Raesangur/UdeS_S7_APP1/datasheets/capacitors/cap_links.txt

https://www.youtube.com/watch?v=2MQyQUkwmMk
https://www.youtube.com/watch?v=BcJ6UdDx1vg
https://www.youtube.com/watch?v=usX_4WUa-PY
