Raesangur/UdeS_S7_APP1/P01 relève les bons coups de l'équipe P02.pdf

UNIVERSITÉ DE SHERBROOKE
Faculté de génie
Département de génie électrique et génie informatique

## VALIDATION ÉQUIPE P02

Conception avancée de systèmes électroniques GEI789

Présenté à
Jonathan Bouchard,
Réjean Fontaine

Présenté par
Frédéric BILODEAU – BILF0901 Pascal-Emmanuel-Lachance —LACP3102

### 30 janvier 2024

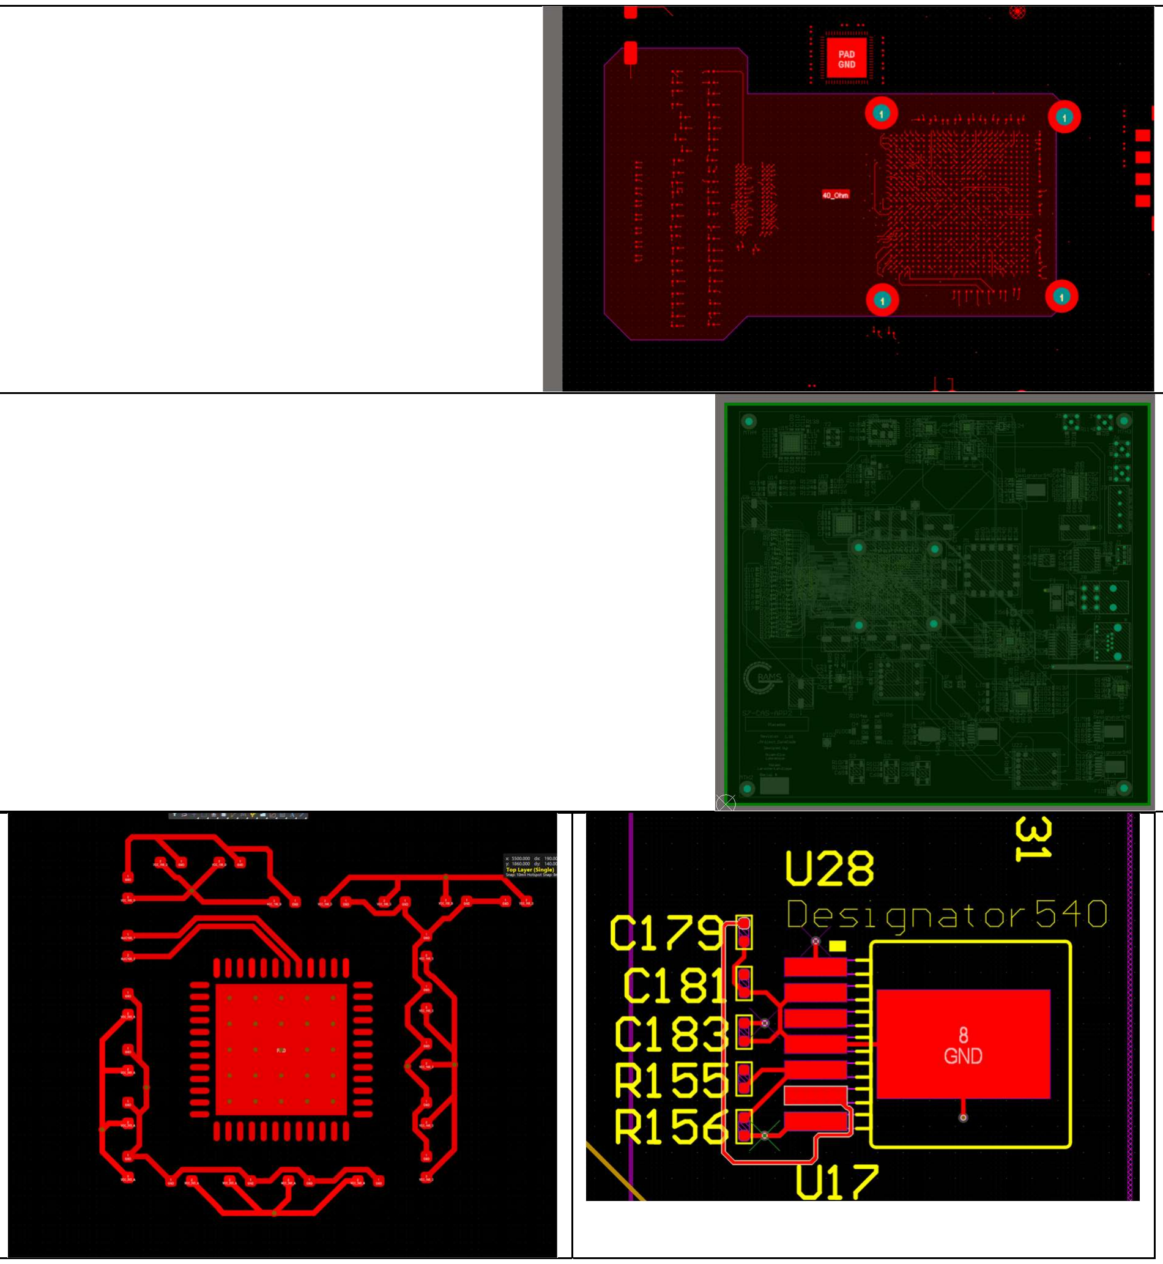
[picture p1: figure]

Mauvaise utilisation de room, les autres signaux comme le LVDS n’auront pas la bonne impédance sur la couche du top, celle que toutes les connections au FGPA sont obligé de faire (Room 40R plutôt que l’utilisation de Net Class).

Pas d’isolation (GND continu sur tout le PCB)

Idéalement il faut avoir un via de GND et de PWR pour chaque condensateur pour avoir le moins d’impédance possible sur ton power.

Il serait très pratique d’utiliser également le bottom pour mettre des composantes, ça aiderait à démêler tout les fils.

Qu’est-ce que `Designator540`?

Ça pourrait être pertinent d’utiliser des traces plus larges pour le power, encore pour réduire ton impédance. Ça s’applique autant aux régulateurs qu’à tous les condensateurs, surtout les gros électrolytiques.

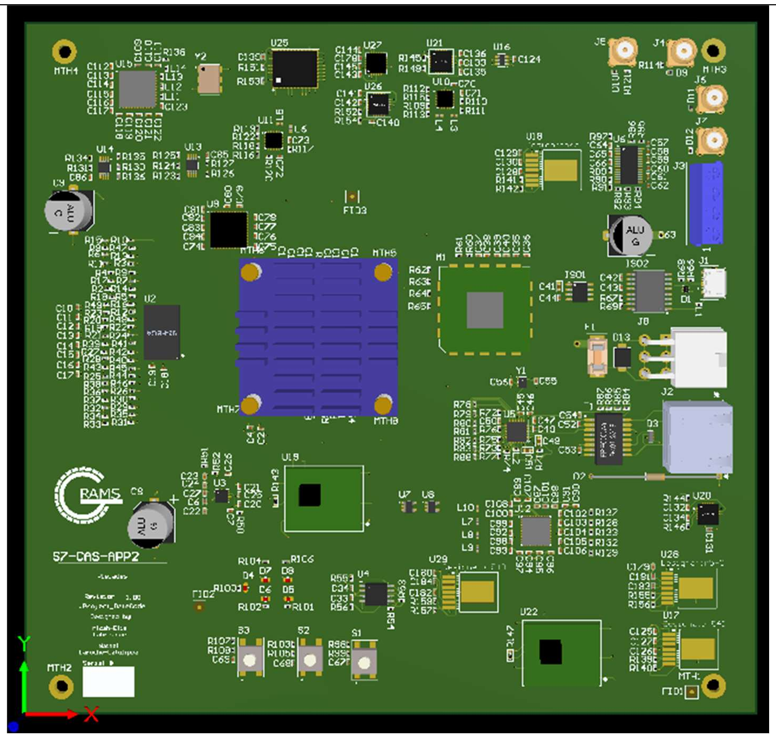
[picture p2: figure]

Beaucoup d’espace sur les côtés du PCB, ce qui facilite l’assemblage!
Le PCB est aussi d’une bonne taille qui rend le routage et le debugging plus facile.

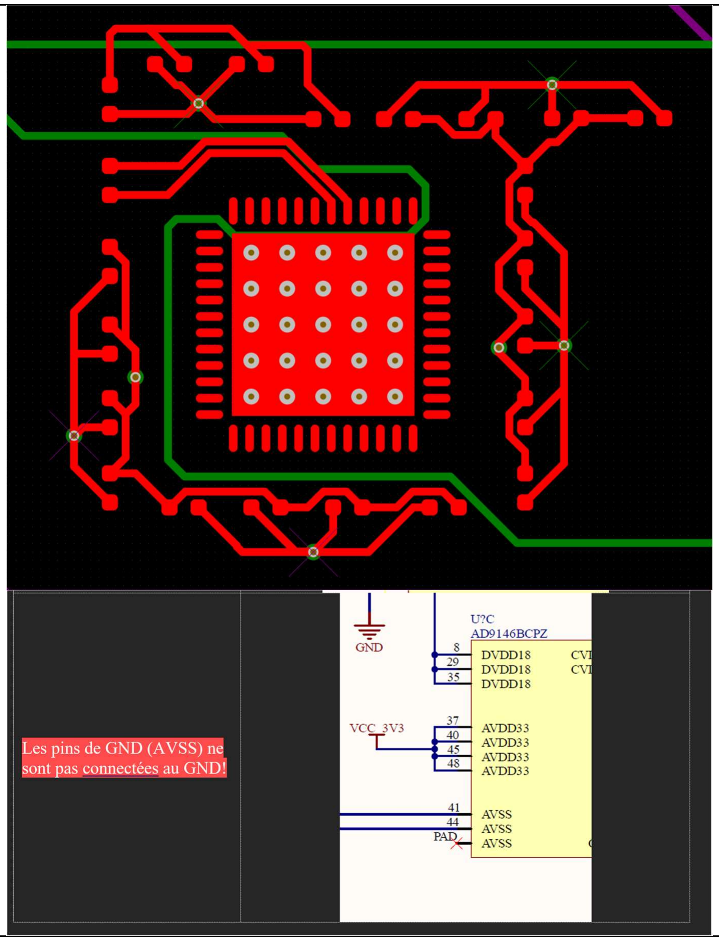
[picture p3: figure]

DAC sans GND
Le pad au centre n’est pas associé au NET GND. Voir commentaire de la revue de l’APP1

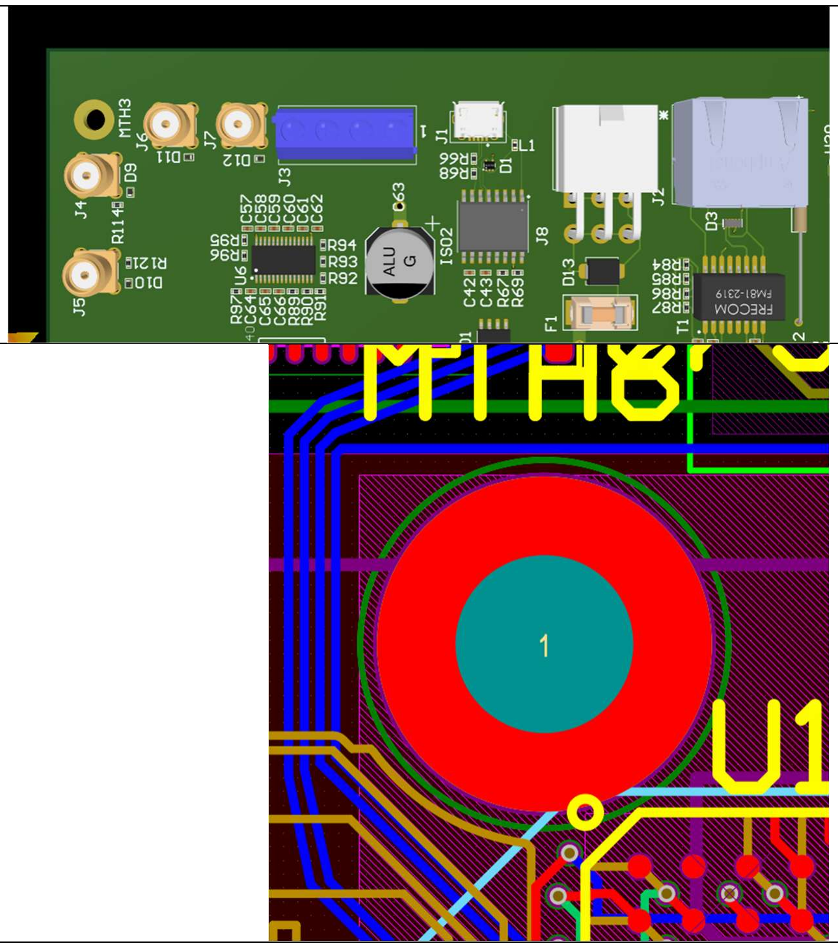
[picture p4: figure]

Très bien d’avoir mis tous les connecteurs d’un seul côté pour limiter l’effet d’antenne.

Le trou de montage du heatsink n’est pas connecté au GND, ce qui est important pour éviter que le heatsink agisse comme antenne.

Aussi qu’est-ce qui se passe avec les traces courbes?

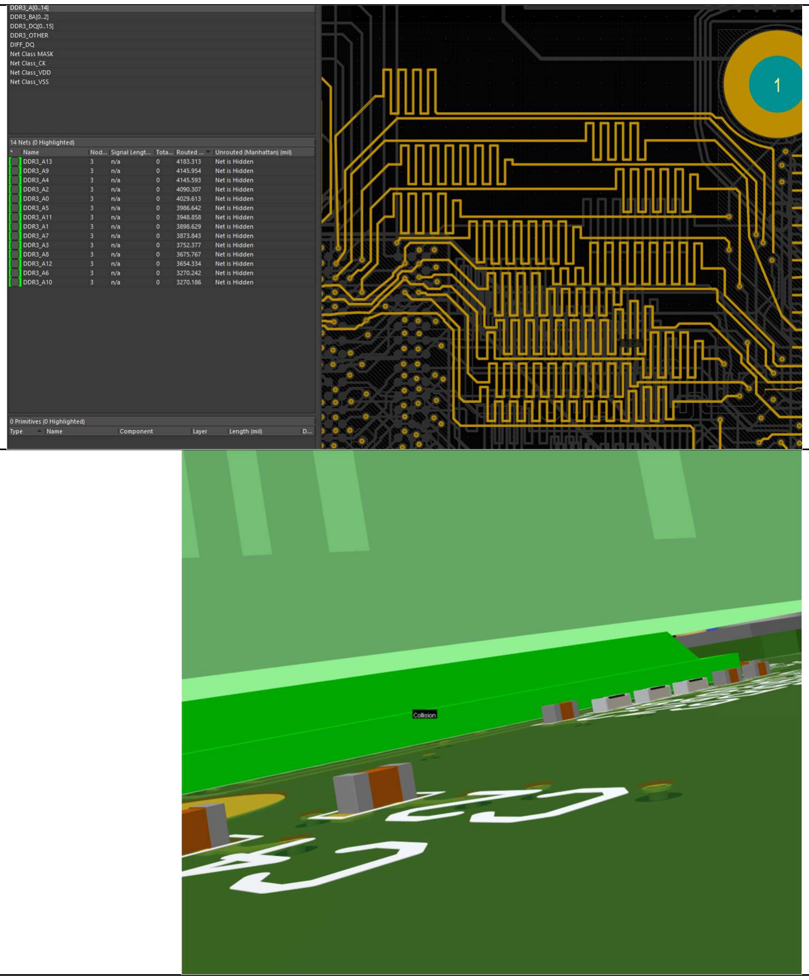
[picture p5: figure]

Le length matching n’est pas bien réalisé pour les adresses, avec plus d’un pouce de différence entre la trace la plus longue et la trace la plus courte.

Modele 3D non aligné.

Par contre c’est très cool d’avoir le modèle 3D pour le heatsink!

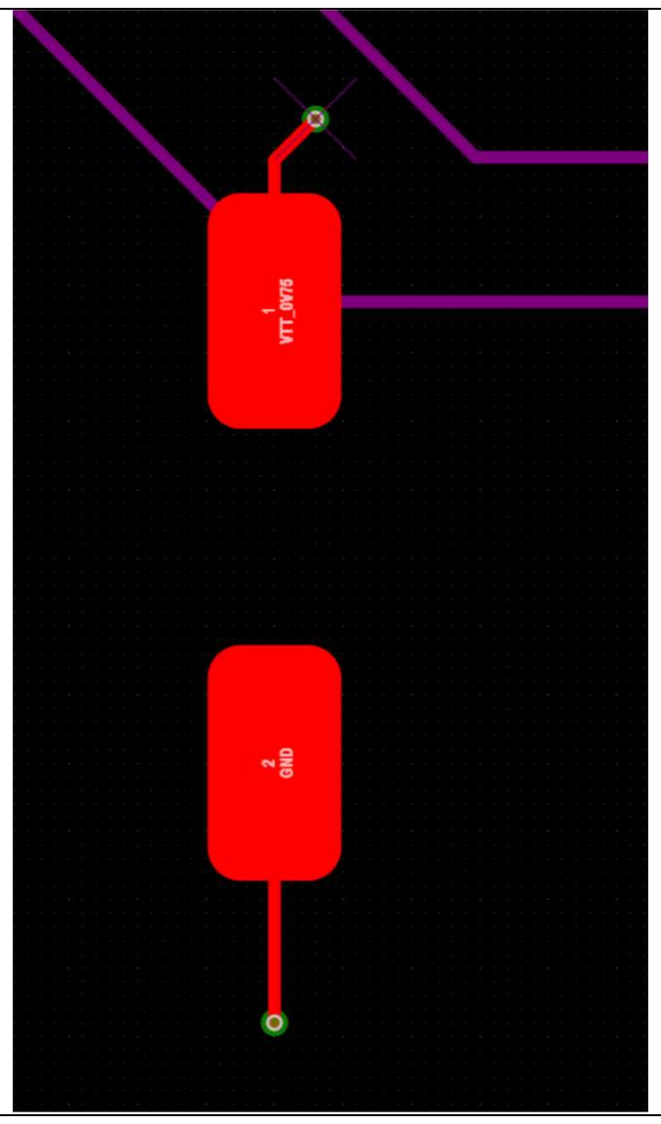
[picture p6: figure]

Distance des vias et largeurs des traces pour les grands condensateurs. J’aurais mis plus de vias des deux côtés ainsi que des traces plus larges pour réduire l’impédences

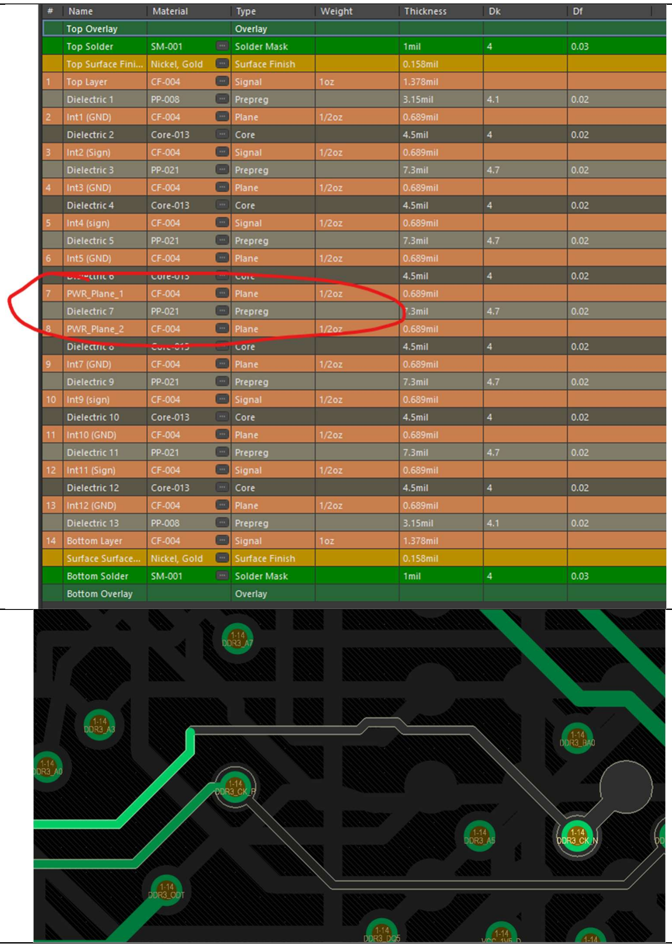
[picture p7: figure]

Il faut faire vraiment attention à des plans qui ne sont pas sandwitchés entre des GNDs, les deux couches de PWR peuvent se référencer entre elles et causer des effets indésirables.

Pas de via pour connecter CLK- entre Layer 3 et Layer 10!
Idéalement, lorsque tu as des changements de signaux, tu devrais aussi essayer de placer un via de GND proche afin de fournir un chemin pour le retour de courant.
Tu aurais pu router cette trace à partir de la layer

### 10 dès le début pour éviter le changement de

layer.

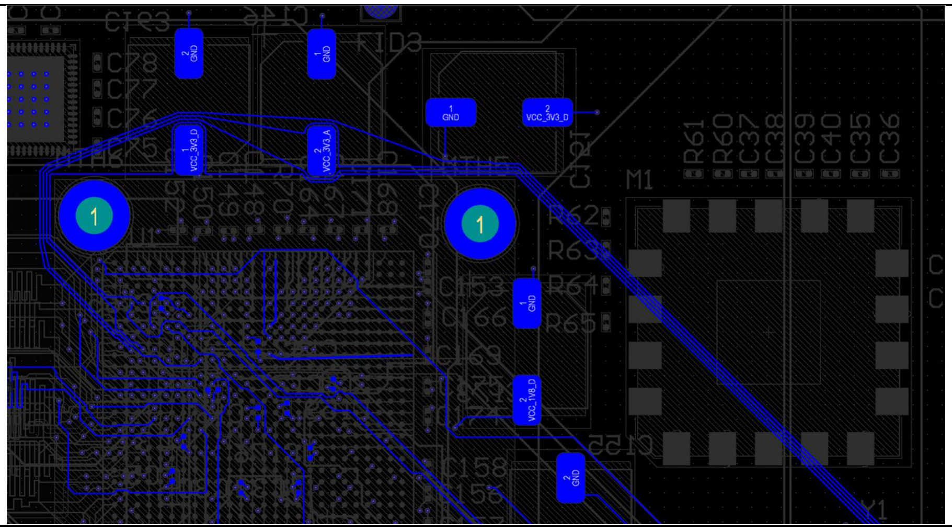
[picture p8: figure]

Il faudrait essayer de respecter la règle des « 3L » pour l’espacement entre des traces communiquant à haute vitesse.
Aussi encore qu’est-ce qui se passe autour des condensateurs ici??

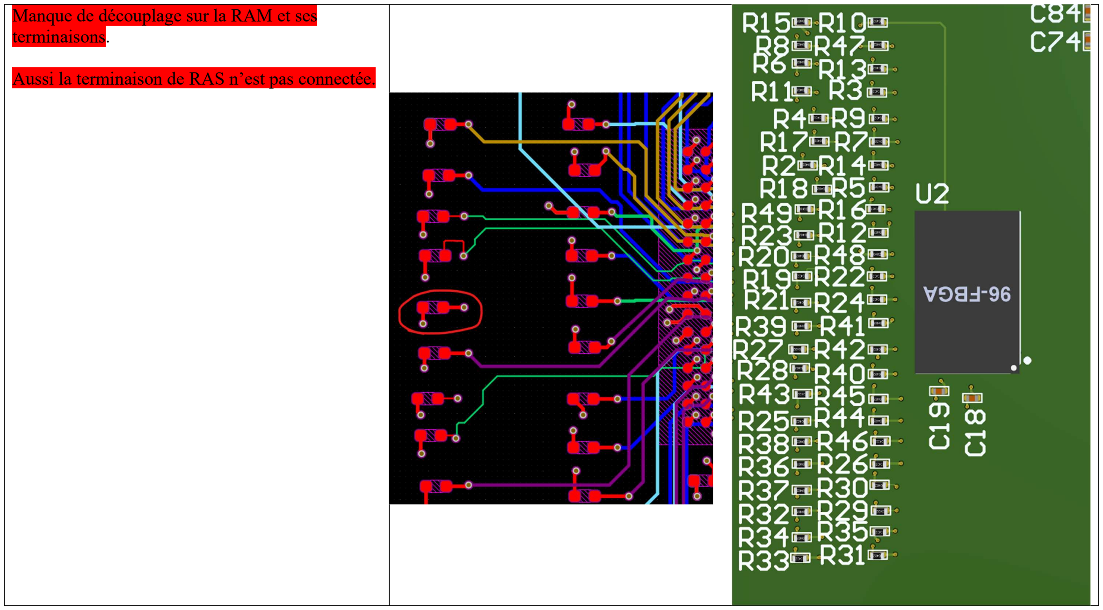
[picture p9: page 10]

Manque de découplage sur la RAM et ses terminaisons.

Aussi la terminaison de RAS n’est pas connectée.

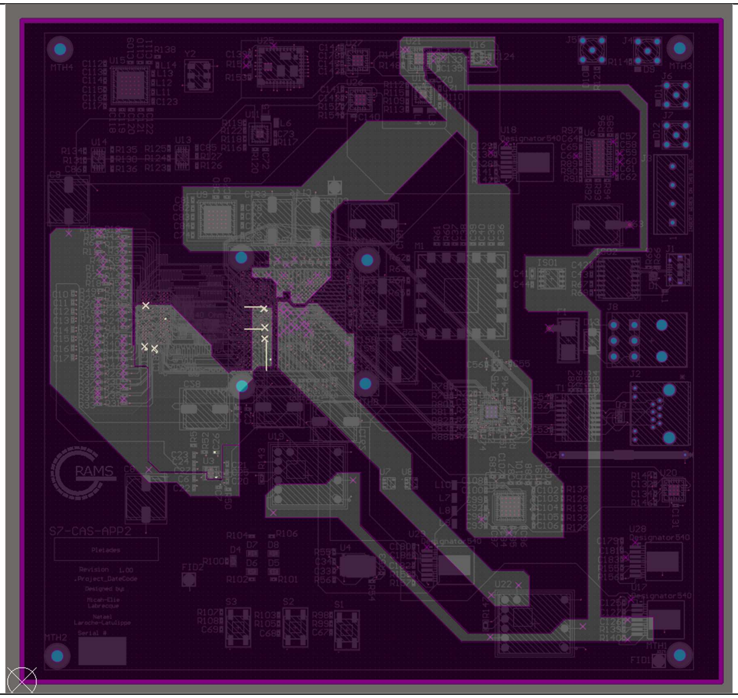
[picture p10: figure]

Gros planes de puissances qui aident à baisser l’impédance et qui relient bien les différentes sections avec des vias.
