Raesangur/UdeS_S7_APP1/Images/pleiades-constellation.png

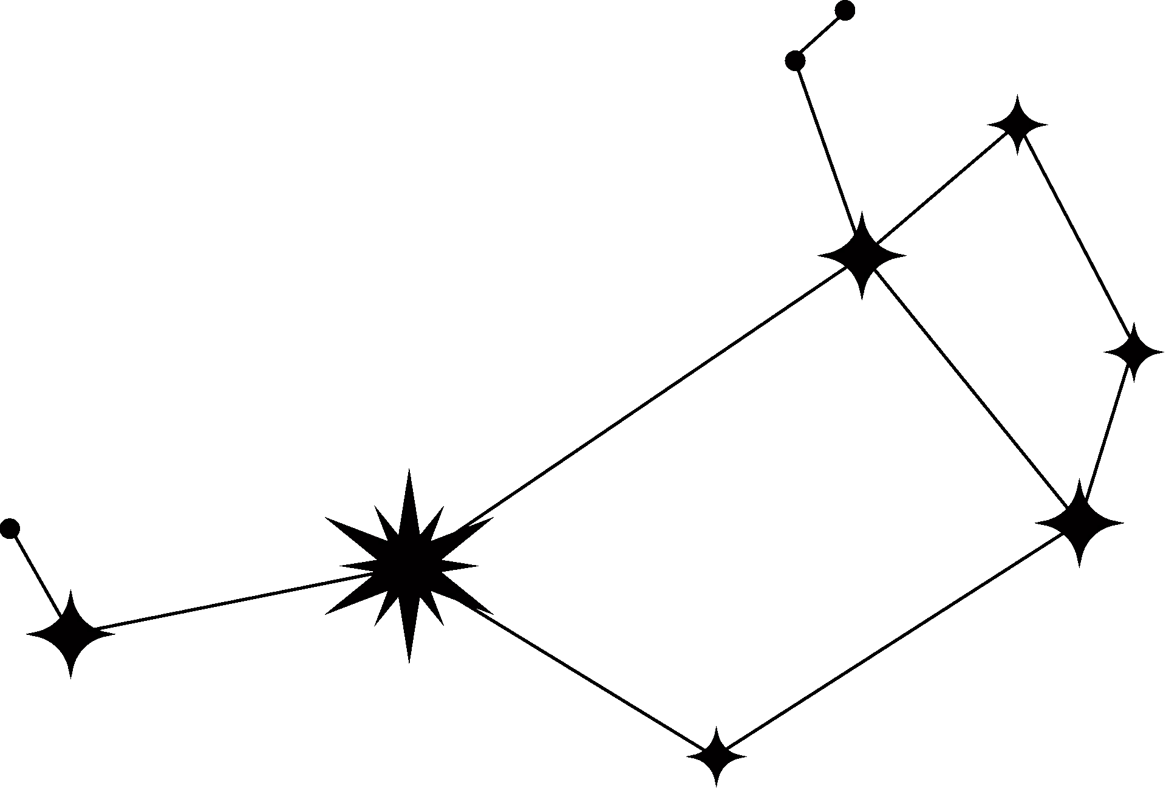
Images/pleiades-constellation.png
