Raesangur/UdeS_S7_APP1/Output/BOM.xlsx

Comment | Quantity | Designator | Description | Footprint | Mfr | Supplier 1 | Supplier Part Number 1
-6V | 1 | D47 | LED - 620nM RED 2mA - 0603 | LED_0603 |  | Digikey | 511-1304-1-ND
+1V2 | 1 | D45 | LED - 620nM RED 2mA - 0603 | LED_0603 |  | Digikey | 511-1304-1-ND
+1V8D | 1 | D50 | LED - 620nM RED 2mA - 0603 | LED_0603 |  | Digikey | 511-1304-1-ND
+2V5D | 1 | D51 | LED - 620nM RED 2mA - 0603 | LED_0603 |  | Digikey | 511-1304-1-ND
+3V3D | 1 | D48 | LED - 620nM RED 2mA - 0603 | LED_0603 |  | Digikey | 511-1304-1-ND
+6V | 1 | D49 | LED - 620nM RED 2mA - 0603 | LED_0603 |  | Digikey | 511-1304-1-ND
+12V | 1 | D46 | LED - 620nM RED 2mA - 0603 | LED_0603 |  | Digikey | 511-1304-1-ND
0R | 39 | R48, R49, R53, R57, R58, R63, R64, R65, R67, R68, R70, R167, R185, R187, R188, R191, R193, R196, R197, R202, R203, R212, R215, R221, R223, R226, R229, R230, R245, R247, R249, R259, R261, R263, R275, R283, R318, R319, RX25 |  | RES_0402
1K | 15 | R72, R73, R74, R75, R157, R182, R222, R289, R290, R308, R309, R312, R336, R337, RX13 |  | RES_0402
1K13 | 7 | R50, R90, R164, R273, R284, R322, RX12 |  | RES_0402
1M | 14 | R80, R81, R84, R165, R195, R205, R206, R213, R217, R225, R236, R317, R331, RX1 | 1M 0402 1% 1/16W Resistor | RES_0402
1nF | 18 | C1, C2, C3, C4, C219, C227, C228, C487, C502, C507, C508, C512, C544, C546, C549, C572, C603, CX15 | C1812C102KHRACAUTO 0402 470pF 10% X7R Ceramic Capacitor | CAP_1812 | KEMET | Mouser | 80-C1812C102KHRAUTO
1nF | 72 | C157, C166, C167, C168, C187, C188, C189, C207, C208, C209, C210, C211, C216, C217, C218, C248, C249, C255, C256, C264, C265, C271, C272, C296, C297, C298, C299, C300, C301, C302, C304, C305, C306, C310, C318, C319, C320, C321, C328, C329, C330, C331, C332, C341, C350, C351, C352, C362, C363, C369, C370, C387, C430, C432, C449, C515, C519, C523, C527, C553, C554, C567, C568, C575, C578, C584, C585, C590, C591, C597, C600, CX14 | GCM155R72A102KA37D 0402 1nF 10% X7R Ceramic Capacitor | CAP_0402 | Murata
1uF | 46 | C11, C18, C25, C32, C45, C46, C59, C60, C153, C161, C163, C181, C184, C201, C212, C274, C275, C276, C286, C287, C311, C326, C358, C398, C401, C404, C414, C434, C443, C444, C455, C466, C493, C496, C499, C534, C536, C550, C571, C573, C580, C581, C594, C595, C602, CX8 | GCJ31CR71H105KA12L 1206 1uF 10% X7R Ceramic Capacitor | CAP_1206 | Murata
2.2uF | 5 | C225, C226, C440, C524, CX7 | GRT31CR71H225KE13L 1206 2.2uF 10% X7R Ceramic Capacitor | CAP_1206 | Murata
3V3_PCI | 1 | D55 | LED - 620nM RED 2mA - 0603 | LED_0603 |  | Digikey | 511-1304-1-ND
4K7 | 23 | R14, R33, R47, R62, R87, R173, R179, R189, R194, R224, R246, R250, R251, R255, R256, R257, R258, R260, R262, R286, R320, R329, RX11 |  | RES_0402
4.7nF | 8 | C100, C371, C375, C381, C489, C492, C503, CX13 | GA343DR7GD472KW01L 0402 4.7nF 10% X7R 1812 250VAC Ceramic Capacitor | CAP_1812 | Murata
4.7uF | 12 | C103, C104, C113, C114, C115, C123, C128, C134, C139, C144, C148, CX4 | CGA8L2X7R1E475M160KA 1812 4.7uF 20% X7R Ceramic Capacitor | CAP_1206 | TDK | Newark | 57AK9414
5K1 | 10 | R158, R162, R163, R253, R287, R288, R313, R314, R327, RX10 |  | RES_0402
5V | 1 | D5 | LED - 620nM RED 2mA - 0603 | LED_0603 |  | Digikey | 511-1304-1-ND
5V_MOT | 1 | D34 | LED - 620nM RED 2mA - 0603 | LED_0603 |  | Digikey | 511-1304-1-ND
6K4 | 4 | R303, R311, R334, RX9 |  | RES_0402
10K | 21 | R82, R129, R142, R171, R172, R174, R175, R180, R181, R252, R271, R274, R276, R277, R278, R279, R295, R316, R338, R342, RX8 |  | RES_0402
10K5 | 5 | R214, R243, R244, R326, RX7 |  | RES_0402
10mR | 4 | R239, R241, R269, RX29 | CSRN2512FK10L0 | RES_2512
10uF | 38 | C101, C155, C159, C160, C162, C180, C183, C223, C230, C233, C234, C243, C250, C259, C266, C307, C338, C355, C365, C366, C384, C397, C400, C421, C425, C442, C445, C446, C447, C454, C483, C488, C490, C509, C531, C558, C562, CX6 | GRT31CR61H106KE01L 1206 10uF 10% X5R Ceramic Capacitor | CAP_1206 | Murata | Arrow Electronics, [NoParam] | GRT31CR61H106KE01L, [NoParam]
11R2 | 10 | R52, R93, R99, R104, R110, R112, R114, R119, R121, RX24 |  | RES_0402
12K | 4 | R89, R272, R324, RX6 |  | RES_0402
12V_PCI | 1 | D54 | LED - 620nM RED 2mA - 0603 | LED_0603 |  | Digikey | 511-1304-1-ND
16K9 | 2 | R339, RX5 |  | RES_0402
22pF | 8 | C197, C198, C199, C200, C510, C511, C530, CX19 | 0402 22pF 10% X7R 16V Ceramic Capacitor C0402C220K4RACAUTO, 0402 22pF X7R Ceramic Capacitor C0402C220K4RACAUTO | CAP_0402 | KEMET, [NoValue] | Mouser, [NoParam] | 80-C0402C220K4RAUTO, [NoParam]
22uF | 28 | C273, C285, C388, C389, C390, C392, C393, C394, C403, C407, C408, C413, C417, C433, C437, C438, C450, C451, C452, C462, C463, C465, C469, C470, C474, C475, C516, CX5 | CGA9P3X7R1H226M250KB 2220 22uF 20% X7R Ceramic Capacitor | CAP_2220 | TDK | Arrow Electronics | CGA9P3X7R1H226M250KB
24V_IN | 1 | D4 | LED - 620nM RED 2mA - 0603 | LED_0603 |  | Digikey | 511-1304-1-ND
24V_MOT | 1 | D33 | LED - 620nM RED 2mA - 0603 | LED_0603 |  | Digikey | 511-1304-1-ND
25K | 4 | R186, R218, R323, RX4 |  | RES_0402
30mR | 3 | R85, R240, RX28 | CSRN2512FK30L0 | RES_2512
40R2 | 40 | R15, R16, R17, R18, R19, R20, R21, R22, R23, R24, R25, R26, R27, R28, R29, R30, R31, R32, R34, R35, R36, R37, R38, R39, R40, R41, R42, R43, R44, R113, R120, R248, R296, R297, R298, R299, R300, R301, R302, RX23 |  | RES_0402
47K | 22 | R83, R86, R160, R161, R216, R242, R264, R265, R266, R267, R268, R270, R315, R325, R330, R343, R344, R345, R346, R347, R348, RX3 |  | RES_0402
47nF | 97 | C6, C7, C8, C9, C13, C14, C15, C16, C20, C21, C22, C23, C27, C28, C29, C30, C34, C35, C36, C37, C40, C41, C42, C43, C48, C49, C50, C51, C54, C55, C56, C57, C62, C63, C64, C65, C67, C68, C69, C70, C71, C72, C73, C74, C75, C76, C77, C78, C79, C80, C81, C82, C83, C84, C85, C86, C87, C88, C89, C90, C91, C92, C93, C94, C95, C96, C97, C98, C246, C247, C253, C254, C262, C263, C269, C270, C309, C314, C315, C316, C317, C340, C399, C402, C410, C411, C441, C456, C514, C518, C522, C526, C574, C579, C596, C601, CX12 | GCM155R71H473KE02J 0402 47nF 10% X7R Ceramic Capacitor | CAP_0402 | Murata
47uF | 4 | C416, C424, C557, CX3 | CGA9N1X7R1V476M230KC 2220 47uF 20% X7R Ceramic Capacitor | CAP_2220 | TDK | Newark | 57AK9414
49R9 | 25 | R91, R92, R125, R126, R127, R128, R130, R131, R132, R133, R134, R135, R136, R137, R138, R139, R140, R141, R143, R144, R145, R146, R147, R148, RX22 |  | RES_0603
56R2 | 3 | R98, R107, RX21 |  | RES_0402
60K4 | 2 | R117, R124 | RMCF0402FT60K4 | RES_0402
68pF | 19 | C172, C173, C174, C175, C176, C177, C178, C179, C193, C194, C195, C196, C281, C282, C283, C284, C292, C293, CX18 | 0201 68pF 5% C0G 50V Ceramic Capacitor CGA1A2C0G1H680J030BA, 0402 22pF 10% X7R 16V Ceramic Capacitor C0402C220K4RACAUTO | CAP_0402 | TDK, KEMET | Arrow Electronics, Mouser | CGA1A2C0G1H680J030BA, 80-C0402C220K4RAUTO
75R | 6 | R291, R292, R293, R294, R304, RX20 |  | RES_0402
100K | 25 | R54, R76, R77, R78, R79, R88, R111, R118, R149, R150, R151, R152, R154, R155, R159, R168, R176, R183, R220, R227, R228, R280, R281, R310, RX2 |  | RES_0402
100nF | 123 | C99, C132, C154, C156, C164, C165, C182, C185, C186, C202, C203, C204, C205, C206, C213, C214, C215, C220, C224, C235, C236, C237, C238, C239, C244, C245, C251, C252, C260, C261, C267, C268, C303, C308, C312, C313, C327, C339, C342, C343, C344, C347, C349, C356, C357, C359, C360, C361, C367, C368, C372, C373, C374, C376, C377, C378, C379, C380, C382, C383, C385, C386, C409, C419, C422, C423, C426, C427, C429, C431, C439, C448, C464, C471, C476, C477, C478, C479, C480, C484, C485, C486, C491, C494, C495, C497, C498, C504, C505, C506, C513, C517, C520, C521, C525, C528, C529, C532, C533, C535, C537, C538, C539, C540, C541, C542, C543, C545, C547, C548, C551, C552, C559, C560, C563, C564, C569, C570, C582, C583, C592, C593, CX11 | GCM155R71H104KE02J 0402 100nF 10% X7R Ceramic Capacitor | CAP_0402 | Murata
100R | 8 | R45, R46, R59, R61, R332, R333, R340, RX19 |  | RES_0402
120R | 2 | R166, RX18 |  | RES_0402
150mR | 4 | R153, R156, R219, RX27 | CSRN2512FKR150 | RES_2512
174R | 7 | R115, R116, R122, R123, R282, R307, RX17 |  | RES_0603
220nF | 5 | C345, C346, C348, C364, CX10 | GCM188R71H224KA64D 0603 220nF 10% X7R Ceramic Capacitor | CAP_0603 | Murata
240R | 4 | R13, R66, R305, RX16 |  | RES_0603
330pF | 29 | C158, C241, C242, C257, C258, C294, C295, C322, C323, C324, C325, C333, C334, C335, C336, C337, C555, C556, C565, C566, C576, C577, C586, C587, C588, C589, C598, C599, CX17 | GCM155R72A331KA37D 0402 330pF 10% X7R Ceramic Capacitor | CAP_0402 | Murata | Arrow Electronics | GCM155R72A331KA37D
330R | 8 | R60, R96, R97, R105, R106, R306, R328, RX15 | 1M 0603 1% 1/16W Resistor | RES_0603
410-357-B | 1 | M1 | MOD - JTAG-SMT3-NC Programming Module For Xilinx FPGA - 18-SMT | MOD_JTAG_410-357-B |  | Digi-Key | 1286-1196-ND
470nF | 58 | C5, C10, C12, C17, C19, C24, C26, C31, C33, C38, C39, C44, C47, C52, C53, C58, C61, C66, C105, C106, C107, C108, C109, C110, C116, C117, C118, C119, C120, C121, C124, C125, C126, C129, C130, C131, C135, C136, C140, C141, C142, C145, C146, C149, C288, C289, C391, C395, C396, C418, C428, C453, C457, C458, C459, C500, C501, CX9 | CGA3E3X7R1H474K080AB 0603 470nF 10% X7R Ceramic Capacitor | CAP_0402 | TDK
470pF | 14 | C169, C170, C171, C190, C191, C192, C240, C277, C278, C279, C280, C290, C291, CX16 | GCM155R71H471KA37J 0402 470pF 10% X7R Ceramic Capacitor | CAP_0402 | Murata
500mR | 3 | R184, R211, RX26 |  | RES_2512
590BD-BDG | 1 | Y1 | TIM - OSC PROG 125MHz ~ 214.999MHz LVDS 3.3V 7PPM EN/DS - 6-SMD | OSC_590BD-BDG |  | Digi-Key | 590BD-BDG-ND
768R | 17 | R94, R95, R100, R101, R102, R103, R108, R109, R169, R170, R177, R178, R254, R285, R321, R335, RX14 |  | RES_0402
3568 | 1 | F1 | FUSE HOLDER BLADE | 3568 | Keystone
0297010.WXNV | 1 | F2 | FUSE AUTO 10A 32V BLADE MINI | 0297010.WXNV | Littelfuse
0039300060 | 1 | J26 | CON - Mini-Fit Through Hole, Right Angle 6 position | CON_MINIFIT_0039300060 |  | Digi-Key | WM21353-ND
782633601 | 5 | FB1, FB2, FB3, FB4, FBX1 | 600 Ohms @ 100 MHz 1 Signal Line Ferrite Bead 0603 (1608 Metric) 1A 200mOhm | IND_0603 |  | Digikey | 732-6703-1-ND
782853152 | 5 | FB5, FB6, FB7, FB8, FBX2 | 600 Ohms @ 100 MHz 1 Signal Line Ferrite Bead 0603 (1608 Metric) 1A 200mOhm | IND_0805
5025700893 | 1 | J36 | 10 (8 + 2) Position Card Connector Secure Digital - microSD™ Surface Mount, Right Angle Gold | MICROSD_5025700893
74439346100 | 3 | L1, L4, LX2 | Generic Inductor | 74439346100 |  | Digikey | 732-10707-1-ND
ACPL-M72T | 2 | ISO1, ISO3 | Logic Output Optoisolator Push-Pull, Totem Pole 4000Vrms 1 Channel 25kV/µs CMTI 5-SO | SOIC-5_4.4MM | Broadcom Limited
AD8056ARMZ | 1 | U11 | OPAMP - VFB 300MHZ - 8MSOP | OPAMP_AD8056ARMZ |  | Digikey | AD8056ARMZ-REEL7CT-ND
AD9146BCPZ | 1 | U10 | DAC - 16BIT SRL HIGH SPEED - QFN-48 | DAC_AD9146BCPZ |  | Digikey | AD9146BCPZ-ND
ADA4927-2YCPZ-R2 | 1 | U9 | OPAMP - CFA 2.3GHZ - QFN-24 | OPAMP_ADA4927-2YCPZ-R2 |  | Digikey | ADA4927-2YCPZ-R2CT-ND
ADM3057EBRWZ | 1 | U17 | 1/1 Transceiver, Isolated CANbus 20-SOIC | SOIC-20_7.5mm | Analog Devices | Mouser | 584-ADM3057EBRWZ
ADM3260ARSZ | 1 | U47 | I2C Digital Isolator 2500Vrms 2 Channel 25kV/µs CMTI 20-SSOP (0.209", 5.30mm Width) | TSSOP-20_5.3MM | Analog Devices
ADN4652BRSZ-RL7 | 2 | U44, U46 |  | TSSOP-20_5.3MM | Analog Devices | Mouser | 584-ADN4652BRSZ-RL7
ADS62P48IRGCT | 1 | U8 | ADC - 14 BIT 210MSPS SUAL - VQFN-64 | ADC_ADS62P48IRGCT |  | Digikey | 296-24611-1-ND
ADS7957QDBTRQ1 | 1 | U41 | 10 Bit Analog to Digital Converter 16 Input 1 SAR 38-TSSOP | TSSOP-38_4.4MM | Texas Instruments | Mouser | 595-ADS7957QDBTRQ1
ADUM3160BRWZ-RL | 1 | ISO2 | ISO - DGTL ISO 2.5KV 2CH USB - 16SOIC | ISO_ADUM3160BRWZ-RL |  | Digi-Key | ADUM3160BRWZ-RLCT-ND
ASCH0010050547NJCP | 9 | L5, L6, L7, L8, L9, L10, L11, L12, LX1 | Generic Inductor | IND_0402 |  | Mouser, Digikey | 673-ASCH10050547NJCP, 553-ASCH00100505R10JCPTR-ND
ATS-CPX025025015-166-C1-R0 | 2 | HEAT1, HEAT3 | Heatsink Aluminium | ATS-CPX025025015-166-C1-R0 | Advanced Thermal Solutions Inc. | Digikey | ATS35911-ND
ATS-H1-152-C2-R0 | 1 | HEAT2 | Heatsink Aluminium | ATS-H1-152-C2-R0 | Advanced Thermal Solutions Inc. | Digikey | ATS36354-ND
B340B-13-F | 7 | D14, D15, D16, D17, D42, D43, DX2 | Generic Shottkey Diode, VS-15MQ040HM3/5AT | DO214AA (SMB) | Diodes Incorporated, [NoParam] | Future Electronics, [NoParam] | 6160261, [NoParam]
BATTERY_IN | 1 | J27 |  | XT90
BAV99-7-F | 25 | D1, D2, D19, D22, D25, D26, D27, D28, D29, D30, D31, D32, D36, D38, D39, D58, D59, D60, D61, D62, D63, D64, D65, D66, DX4 | Diode Array 1 Pair Series Connection 75 V 300mA (DC) Surface Mount TO-236-3, SC-59, SOT-23-3 | SOT23-3 | Diodes Incorporated | Future Electronics | 3851920
BSH105 | 2 | Q6, Q7 | BSH105 | SOT23-3 |  | Avnet | BSH105,215
CAN | 1 | D18 | LED - 611nM ORANGE 2mA - 0603 | LED_0603 |  | Digikey | 511-1303-1-ND
CAN_TERM | 1 | J34 |  | HEADER-2_100MIL
CANBUS | 1 | J33 |  | HEADER-4_100MIL
CDCE62005RGZT | 1 | U4 | TIM - CLK SYNTH JITTER CLEANER 3:5 - QFN-48 | TIM_CDCE62005RGZT |  | Digikey | 296-23947-1-ND
DEBUG1 | 1 | SW2 | SWI - TACT SPST-NO 0.05A 24V - 4-SMD | SWI_TACT_B3SN-3012P |  | Digikey | SW261CT-ND
DEBUG2 | 1 | SW3 | SWI - TACT SPST-NO 0.05A 24V - 4-SMD | SWI_TACT_B3SN-3012P |  | Digikey | SW261CT-ND
DEBUG IO CONNECTOR | 1 | J37 |  | HEADER-16_100MIL
DLM11SN900HY2L | 2 | L13, L14 | 2 Line Common Mode Choke Surface Mount 90 Ohms @ 100MHz 100mA DCR 1.38Ohm | DLM11SN900HY2L |  | Digi-Key | 490-11941-1-ND
DNF | 2 | C151, C152 | [NoValue], 0402 100nF X7R Ceramic Capacitor | CAP_0402
DNF | 36 | R1, R2, R3, R4, R5, R6, R7, R8, R9, R10, R11, R12, R51, R55, R56, R69, R71, R190, R192, R198, R199, R200, R201, R204, R207, R208, R209, R210, R231, R232, R233, R234, R235, R237, R238, R341 |  | RES_0402
DRV8811PWPR | 1 | U13 | POW - STEPPER MOTOR DRIVER - SOP-28 | POW_MOTOR_DRV8811PWPR |  | Digikey | 296-24591-1-ND
DS2411R | 1 | U21 | Silicon Serial Number SOT-23-3 | SOT23-3 | Analog Devices
FAN | 1 | J10 |  | FAN_HEADER-4
FQD8P10TM-F085 | 2 | Q1, Q2 | P-Channel 100 V 6.6A (Tc) 2.5W (Ta), 44W (Tc) Surface Mount TO-252AA | DPAK | onsemi
GST280A24-C6P | 1 | WA1 | UND - AC/DC DESKTOP ADAPTER 24V 280W - MEC | Model Name |  | Digi-Key | 1866-2122-ND
H1102NLT | 1 | T1 | TRANSFO - ETHERNET 10/100B-TX - SMD-16 | TRANSFO_H1102NLT |  | Digikey | 553-1532-1-ND
IN1 | 1 | J28 | 5-1814400-1 CONN - SMA JACK R/A 50 OHM - TH | CONN_SMA_5-1814400-1 |  | Digikey | A97593-ND
IN2 | 1 | J29 | 5-1814400-1 CONN - SMA JACK R/A 50 OHM - TH | CONN_SMA_5-1814400-1 |  | Digikey | A97593-ND
INA214AQDCKRQ1 | 1 | U35 | Current Sense Amplifier 1 Circuit Single-Ended SC-70-6 | SC-70-6 (SOT-363) | Texas Instruments | Mouser
INA4180A1QPWRQ1 | 2 | U40, U42 | Current Sense Amplifier 4 Circuit Differential, Rail-to-Rail 14-TSSOP | TSSOP-14_4.4MM | Texas Instruments | Mouser | 595-INA4180A1QPWRQ1
IRE-12/10-Q12P-C | 1 | U6 | Isolated DC/DC Converters - Through Hole 9V-36VIN 24VOUT 120W | IRE-Q12 | Murata | Digikey | 811-IRE-12/10-Q12P-C-ND
IRE-24/5-Q12P-C | 1 | U37 | Isolated DC/DC Converters - Through Hole 9V-36VIN 24VOUT 120W | IRE-Q12 | Murata | Mouser | 580-IRE-24/5-Q12P-C
ISO7741DBQR | 1 | U43 | ISO - Quad-Channel Digital Isolator 3/1 (Default High)- 16-SSOP | ISO_ISO7741DBQR |  | Digi-Key | 296-47660-1-ND
ISO7741FDBQR | 1 | U33 | ISO - Quad-Channel Digital Isolator 3/1 (Default Low)- 16-SSOP | ISO_ISO7741FDBQR |  | Digi-Key | 296-48140-1-ND
JUMPER | 12 | J2, J3, J4, J5, J11, J13, J14, J15, J16, J21, J24, J35
KSZ8091MNXCA | 1 | U38 | COM - ETHERNET PHY 10/100 - QFN-32 | COM_ETH_PHY_KSZ8091MNXCA |  | Digikey | 576-4356-ND
LED1 | 1 | D20 | LED - 611nM ORANGE 2mA - 0603 | LED_0603 |  | Digikey | 511-1303-1-ND
LED2 | 1 | D21 | LED - 611nM ORANGE 2mA - 0603 | LED_0603 |  | Digikey | 511-1303-1-ND
LED3 | 1 | D23 | LED - 611nM ORANGE 2mA - 0603 | LED_0603 |  | Digikey | 511-1303-1-ND
LED4 | 1 | D24 | LED - 611nM ORANGE 2mA - 0603 | LED_0603 |  | Digikey | 511-1303-1-ND
LFXTAL010595 | 1 | X1 | 25 MHz ±30ppm Crystal 16pF 40 Ohms HC-49/US | HC49_SMD |  | Newark | 94X0915
LMZ23605TZE/NOPB | 5 | U22, U27, U30, U31, U32 | REG - IC BUCK SYNC 36V 5A - TO-PMOD-7 | REG_SWR_LMZ23605TZE/NOPB |  | Digi-Key | 296-35357-1-ND
M3 | 8 | MT1, MT2, MT3, MT4, MT5, MT6, MT7, MT8 |  | MTH_M3
M3_SCREW | 14 | H2, H4, H6, H8, H10, H12, H14, H16, H18, H19, H20, H21, H22, H23
MAL214699108E3 | 4 | C221, C231, C481, CX1 | CAP - ALU 470uF 20% 50V - 1616 | CAP_ALU_1616_vishay |  | Digikey | 4442PHCT-ND
MAL215099101E3 | 24 | C102, C111, C112, C122, C127, C138, C143, C222, C232, C353, C354, C405, C406, C412, C415, C435, C436, C460, C467, C468, C472, C482, C561, CX2 | CAP - ALU 100uF 20% 50V - 1010 | CAP_ALU_1010_vishay |  | Digikey | 4399PHDKR-ND
MOT ON/OFF | 1 | SW4 | Slide Switch SPDT Through Hole | 1101M2S3CQE2 | C&K | Arrow Electronics | 1103M2S3CQE2
MOTORS | 1 | J32 | CONN - TERMINAL BLOCK 4POS 5MM - TH | CONN_TERMINAL_OSTTA040161 |  | Digikey | ED2602-ND
MT41K512M16HA-125 :A | 1 | U1 | DRAM 8G 1.35V 512Mx16 800 MHz DDR3 0C-90C | FBGA-96 | Alliance Memory | Mouser | 913-41K512M16HA125A
MTS-20 | 8 | H3, H5, H7, H9, H11, H13, H15, H17 |  | STANDOFF_MTS-20 |  | Digikey | RPC1573-ND
NCV2931ADT5.0RKG | 2 | U7, U36 |  | DPAK |  | Mouser | 863-NCV2931ADT5.0RKG
ON/OFF | 1 | SW1 | 1103M2S3CQE2 Slide Switch SPDT Through Hole | 1101M2S3CQE2 | C&K | Arrow Electronics | 1103M2S3CQE2
OPA991IDBVR | 1 | U39 | General Purpose Amplifier 1 Circuit Rail-to-Rail SOT-23-5 | SOT23-5 | Texas Instruments | Mouser | 595-OPA991IDBVR
OUT1 | 1 | J30 | 5-1814400-1 CONN - SMA JACK R/A 50 OHM - TH | CONN_SMA_5-1814400-1 |  | Digikey | A97593-ND
OUT2 | 1 | J31 | 5-1814400-1 CONN - SMA JACK R/A 50 OHM - TH | CONN_SMA_5-1814400-1 |  | Digikey | A97593-ND
PCI_RST | 1 | J22 |  | HEADER-2_100MIL
PLT10HH101150PNL | 2 | L2, L3 | IND - 2 Line Common Mode Choke Surface Mount 100 Ohms @ 10MHz 15A DCR 2.3 mOhm - SMD (12.9mm L x 6.6mm W x 9.4mm H) | IND_PLT10HH101150PNL |  | Digi-Key | 490-12821-1-ND
PTN04050AAZT | 1 | U25 | REG - SWR -15 ~ -3.3V 1A 6W - 5-SMD | REG_SWR_PTN04050AAZT |  | Digi-Key | 296-32208-1-ND
RESET | 1 | D41 | LED - 611nM ORANGE 2mA - 0603 | LED_0603 |  | Digikey | 511-1303-1-ND
RESET | 1 | SW5 | SWI - TACT SPST-NO 0.05A 24V - 4-SMD | SWI_TACT_B3SN-3012P |  | Digikey | SW261CT-ND
RFUSE | 1 | J23 |  | HEADER-2_100MIL
RJHSE-5385 | 1 | J39 | CONN - MOD JACK RJ45 R/A ETHERNET - TH | CONN_ETHERNET_RJHSE-5385 |  | Digikey | RJHSE-5385-ND
SI2310-TP | 3 | Q3, Q4, Q5 | TRX - MOSFET N-CH 60V 3A - SOT-23 | TRX_NMOS_SI2310-TP |  | Digi-Key | SI2310-TPMSCT-ND
SI8620EB-B-IS | 4 | U12, U14, U15, U16 | ISO - Dual-Channel Digital Isolator (default HI) - 8-SOIC | ISO_SI8620EB-B-IS |  | Digi-Key | SI8620EB-B-IS-ND
SI8640EB-B-IU | 1 | U45 | ISO - Quad-Channel Digital Isolator (default HI) - 16-SSOP | ISO_SI8640EB-B-IU |  | Digi-Key | 336-4288-ND
SMBJ5.0CA | 2 | D37, DX3 | TVS - BIDIR 5V 9.2V 600W - DO214AA | TVS_PWR_SMBJ5.0CA |  | Digi-Key | SMBJ5.0CALFCT-ND
SMBJ33-13 | 8 | D3, D10, D11, D12, D13, D52, D53, DX1 | 53.3V Clamp 11.3A Ipp Tvs Diode Surface Mount SMB | DO214AA (SMB) | SMBJ33CAQ-13-F
STWD100PYW83F | 1 | U3 | WATCHDOG CIRCUIT IC SUPERVISOR 1 CHANNEL SOT23-5 | SOT23-5 | ST | Mouser | 511-STWD100PYW83F
TAG_RST | 1 | J12 |  | HEADER-2_100MIL
Tag-Connect 10 pin | 1 | J1 |  | TC2050-NL
TC74A0-3.3VCTTR | 3 | U18, U19, U20 | SENS - TEMPERATURE SENSOR I2C/SMBUS - SOT23-5 | SEN_TEMP_TC74A0-3.3VCTTR |  | Digikey | TC74A0-3.3VCTDKR-ND
TCK_EXT_SELECT | 1 | J17 |  | HEADER-3_100MIL
TCK_SELECT | 1 | J6 |  | HEADER-3_100MIL
TDI_EXT_SELECT | 1 | J19 |  | HEADER-3_100MIL
TDI_SELECT | 1 | J8 |  | HEADER-3_100MIL
TDO_EXT_SELECT | 1 | J20 |  | HEADER-3_100MIL
TDO_SELECT | 1 | J9 |  | HEADER-3_100MIL
TLV1572ID | 1 | U34 |  | SOIC-8_3.8mm | Texas Instruments
TMS_EXT_SELECT | 1 | J18 |  | HEADER-3_100MIL
TMS_SELECT | 1 | J7 |  | HEADER-3_100MIL
TPD1E1B04DPYR | 4 | D6, D7, D8, D9 | TVS - TVS DIODE 3.6V 8.5V - 0402 | TVS_DATA_TPD1E1B04DPYR |  | Digi-Key | 296-47364-1-ND
TPD2E001DRLR | 2 | D35, D57 | TVS - USB TVS DIODE 5.5V - SOT-553 | TVS_USB_TPD2E001DRLR |  | Digi-Key | 296-21883-1-ND
TPD4E05U06 | 2 | D44, D56 | TVS - TVS DIODE 5.5VWM 14VC - 10SON | TVS_DATA_TPD4E05U06 |  | Digi-Key | 296-35765-1-ND
TPS7A3301RGWR | 1 | U26 | REG - LDO Negative Adjustable 1 Output -1.18V-33V 1A - 20-VQFN (5x5) | REG_LDO_TPS7A3301RGWR |  | Digi-Key | 296-39502-1-ND
TPS7A4701RGWR | 3 | U23, U24, U29 | REG - LINEAR POS ADJ 1A - 20VQFN | REG_TPS7A4701RGWR |  | Digi-Key | 296-37224-1-ND
TPS51200DRCT | 1 | U28 | REG - DDR TERMINATION/REF REG - 10-VFDFN | REG_PMIC_TPS51200DRCT |  | Digi-Key | 296-23830-1-ND
UJ31-CH-G2-SMT-TR | 1 | J38 | Type C, USB 3.1 Gen 2, 5 A, Right Angle, Surface Mount _SMT_, USB Receptacle | UJ31-CH-G2-SMT-TR | CUI Devices | Digi-Key | 102-4483-1-ND
USB | 1 | D40 | LED - 620nM RED 2mA - 0603 | LED_0603 |  | Digikey | 511-1304-1-ND
WDT_RST_EN | 1 | J25 |  | HEADER-2_100MIL
XC6SLX100-3FGG676C | 1 | U2 | FPGA - XILINX SPARTAN 6 480 I/O - BGA-676 | FPGA_XILINX_FGG676 |  | Digikey | 122-1760-ND
XCF32PFSG48C | 1 | U5 | IC PROM SRL/PAR 1.8V 32M 48CSBGA | TFBGA-48_0.8MM_8X9 | Xilinx
