Raesangur/UdeS_S7_APP1/datasheets/ddr3/ddr3_ddr3l_power_calc.xlsm

Sheet: Title
File Name | : | DDR3_Power_Calc.XLSM
Revision | : | 1.02
Date | : | 2020-11-02
E-Mail | : | dramsupport@micron.com
Company | : | Micron Technology, Inc.
Description | : | Calculates the power consumed by a DDR3 and DDR3L SDRAM based on system use parameters and the device data sheet.
Limitations | :
Notes | :
Disclaimer | : | THIS SPREADSHEET IS FOR ESTIMATING PURPOSES ONLY. ANY INFORMATION PROVIDED HEREIN IS PROVIDED "AS IS" AND WITHOUT WARRANTIES OF ANY KIND. MICRON WARRANTS ONLY THAT ITS PRODUCTS COMPLY WITH MICRON'S SPECIFICATION SHEET FOR THE PRODUCT AT THE TIME OF DELIVERY; PROVIDED THAT DEVIATIONS FROM SPECIFICATIONS WHICH DO NOT MATERIALLY AFFECT FORM, FIT OR FUNCTION OF SUCH PRODUCT IN THE SYSTEM AND CONFIGURATION IN OR FOR WHICH IT IS INITIALLY INSTALLED OR QUALIFIED BY CUSTOMER SHALL NOT BE DEEMED TO CONSTITUTE FAILURE TO COMPLY WITH SUCH SPECIFICATIONS.
 |  | SEE MICRON'S STANDARD TERMS AND CONDITIONS OF SALE FOR COMPLETE WARRANTY DETAILS.
 |  | Copyright © 2007 Micron Semiconductor Products, Inc.
 |  | All rights reserved.

Sheet: Instructions
Instructions for Use
 | DDR3 Spec tab (ALL MUST BE VERIFIED FOR A SPECIFIC DRAM DATA SHEET)
 |  | Inputs are required for all densities and speed grades that may be chosen.
 |  | Enter VDD tolerance range in rows 6–7.
 |  | Enter IDD values for the speed grade under investigation in rows 9–26. Note that there are entries for both x4/x8 devices, as well as x16. Also note the two separate entries for IDD3P, depending on the mode register setting.
 |  | Timing restrictions in rows 28–36 are entered from the data sheet. These determine the test conditions for the IDD values and restrictions of normal device operation.
 | DDR3 Config tab (ALL MUST BE ENTERED TO IDENTIFY DRAM TO BE USED FOR POWER CALCULATION)
 |  | Row 7 selects which DRAM density.
 |  | Row 8 selects the number of DQs.
 |  | Row 9 selects the starting speed grade.
 |  | Row 10 selects low voltage or nominal.
 |  | Row 11 selects whether fast or slow exit is used for power-down exit.
 | DDR3 Spec tab (ALL MUST BE ENTERED FOR SPECIFIC SYSTEM)
 |  | Row 7 is the actual VDD the system is operating at. It is usually set to nominal conditions.
 |  | Row 8 is the clock rate the DRAM is operating at. This is one half of the data rate.
 |  | Row 9 is the burst length programmed in the mode register. (The model does not calculate power if burst interrupt is utilized.)
 |  | Row 10* is the amount of power that is drawn per output while driving read data from itself.
 |  | Row 11* is the amount of power that is drawn per output while terminating write data to itself.
 |  | Row 12* is the amount of power that is drawn per DQ while terminating read data at different DRAM (two or more loads).
 |  | Row 13* is the amount of power that is drawn per DQ while terminating write data at different DRAM (two or more loads).
 |  | *These are system-dependent and must be calculated. The value may be approximated with a DC calculation (calculator provided) or more accurately determined using SPICE models.
 |  | Row 15 is the time when all banks are in a precharged state. This is the amount of time when no bank has been activated.
 |  | Row 16 is the percentage of time that all that banks are precharged when the device is in power-down state. This is the percentage of time when the DRAM is using IDD2P vs. IDD2F.
 |  | Row 17 is the percentage of DRAM active time when CKE is LOW and the device is in the power-down state. This is the percentage of active time when the DRAM is using IDD3P current vs. IDD3N.
 |  | Row 19 is the average time between ACT commands to the DRAM. Under IDD0 or IDD1 conditions, this would be equal to tRC. If the DRAM is in interleaving bursts, it may be less than tRC. This value is now calculated off of page hit rate. Entering a number here will override the automatic calculation.
 |  | Row 21 is the percentage of clocks that data is read from the DRAM. This would be equal to the average read bandwidth divided by peak read bandwidth.
 |  | Row 22 is the percentage of clocks that data is written to the DRAM. This would be equal to the average read bandwidth divided by peak read bandwidth.
 |  | Row 23 is the page hit rate. 0% means there are no page hits (i.e., one read/write per each activate).
 |  | Row 24 is the percentage of clock cycles the DRAM under investigation is terminating read data from another device. It does not include time when a different DRAM on the bus may be terminating data.
 |  | Row 25 is the percentage of clock cycles the DRAM under investigation is terminating write data from another device. It does not include time when a different DRAM on the bus may be terminating data.
 | Power Calcs tab
 |  | No inputs are required for this tab. It contains some of the detail calculations that provide information into the Summary tab. It can be used as a reference for further understanding the calculator, or you may jump straight to the Summary page for the final answer.
 | Summary tab
 |  | No inputs are required for this tab. It contains a summary of the power used by the DRAM. The power is broken out between: — Power to read/write data to and from the DRAM — Power to activate the rows — Background power for standby modes and refresh

Sheet: DDR3 Spec
 |  |  | 1Gb |  |  |  |  |  |  |  |  |  | 2Gb |  |  |  |  |  |  |  |  |  | 4Gb |  |  |  |  |  |  |  |  |  | 8Gb |  |  |  |  |  |  |  |  |  | 16Gb
Parameter | Condition | Condition | -093E | -093 | -107E | -107 | -125E | -125 | -15E | -187E | -187 | -25 | -093E | -093 | -107E | -107 | -125E | -125 | -15E | -187E | -187 | -25 | -093E | -093 | -107E | -107 | -125E | -125 | -15E | -187E | -187 | -25 | -093E | -093 | -107E | -107 | -125E | -125 | -15E | -187E | -187 | -25 | -093E | -093 | -107E | -107 | -125E | -125 | -15E | -187E | -187 | -25
 | Maximum VDD |  | 1.435 | 1.435 | 1.435 | 1.435 | 1.435 | 1.435 | 1.435 | 1.435 | 1.435 | 1.435 | 1.435 | 1.435 | 1.435 | 1.435 | 1.435 | 1.435 | 1.435 | 1.435 | 1.435 | 1.435 | 1.435 | 1.435 | 1.435 | 1.435 | 1.435 | 1.435 | 1.435 | 1.435 | 1.435 | 1.435 | 1.435 | 1.435 | 1.435 | 1.435 | 1.435 | 1.435 | 1.435 | 1.435 | 1.435 | 1.435 | 1.435 | 1.435 | 1.435 | 1.435 | 1.435 | 1.435 | 1.435 | 1.435 | 1.435 | 1.435 | V
 | Minimum VDD |  | 1.283 | 1.283 | 1.283 | 1.283 | 1.283 | 1.283 | 1.283 | 1.283 | 1.283 | 1.283 | 1.283 | 1.283 | 1.283 | 1.283 | 1.283 | 1.283 | 1.283 | 1.283 | 1.283 | 1.283 | 1.283 | 1.283 | 1.283 | 1.283 | 1.283 | 1.283 | 1.283 | 1.283 | 1.283 | 1.283 | 1.283 | 1.283 | 1.283 | 1.283 | 1.283 | 1.283 | 1.283 | 1.283 | 1.283 | 1.283 | 1.283 | 1.283 | 1.283 | 1.283 | 1.283 | 1.283 | 1.283 | 1.283 | 1.283 | 1.283 | V
IDD0 | Maximum active precharge current | x4/x8 | na | 46 | na | 43 | na | 42 | 41 | 39 | na | na | na | 46 | na | 43 | na | 42 | 41 | 39 | na | na | na | 31 | na | 29 | na | 28 | na | na | na | na | na | na | 69 | 69 | 67 | 67 | na | na | na | na | na | na | na | na | na | na | na | na | na | na | mA
 |  | x16 | na | 55 | na | 51 | na | 49 | 48 | 46 | na | na | na | 55 | na | 51 | na | 49 | 48 | 46 | na | na | na | 34 | na | 32 | na | 32 | na | na | na | na | na | na | 69 | 69 | 67 | 67 | na | na | na | na | na | na | 85 | 85 | 83 | 83 | na | na | na | na | mA
IDD2P (Slow) | Maximum precharge power-down standby current(Slow Exit) | x4/x8 | na | 12 | na | 12 | na | 12 | 12 | 12 | na | na | na | 12 | na | 12 | na | 12 | 12 | 12 | na | na | na | 12 | na | 11 | na | 10 | na | na | na | na | na | na | 11 | 11 | 11 | 11 | na | na | na | na | na | na | na | na | na | na | na | na | na | na | mA
 |  | x16 | na | 12 | na | 12 | na | 12 | 12 | 12 | na | na | na | 12 | na | 12 | na | 12 | 12 | 12 | na | na | na | 12 | na | 12 | na | 12 | na | na | na | na | na | na | 11 | 11 | 11 | 11 | na | na | na | na | na | na | 22 | 22 | 22 | 22 | na | na | na | na | mA
IDD2P (Fast) | Maximum precharge power-down standby current(Fast Exit) | x4/x8 | na | 15 | na | 15 | na | 15 | 15 | 15 | na | na | na | 15 | na | 15 | na | 15 | 15 | 15 | na | na | na | 13 | na | 11 | na | 11 | na | na | na | na | na | na | 16 | 16 | 14 | 14 | na | na | na | na | na | na | na | na | na | na | na | na | na | na | mA
 |  | x16 | na | 15 | na | 15 | na | 15 | 15 | 15 | na | na | na | 15 | na | 15 | na | 15 | 15 | 15 | na | na | na | 14 | na | 12 | na | 12 | na | na | na | na | na | na | 16 | 16 | 14 | 14 | na | na | na | na | na | na | 27 | 27 | 25 | 25 | na | na | na | na | mA
IDD2N | Maximum precharge standby current | x4/x8 | na | 23 | na | 23 | na | 23 | 23 | 23 | na | na | na | 23 | na | 23 | na | 23 | 23 | 23 | na | na | na | 22 | na | 17 | na | 16 | na | na | na | na | na | na | 38 | 38 | 36 | 36 | na | na | na | na | na | na | na | na | na | na | na | na | na | na | mA
 |  | x16 | na | 23 | na | 23 | na | 23 | 23 | 23 | na | na | na | 23 | na | 23 | na | 23 | 23 | 23 | na | na | na | 22 | na | 17 | na | 17 | na | na | na | na | na | na | 38 | 38 | 36 | 36 | na | na | na | na | na | na | 49 | 49 | 47 | 47 | na | na | na | na | mA
IDD3P | Maximum active power-down standby current | x4/x8 | na | 17 | na | 17 | na | 17 | 17 | 17 | na | na | na | 22 | na | 22 | na | 22 | 22 | 22 | na | na | na | 17 | na | 15 | na | 15 | na | na | na | na | na | na | 38 | 38 | 36 | 36 | na | na | na | na | na | na | na | na | na | na | na | na | na | na | mA
 |  | x16 | na | 17 | na | 17 | na | 17 | 17 | 17 | na | na | na | 22 | na | 22 | na | 22 | 22 | 22 | na | na | na | 19 | na | 17 | na | 17 | na | na | na | na | na | na | 38 | 38 | 36 | 36 | na | na | na | na | na | na | 49 | 49 | 47 | 47 | na | na | na | na | mA
IDD3N | Maximum active standby current | x4/x8 | na | 40 | na | 37 | na | 35 | 33 | 31 | na | na | na | 40 | na | 37 | na | 35 | 33 | 31 | na | na | na | 23 | na | 21 | na | 20 | na | na | na | na | na | na | 53 | 53 | 51 | 51 | na | na | na | na | na | na | na | na | na | na | na | na | na | na | mA
 |  | x16 | na | 43 | na | 38 | na | 37 | 36 | 33 | na | na | na | 43 | na | 39 | na | 37 | 36 | 33 | na | na | na | 25 | na | 23 | na | 22 | na | na | na | na | na | na | 53 | 53 | 51 | 51 | na | na | na | na | na | na | 64 | 64 | 62 | 62 | na | na | na | na | mA
IDD4R | Maximum read burst current | x4 | na | 125 | na | 110 | na | 100 | 88 | 74 | na | na | na | 120 | na | 106 | na | 96 | 84 | 70 | na | na | na | 110 | na | 90 | na | 90 | na | na | na | na | na | na | 135 | 135 | 125 | 125 | na | na | na | na | na | na | na | na | na | na | na | na | na | na | mA
 |  | x8 | na | 125 | na | 110 | na | 100 | 88 | 74 | na | na | na | 125 | na | 110 | na | 100 | 88 | 74 | na | na | na | 110 | na | 90 | na | 90 | na | na | na | na | na | na | 135 | 135 | 125 | 125 | na | na | na | na | na | na | na | na | na | na | na | na | na | na | mA
 |  | x16 | na | 180 | na | 155 | na | 135 | 115 | 95 | na | na | na | 180 | na | 155 | na | 135 | 115 | 95 | na | na | na | 130 | na | 120 | na | 110 | na | na | na | na | na | na | 195 | 195 | 185 | 185 | na | na | na | na | na | na | 211 | 211 | 201 | 201 | na | na | na | na | mA
IDD4W | Maximum write burst current | x4 | na | 126 | na | 114 | na | 103 | 91 | 79 | na | na | na | 122 | na | 110 | na | 99 | 87 | 75 | na | na | na | 110 | na | 90 | na | 90 | na | na | na | na | na | na | 135 | 135 | 125 | 125 | na | na | na | na | na | na | na | na | na | na | na | na | na | na | mA
 |  | x8 | na | 126 | na | 114 | na | 103 | 91 | 79 | na | na | na | 126 | na | 114 | na | 103 | 91 | 79 | na | na | na | 110 | na | 90 | na | 90 | na | na | na | na | na | na | 135 | 135 | 125 | 125 | na | na | na | na | na | na | na | na | na | na | na | na | na | na | mA
 |  | x16 | na | 184 | na | 164 | na | 146 | 127 | 107 | na | na | na | 184 | na | 164 | na | 146 | 127 | 107 | na | na | na | 140 | na | 130 | na | 120 | na | na | na | na | na | na | 195 | 195 | 185 | 185 | na | na | na | na | na | na | 211 | 211 | 201 | 201 | na | na | na | na | mA
IDD5B | Maximum burst refresh current | x4/x8 | na | 170 | na | 165 | na | 160 | 160 | 155 | na | na | na | 190 | na | 184 | na | 182 | 181 | 179 | na | na | na | 160 | na | 152 | na | 152 | na | na | na | na | na | na | 250 | 250 | 245 | 245 | na | na | na | na | na | na | na | na | na | na | na | na | na | na | mA
 |  | x16 | na | 170 | na | 165 | na | 160 | 160 | 155 | na | na | na | 190 | na | 184 | na | 182 | 181 | 179 | na | na | na | 160 | na | 156 | na | 156 | na | na | na | na | na | na | 250 | 250 | 245 | 245 | na | na | na | na | na | na | 261 | 261 | 256 | 256 | na | na | na | na | mA
 | tCK used for current measurements (see current notes) |  | 0.938 | 0.938 | 1.07 | 1.07 | 1.25 | 1.25 | 1.5 | 1.875 | 1.875 | 2.5 | 0.938 | 0.938 | 1.07 | 1.07 | 1.25 | 1.25 | 1.5 | 1.875 | 1.875 | 2.5 | 0.938 | 0.938 | 1.07 | 1.07 | 1.25 | 1.25 | 1.5 | 1.875 | 1.875 | 2.5 | 0.938 | 0.938 | 1.07 | 1.07 | 1.25 | 1.25 | 1.5 | 1.875 | 1.875 | 2.5 | 0.938 | 0.938 | 1.07 | 1.07 | 1.25 | 1.25 | 1.5 | 1.875 | 1.875 | 2.5 | ns
tRRD | Minimum activate-to-activate timing (different bank) | x4/x8 | 6 | 6 | 6 | 6 | 6 | 6 | 6 | 7.5 | 7.5 | 10 | 6 | 6 | 6 | 6 | 6 | 6 | 6 | 7.5 | 7.5 | 10 | 6 | 6 | 6 | 6 | 6 | 6 | 6 | 7.5 | 7.5 | 10 | 6 | 6 | 6 | 6 | 6 | 6 | 6 | 7.5 | 7.5 | 10 | 6 | 6 | 6 | 6 | 6 | 6 | 6 | 7.5 | 7.5 | 10 | ns
 |  | x16 | 7.5 | 7.5 | 7.5 | 7.5 | 7.5 | 7.5 | 7.5 | 10 | 10 | 10 | 7.5 | 7.5 | 7.5 | 7.5 | 7.5 | 7.5 | 7.5 | 10 | 10 | 10 | 7.5 | 7.5 | 7.5 | 7.5 | 7.5 | 7.5 | 7.5 | 10 | 10 | 10 | 7.5 | 7.5 | 7.5 | 7.5 | 7.5 | 7.5 | 7.5 | 10 | 10 | 10 | 7.5 | 7.5 | 7.5 | 7.5 | 7.5 | 7.5 | 7.5 | 10 | 10 | 10 | ns
tRC | Minimum activate-to-activate timing (same bank) |  | 45.155 | 46.09 | 46.84 | 47.91 | 47.5 | 48.75 | 49.5 | 50.625 | 52.5 | 52.5 | 45.155 | 46.09 | 46.84 | 47.91 | 47.5 | 48.75 | 49.5 | 50.625 | 52.5 | 52.5 | 45.155 | 46.09 | 46.84 | 47.91 | 47.5 | 48.75 | 49.5 | 50.625 | 52.5 | 52.5 | 45.155 | 46.09 | 46.84 | 47.91 | 47.5 | 48.75 | 49.5 | 50.625 | 52.5 | 52.5 | 45.155 | 46.09 | 46.84 | 47.91 | 47.5 | 48.75 | 49.5 | 50.625 | 52.5 | 52.5 | ns
tRAS | tRAS used for IDD0 calculation |  | 36 | 36 | 34 | 34 | 35 | 35 | 36 | 37.5 | 37.5 | 37.5 | 36 | 36 | 34 | 34 | 35 | 35 | 36 | 37.5 | 37.5 | 37.5 | 36 | 36 | 34 | 34 | 35 | 35 | 36 | 37.5 | 37.5 | 37.5 | 36 | 36 | 34 | 34 | 35 | 35 | 36 | 37.5 | 37.5 | 37.5 | 36 | 36 | 34 | 34 | 35 | 35 | 36 | 37.5 | 37.5 | 37.5 | ns
tRFC (MIN) | Minimum refresh-to-refresh cycle time |  | 110 | 110 | 110 | 110 | 110 | 110 | 110 | 110 | 110 | 110 | 160 | 160 | 160 | 160 | 160 | 160 | 160 | 160 | 160 | 160 | 260 | 260 | 260 | 260 | 260 | 260 | 260 | 260 | 260 | 260 | 350 | 350 | 350 | 350 | 350 | 350 | 350 | 350 | 350 | 350 | 350 | 350 | 350 | 350 | 350 | 350 | 350 | 350 | 350 | 350 | ns
tREFI | Average periodic refresh cycle time |  | 7.8 | 7.8 | 7.8 | 7.8 | 7.8 | 7.8 | 7.8 | 7.8 | 7.8 | 7.8 | 7.8 | 7.8 | 7.8 | 7.8 | 7.8 | 7.8 | 7.8 | 7.8 | 7.8 | 7.8 | 7.8 | 7.8 | 7.8 | 7.8 | 7.8 | 7.8 | 7.8 | 7.8 | 7.8 | 7.8 | 7.8 | 7.8 | 7.8 | 7.8 | 7.8 | 7.8 | 7.8 | 7.8 | 7.8 | 7.8 | 7.8 | 7.8 | 7.8 | 7.8 | 7.8 | 7.8 | 7.8 | 7.8 | 7.8 | 7.8 | µs
tCK (MIN) | Minimum tCK cycle rate |  | 0.938 | 0.938 | 1.07 | 1.07 | 1.25 | 1.25 | 1.5 | 1.875 | 1.875 | 2.5 | 0.938 | 0.938 | 1.07 | 1.07 | 1.25 | 1.25 | 1.5 | 1.875 | 1.875 | 2.5 | 0.938 | 0.938 | 1.07 | 1.07 | 1.25 | 1.25 | 1.5 | 1.875 | 1.875 | 2.5 | 0.938 | 0.938 | 1.07 | 1.07 | 1.25 | 1.25 | 1.5 | 1.875 | 1.875 | 2.5 | 0.938 | 0.938 | 1.07 | 1.07 | 1.25 | 1.25 | 1.5 | 1.875 | 1.875 | 2.5 | ns
tCK (MAX) | Maximum tCK cycle rate |  | 3.3 | 3.3 | 3.3 | 3.3 | 3.3 | 3.3 | 3.3 | 3.3 | 3.3 | 3.3 | 3.3 | 3.3 | 3.3 | 3.3 | 3.3 | 3.3 | 3.3 | 3.3 | 3.3 | 3.3 | 3.3 | 3.3 | 3.3 | 3.3 | 3.3 | 3.3 | 3.3 | 3.3 | 3.3 | 3.3 | 3.3 | 3.3 | 3.3 | 3.3 | 3.3 | 3.3 | 3.3 | 3.3 | 3.3 | 3.3 | 3.3 | 3.3 | 3.3 | 3.3 | 3.3 | 3.3 | 3.3 | 3.3 | 3.3 | 3.3 | ns
Do Not Go Below This Box Do Not Go Below This Box Do Not Go Below This Box Do Not Go Below This Box Do Not Go Below This Box Do Not Go Below This Box Do Not Go Below This Box Do Not Go Below This Box

Sheet: DDR3 Config
DDR3 SDRAM Configuration
 | DRAM Density | 2Gb
 | Number of DQs per DRAM | 16
 | Speed Grade | -125
 | DDR3 or DDR3L
 | Mode Register bit 12: Precharge PD Exit Mode
Parameter | Condition | Value | Units
 | Maximum VCC | 1.575 | V
 | Minimum VCC | 1.425 | V
 | Number of DQ strobes (DQS) per DRAM | 4
 | Number of data mask (DM) per DRAM | 2
IDD0 | Maximum active precharge current | 49 | mA
IDD2P | Maximum precharge power-down standby current | 15 | mA
IDD2N | Maximum precharge standby current | 23 | mA
IDD3P | Maximum active power-down standby current | 22 | mA
IDD3N | Maximum active standby current | 37 | mA
IDD4R | Maximum read burst current | 135 | mA
IDD4W | Maximum write burst current | 146 | mA
IDD5A | Maximum burst refresh current | 182 | mA
 | tCK used for current measurements (see current notes) | 1.25 | ns
tRRD | Minimum activate-to-activate timing (different bank) | 7.5 | ns
tRC | Minimum activate-to-activate timing (same bank) | 48.75 | ns
tRAS | tRAS used for IDD0 calculation | 35 | ns
tRFC (MIN) | Minimum refresh-to-refresh cycle time | 160 | ns
tREFI | Average periodic refresh cycle time | 7.8 | µs
tCK (MIN) | Minimum tCK cycle rate | 1.25 | ns
tCK (MAX) | Maximum tCK cycle rate | 3.3 | ns

Sheet: System Config
 |  |  |  |  | READ I/O Power |  |  |  |  |  |  | WRITE I/O Power
 | DRAM Usage Conditions in the System Environment
 | System VDD | 1.5 | V
 | System CK frequency | 400 | MHz
 | Burst length | 8 |  | must be either 4 or 8
PdqRD | DDR3 SDRAM output power per individual DQ on this DRAM during READs from this DRAM | 5.5 | mW | This value is the DRAM I/O power plus module series resistor power per DQ. The calculator to the right will estimate and populate the entries to the left
PdqWR | DDR3 SDRAM termination power per individual DQ during WRITEs to this DRAM | 20.6 | mW |  |  | Enter values in dark green boxes below |  |  |  |  |  |  | Enter values in dark green boxes below
PdqRDoth | DDR3 SDRAM termination power per individual DQ during READs from other DRAM | 29.7 | mW | This value is the termination power plus module series resistor power per DQ. The calculator to the right will estimate and populate the entries to the left |  | RTTuC= | 120 | Rz1= | 34 | RTTu2= | 40 |  | RzC= | 34 | RTTu1= | 60 | RTTu2= | 40
PdqWRoth | DDR3 SDRAM termination power per individual DQ during WRITEs to other DRAM | 29.9 | mW |  |  | RTTdC= | 120 | Rs1= | 15 | RTTd2= | 40 |  |  |  | RTTd1= | 60 | RTTd2= | 40
 |  |  |  |  |  | VDDq= | 1.500 |  |  | Rs2= | 15 |  | VDDq= | 1.500 | Rs1= | 4 | Rs2= | 15
BNK_PRE% | The percentage of time that all banks on the DRAM are in a precharged state | 25% |  |  |  | Calculated values in light green boxes below |  |  |  |  |  |  | Calculated values in light green boxes below
CKE_LO_PRE% | The percentage of the all bank precharge time for which CKE is held LOW | 25% |  |  |  | N3= (mV) | 516.8393782 | N1= (mV) | 358.623242 | N2= (mV) | 615.0555144 |  | N3= (mV) | 497.5961538 | N1= (mV) | 527.290724 | N2= (mV) | 605.7692308
CKE_LO_ACT% | The percentage of the at least one bank active time for which CKE is held LOW | 25% |  |  |  | RTTC = (mW) | 10.3 | Rz = (mW) | 3.8 | RTTd2 = (mW) | 29.0 |  | Rz = (mW) | 7.3 | RTTd1 = (mW) | 20.4 | RTTd2 = (mW) | 29.2
 |  |  |  |  |  |  |  | Rs1 = (mW) | 1.7 | Rs2= (mW) | 0.64 |  |  |  | Rs1= (mW) | 0.22 | Rs2= (mW) | 0.8
PH% | Page hit rate | 25%
RDsch% | The percentage of clock cycles which are outputting read data from the DRAM | 30%
WRsch% | The percentage of clock cycles which are inputting write data to the DRAM | 30%
 |  | 50% |  | ratio of reads to writes
termRDsch% | The percentage of clock cycles which are terminating read data to another DRAM | 0% |  | must be 0% for a 1-rank system
termWRsch% | The percentage of clock cycles which are terminating write data to another DRAM | 0% |  | must be 0% for a 1-rank system
tRRDsch | The average time between ACT commands to this DRAM (includes ACT to same or different banks in the same DRAM device) | 22.2 | ns
 |  |  |  | The above is calculated from page hit rate read/write bus utilization. No entry is necessary.
 | Values that may be updated are shown in green. This will be dependent on how the system accesses the DRAM.
 | Calculated values in light green.

Sheet: Power Calcs
System Derating for 2Gb DDR3 SDRAM (x16, -125 Speed Grade)
Power is calculated based upon data sheet test conditions and maximum limits, scaled for used conditions an actual VDD. and finally scaled for the frequency being used. All parameters are calculated and require no user input.
 | Power Based on Data Sheet Test Conditions and Maximum Limits |  |  | Power Derated for System Usage Conditions Input into This Model |  |  | Power Scaled for Actual System Conditions (DRAM Usage, CK Frequency, and VCC)
Background power used during precharge power-down | Pds(PRE_PDN) | 23.6 | mW | Psch(PRE_PDN) | 1.5 | mW | Psys(PRE_PDN) | 0.7 | mW
Background power used during idle standby | Pds(PRE_STBY) | 36.2 | mW | Psch(PRE_STBY) | 6.8 | mW | Psys(PRE_STBY) | 3.1 | mW
Background power used during active power-down | Pds(ACT_PDN) | 34.6 | mW | Psch(ACT_PDN) | 6.5 | mW | Psys(ACT_PDN) | 2.9 | mW
Background power used during active standby | Pds(ACT_STBY) | 58.3 | mW | Psch(ACT_STBY) | 32.8 | mW | Psys(ACT_STBY) | 14.9 | mW
Background power to complete refreshes | Pds(REF) | 4.7 | mW | Psch(REF) | 4.7 | mW | Psys(REF) | 4.2 | mW
DRAM power for ACT/PRE commands | Pds(ACT) | 25.1 | mW | Psch(ACT) | 55.2 | mW | Psys(ACT) | 50.0 | mW
DRAM write power | Pds(WR) | 171.7 | mW | Psch(WR) | 51.5 | mW | Psys(WR) | 23.4 | mW
DRAM read power | Pds(RD) | 154.3 | mW | Psch(RD) | 46.3 | mW | Psys(RD) | 21.0 | mW
DQ output power | Pds(DQ) | 109.0 | mW | Psch(DQ) | 32.7 | mW | Psys(DQ) | 32.7 | mW
Term power for writes | Pds(termW) | 453.7 | mW | Psch(termW) | 136.1 | mW | Psys(termW) | 136.1 | mW
Term power for reads from another rank | Pds(termRoth) | 593.6 | mW | Psch(termRoth) | 0.0 | mW | Psys(termRoth) | 0.0 | mW
Term power for writes from another rank | Pds(termWoth) | 658.8 | mW | Psch(termWoth) | 0.0 | mW | Psys(termWoth) | 0.0 | mW
 |  |  |  |  |  |  | Total DRAM Power Consumed | 289.0 | mW
 |  |  |  |  |  |  | 2nd rank DRAM Power Consumed | 0.0 | mW

Sheet: Summary
2Gb DDR3 SDRAM with 16 DQs and a -125 Speed Grade
 |  | System is operating at 400 MHz clock with VDD = 1,5V. Read bandwidth is 480 MT/s with write bandwidth of 480 MT/s. The DRAM terminates 0 MT/s. ACT commands are separated by 22,2ns on average. All parameters are calculated and require no user input.
 | Psys Power Consumption Summary
 | ACT |  | 50.0 | mW | ACT | 50.0
 |  | Total Activate Power | 50.0 | mW | RD | 21.0
 | RD |  | 21.0 | mW | WR | 23.4
 | WR |  | 23.4 | mW | READ I/O | 32.7
 | READ I/O |  | 32.7 | mW | Write ODT | 136.1
 | Write ODT |  | 136.1 | mW | ACT_STBY | 14.9
 |  | Total RD/WR/Term Power | 213.2 | mW | PRE_STBY | 3.1
 | ACT_STBY |  | 14.9 | mW | ACT_PDN | 2.9
 | PRE_STBY |  | 3.1 | mW | PRE_PDN | 0.7
 | ACT_PDN |  | 2.9 | mW | REF | 4.2
 | PRE_PDN |  | 0.7 | mW | TERM 2nd rank | 0.0
 | REF |  | 4.2 | mW
 |  | Total Background Power | 25.8 | mW
 | Total DDR3 SDRAM Power |  | 289.0 | mW
 | TERM 2nd rank |  | 0.0 | mW
System is operating at 400 MHz clock with VDD = 1,5V.
