Raesangur/UdeS_S7_APP1/datasheets/fpga/Spartan3A_Spartan6_XPE_14_3.xlsx

Sheet: Summary
 |  |  | Xilinx Power Estimator (XPE) - 14,3 |  |  |  |  |  |  |  |  |  |  |  |  |  | 1.000 | 0.004489046965 | 125 | 0 | CLKROWS | CLKCOLS | LUT | FF | BRAM | DCM | PLL | DSP | GT | PCIE | PPC | EMAC | MCB | Pins | Banks | ThetaJA | ThetaJB | ThetaJC | JA250 | JA500 | JA750
 |  |  | Extended Spartan®-3A, Spartan®-6 |  |  |  |  |  |  |  |  |  | Release: d-oct-yyyy |  |  |  | 1 | 0.036 | 1.000 | -0.008 | 24 | 28 | 63288 | 126576 | 268 | 12 | 6 | 180 | 0 | 0 | 0 | 0 | 4 | 480 | 4 | 15.0 | 6.6 | 4 | 11 | 9.6 | 9.1
 |  |  |  |  |  |  |  |  |  |  |  |  |  |  |  |  | 1 | 0.009511583852 | 1.108 | 0.000
 |  |  |  |  |  |  |  |  |  |  |  |  |  |  |  |  | 1 |  | 0.036 | 8
Project |  |  |  |  |  |  |  |  |  |  |  |  |  |  | 0.05467891444 | 0.007990375208 | 0.08987016712 |  | 97.106 | 0.0266
Settings |  |  |  |  | On-Chip Power |  |  |  |  |  | Power Supply |  |  |  |  |  | 1 | 0.4554935698 |  | 0.00168
Device |  |  |  |  | Resource |  |  | Power |  |  | Source |  | Voltage | Total |  |  |  | 0.005
Family | Spartan-6 |  |  |  |  |  | (Jump to sheet) | (W) | (%) |  |  |  | (V) | (A) |  |  |  | 0.009
Device | XC6SLX100 | 19 |  | 19 | Core Dynamic |  |  | 0.014 | 4.162391474 | 1.2 | VCCINT |  | 1.200 | 0.243 | 0.202 | 0.040 |  | 10 | 0.04 |  | Packages | Banks
Package | FGG676 | 53 |  | 53 |  |  |  | 0.000 | 0 | 2.5 | VCCAUX |  | 2.500 | 0.015 | 0.006 | 0.010 | 12.5 | 25 | 0.07 |  | CSG484
Speed Grade | -3 |  |  |  |  |  |  | 0.000 | 0 |  | VCCO 3.3 |  | 3.300 | 0.000 | 0.000 | 0.000 | 200 | 40 | 0.10 |  | FGG484 | 0
Temp Grade | Commercial |  |  |  |  |  |  | 0.000 | 0 |  | VCCO 2.5 |  | 2.500 | 0.000 | 0.000 | 0.000 |  | 55 | 0.15 |  | FGG676 | 1
Process | Typical |  |  |  |  |  |  | 0.017 | 5.042427789 |  | VCCO 1.8 |  | 1.800 | 0.000 | 0.000 | 0.000 |  | 70 | 0.23 |  |  | 2
Power Mode | Active |  |  |  |  |  |  | 0.000 | 0 |  | VCCO 1.5 |  | 1.500 | 0.000 | 0.000 | 0.000 |  | 85 | 0.36 |  |  | 3
Characterization | Production 29-Aug-2011 |  |  |  |  |  |  |  | 0 |  | VCCO 1.2 |  | 1.200 | 0.000 | 0.000 | 0.000 |  | 100 | 0.56 |  |  | 5
 |  |  |  |  |  |  |  | 0.227 | 68.83280403 |  | - |  | 1.200 |  | - | - |  |  |  |  |  | 6
Environment |  |  |  |  | I/O |  |  | 0.000 | 0 |  | - |  | 1.200 |  | - | - |  | 1.14 | 0.06 |  |  | 7
Junction Temperature |  |  | 28.6 °C |  | Transceiver |  |  | 0.000 | 0 |  | - |  | 1.200 |  | - | - |  | 1.17 | 0.06 |  |  | 8
Ambient Temp | 25.0 °C |  |  |  | Device Static | - |  | 0.072 | 21.96237671 |  | - |  | 1.200 |  | - | - |  | 1.2 | 0.07 |  |  | 9
Effective ΘJA |  |  | 11.0 °C/W |  |  |  |  |  |  |  |  |  |  |  |  |  |  | 1.23 | 0.07 |  |  | 10
Airflow | 250 LFM |  |  |  | Summary |  |  |  |  |  |  |  |  |  |  |  |  | 1.26 | 0.08 |  |  | 11
Heat Sink | None |  |  |  | Junction Temperature |  |  | 28.6 °C |  |  | 0% | Transceiver…… |  | 0.000W |  |  |  |  |  |  |  | 12
ΘSA | 8.0 °C/W |  |  |  | Total On-Chip Power |  |  | 0.329 W |  |  | 0% | I/O……………… |  | 0.000W |  |  |  |  |  |  |  | 13
 |  |  |  |  |  |  |  |  |  |  | 78.03762329% | Core Dynamic.. |  | 0.257W |  |  |  |  |  |  |  | 14
ISE |  |  |  |  | Thermal Margin |  |  | 56.4°C | 4.8W |  | 21.96237671% | Device Static….. |  | 0.072W |  |  |  |  | 25 | 85 | 100 | 15
Optimization | Balanced |  |  | 1 | Effective ΘJA |  |  | 11.0 °C/W |  | Power supplied to off-chip devices… |  |  |  | 0.000W |  |  |  | Typical (1.2V) | 0.06569583206 | 0.3586533737 | 0.5626236975 | 16
 |  |  |  |  |  |  |  |  |  |  |  |  |  |  |  |  |  | Maximum (1.26V) | 0.15 | 0.96 | 1.355645164 | 17
 |  |  |  |  |  |  |  |  |  |  |  |  |  |  |  |  |  | 1
Messages |  |  |  |  |  |  |  |  |  |  |  |  |  |  |  |  |  | Leakage | 0.072
 | Warning: Maximum startup current 0A exceeds total estimated Iccint. See: |  |  |  |  |  |  |  |  | AR #34465 (http://www.xilinx.com/support/answers/34465.htm) |  |  |  |  |  |  |  | CLOCK | 0.01371483262
 |  |  |  |  |  |  |  |  |  |  |  |  |  |  |  |  |  | LOGIC | 0
 |  |  |  |  |  |  |  |  |  |  |  |  |  |  |  |  |  | IO | 0
Comments |  |  |  |  |  |  |  |  |  |  |  |  |  |  |  |  |  | BRAM | 0
 |  |  |  |  |  |  |  |  |  |  |  |  |  |  |  |  |  | DCM | 0.0166145
 |  |  |  |  |  |  |  |  |  |  |  |  |  |  |  |  |  | DSP | 0
XILINX Power Advantage (check for updates) (http://www.xilinx.com/products/technology/power/index.htm) |  |  |  | File Support Request (WebCase) (http://www.xilinx.com/support/clearexpress/websupport.htm) |  |  |  |  |  |  | Xilinx Power Estimator User Guide (http://www.xilinx.com/cgi-bin/docs/rdoc?l=en;v=latest;d=ug440-xilinx-power-estimator.pdf) |  |  |  |  |  |  | PLL | 0
Copyright © 1994-2012 Xilinx, Inc. All Rights Reserved |  |  |  |  |  |  |  | Whitepaper - 7 Steps for Worst Case Power Estimation (http://www.xilinx.com/support/documentation/white_papers/wp353.pdf) |  |  |  |  |  |  |  |  |  |  | 0
 |  |  |  |  |  |  |  |  |  |  |  |  |  |  |  |  |  |  | 0
Legend |  |  |  |  |  |  |  |  |  |  |  |  |  |  |  |  |  | MCB | 0.2268
 |  |  |  |  |  |  |  |  |  |  |  |  |  |  |  |  |  | Airflow | 2
 |  |  |  |  |  |  | Vccaux scale factor | Vccintq scale factor | iccint no leak | 0 | iccaux no leak | 0 |  |  |  |  |  | Heatsink | 4
 |  |  |  |  |  |  | 0.9999541796 | 1.000000001 | iccintq temp | iccintq | iccauxq temp | iccauxq | Non-intaux leakage | 0 |  |  |  | Pkg size | 729
 |  |  |  |  |  |  |  |  | 28.55111132 | 0.004392874559 | 28.60909726 | 0.009509356247 |  |  |  |  |  | Air | 228.6236854
 |  |  |  |  |  |  |  |  | 28.62310392 | 0.004487299511 | 28.62435033 | 0.009511571603 |  |  |  |  |  | ThetaJA | 11
 |  |  |  |  |  |  |  |  | 28.62441125 | 0.004489016233 | 28.62443391 | 0.009511583744 |  |  |  |  |  | ThetaJX | 11.54597053
 |  |  |  |  |  |  |  |  | 28.62443424 | 0.004489046429 | 28.62443464 | 0.00951158385 |  |  |  |  |  | ThetaSA | 0
 |  |  |  |  |  |  |  |  | 28.62443464 | 0.004489046956 | 28.62443465 | 0.009511583852 |  |  |  |  |  | ThetaCS | 0.1
 |  |  |  |  |  |  |  |  | 28.62443465 | 0.004489046965 | 28.62443465 | 0.009511583852 |  |  |  |  |  | ETJA | 11
 |  |  |  |  |  |  |  |  | 28.62443465 | 0.004489046965 | 28.62443465 | 0.009511583852
 |  |  |  |  |  |  |  |  | 28.62443465 | 0.004489046965 | 28.62443465 | 0.009511583852
 |  |  |  |  |  |  |  |  | 28.62443465 | 0.004489046965 | 28.62443465 | 0.009511583852 |  |  |  |  |  | Power Up | 0 | good
 |  |  |  |  |  |  |  |  | 28.62443465 | 0.004489046965 | 28.62443465 | 0.009511583852 | QFactInt | 1
 |  |  |  |  |  |  |  |  | 28.62443465 | 0.004489046965 | 28.62443465 | 0.009511583852 | QFactAux | 1
 |  |  |  |  |  |  |  |  | 28.62443465 | 0.004489046965 | 28.62443465 | 0.009511583852
 |  |  |  |  |  |  |  |  | 28.62443465 | 0.004489046965 | 28.62443465 | 0.009511583852 | Max Int | 0.302409298
 |  |  |  |  |  |  |  |  | 28.62443465 | 0.004489046965 | 28.62443465 | 0.009511583852 | Max Aux | 0.05624407562
 |  |  |  |  |  |  |  |  | 28.62443465 | 0.004489046965 | 28.62443465 | 0.009511583852 | Max Ambient | 78.22639023
 |  |  |  |  |  |  |  |  | 28.62443465 | 0.004489046965 | 28.62443465 | 0.009511583852
 |  |  |  |  |  |  |  |  | 28.62443465 | 0.004489046965 | 28.62443465 | 0.009511583852
 |  |  |  |  |  |  |  |  | 28.62443465 | 0.004489046965 | 28.62443465 | 0.009511583852

Sheet: CLOCK
Clock Tree Power |  |  |  |  |  |  |  |  | 1344 | 21504 |  |  |  |  |  |  | Data Row Offset
 |  |  |  |  |  |  |  |  | Global
Power |  |  |  | Utilization |  |  |  |  | Other
VCCINT | 1.200V | 0.014W |  | Global | 1 | 6.25% |  |  | I/O
4% of total on-chip power .W |  |  |  | Other | 0 | - |  |  | PLL
 |  | Active |  |  |  |  |  |  | L2:L4
Name |  |  | Frequency (MHz) | Type | Fanout | Clock Buffer Enable | Slice Clock Enable | Power (W) | BUFG | HROW | LEAF | Local | HROWs Used | Leafs Used | Iccq | Local fanout | 2
Clock interne |  |  | 200.0 | Global | 100 | 100% | 50% | 0.014 | 1.8876 | 4.755517498 | 4.3370208 | 0.4488888889 | 7.712984134 | 67.2 | 0.0004844498667 | 22.22222222
 |  |  | 0.0 | Global | 0 | 100% | 50% | 0.000 | 0.37 | 0 | 0 | 0 | 0 | 0 | 0 | 0
 |  |  | 0.0 | Global | 0 | 100% | 50% | 0.000 | 0.37 | 0 | 0 | 0 | 0 | 0 | 0 | 0
 |  |  | 0.0 | Global | 0 | 100% | 50% | 0.000 | 0.37 | 0 | 0 | 0 | 0 | 0 | 0 | 0
 |  |  | 0.0 | Global | 0 | 100% | 50% | 0.000 | 0.37 | 0 | 0 | 0 | 0 | 0 | 0 | 0
 |  |  | 0.0 | Global | 0 | 100% | 50% | 0.000 | 0.37 | 0 | 0 | 0 | 0 | 0 | 0 | 0
 |  |  | 0.0 | Global | 0 | 100% | 50% | 0.000 | 0.37 | 0 | 0 | 0 | 0 | 0 | 0 | 0
 |  |  | 0.0 | Global | 0 | 100% | 50% | 0.000 | 0.37 | 0 | 0 | 0 | 0 | 0 | 0 | 0
 |  |  | 0.0 | Global | 0 | 100% | 50% | 0.000 | 0.37 | 0 | 0 | 0 | 0 | 0 | 0 | 0
 |  |  | 0.0 | Global | 0 | 100% | 50% | 0.000 | 0.37 | 0 | 0 | 0 | 0 | 0 | 0 | 0
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
 |  |  | 0.0 | Global | 0 | 100% | 50% | 0.000 | 0.37 | 0 | 0 | 0 | 0 | 0 | 0 | 0
 |  |  | 0.0 | Global | 0 | 100% | 50% | 0.000 | 0.37 | 0 | 0 | 0 | 0 | 0 | 0 | 0
 |  |  | 0.0 | Global | 0 | 100% | 50% | 0.000 | 0.37 | 0 | 0 | 0 | 0 | 0 | 0 | 0
Global Utilization |  |  |  | 1

Sheet: LOGIC
Logic Power
Power |  |  |  | Utilization
VCCINT | 1.200V | 0.000W |  | FFs |  | 0 | 0%
0% of total on-chip power .W |  |  |  | LUTs |  | 0 | 0%
 |  | Active |  | Combinatorial |  | 0 | 0%
 |  |  |  | Shift Registers |  | 0 | 0%
 |  |  |  | Distributed RAMs |  | 0
Name |  |  | Clock (MHz) | LUTs as |  |  | FFs | Toggle Rate | Average Fanout | Write Rate | Signal Rate (Mtr/s) | Power (W)
 |  |  |  | LUTs | Shift Registers | Distributed RAMs |  |  |  |  |  |  | FANOUT Row Offset | Routing current (mA)
 |  |  | 0.0 | 0 | 0 | 0 | 0 | 12.5% | 3.00 | 50.0% | 0.0 | 0.000 | 8 | 0.000646
 |  |  | 0.0 | 0 | 0 | 0 | 0 | 12.5% | 3.00 | 50.0% | 0.0 | 0.000 | 8 | 0.000646
 |  |  | 0.0 | 0 | 0 | 0 | 0 | 12.5% | 3.00 | 50.0% | 0.0 | 0.000 | 8 | 0.000646
 |  |  | 0.0 | 0 | 0 | 0 | 0 | 12.5% | 3.00 | 50.0% | 0.0 | 0.000 | 8 | 0.000646
 |  |  | 0.0 | 0 | 0 | 0 | 0 | 12.5% | 3.00 | 50.0% | 0.0 | 0.000 | 8 | 0.000646
 |  |  | 0.0 | 0 | 0 | 0 | 0 | 12.5% | 3.00 | 50.0% | 0.0 | 0.000 | 8 | 0.000646
 |  |  | 0.0 | 0 | 0 | 0 | 0 | 12.5% | 3.00 | 50.0% | 0.0 | 0.000 | 8 | 0.000646
 |  |  | 0.0 | 0 | 0 | 0 | 0 | 12.5% | 3.00 | 50.0% | 0.0 | 0.000 | 8 | 0.000646
 |  |  | 0.0 | 0 | 0 | 0 | 0 | 12.5% | 3.00 | 50.0% | 0.0 | 0.000 | 8 | 0.000646
 |  |  | 0.0 | 0 | 0 | 0 | 0 | 12.5% | 3.00 | 50.0% | 0.0 | 0.000 | 8 | 0.000646
 |  |  | 0.0 | 0 | 0 | 0 | 0 | 12.5% | 3.00 | 50.0% | 0.0 | 0.000 | 8 | 0.000646
 |  |  | 0.0 | 0 | 0 | 0 | 0 | 12.5% | 3.00 | 50.0% | 0.0 | 0.000 | 8 | 0.000646
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
 |  |  | 0.0 | 0 | 0 | 0 | 0 | 12.5% | 3.00 | 50.0% | 0.0 | 0.000 | 8 | 0.000646
 |  |  | 0.0 | 0 | 0 | 0 | 0 | 12.5% | 3.00 | 50.0% | 0.0 | 0.000 | 8 | 0.000646
 |  |  | 0.0 | 0 | 0 | 0 | 0 | 12.5% | 3.00 | 50.0% | 0.0 | 0.000 | 8 | 0.000646

Sheet: IO
I/O Power |  |  |  |  |  |  |  |  |  |  |  |  |  |  |  |  |  |  |  |  |  |  |  |  |  |  |  |  |  |  | None | None | 3state
 |  |  |  |  |  |  |  |  |  |  |  |  |  |  |  |  |  |  |  |  |  |  |  |  |  |  |  |  |  |  | Untuned_Split_25 | Untuned_25 | Pullup
Supply Current |  |  |  |  |  | Summary |  |  |  |  |  |  |  |  |  |  |  |  |  |  |  |  |  |  |  |  |  |  |  |  | Untuned_Split_50 | Untuned_50 | Pulldown
Source |  | On-Chip | Off-Chip | Total |  | Power (on-chip) |  |  | 0.000W |  |  |  |  |  |  |  |  |  |  |  |  |  |  |  |  |  |  |  |  |  | Untuned_Split_75 | Untuned_75 | Keeper
VCCINT | 1.200V | 0.000A |  | 0.000A |  |  | Logic |  | 0.000W |  |  |  |  |  |  |  |  |  |  |  |  |  |  |  |  |  |  |  |  |  | None |  | Drivelast
VCCAUX | 2.500V | 0.000A |  | 0.000A |  |  | Buffer |  | 0.000W |  |  |  |  |  |  |  |  |  |  |  |  |  |  |  |  |  |  |  |  |  | Differential |  | OCT_ON
VCCO33 | 3.300V | 0.000A | 0.000A | 0.000A
VCCO25 | 2.500V | 0.000A | 0.000A | 0.000A |  | 0% of total on-chip power .W
VCCO18 | 1.800V | 0.000A | 0.000A | 0.000A |  | Power (off-chip) |  |  | 0.000W
VCCO15 | 1.500V | 0.000A | 0.000A | 0.000A |  | I/O Count |  |  | 0
VCCO12 | 1.200V | 0.000A | 0.000A | 0.000A |  | I/O Utilization |  |  | 0%
Name |  | I/O Settings |  |  |  |  |  |  |  |  |  |  | Activity |  |  |  | Output Load (pF) | Signal Rate (Mtr/s) | On Chip Power (W) |  |  | Off Chip |  |  |  |  |  |  |  |  |  |  |  |  |  |  |  |  |  |  |  |  |  |  |  |  | On-Chip Thermal Current (was Power) |  |  |  |  | Off-Chip was Dynamic Current
 |  | I/O Standard |  |  | Input Pins | Output Pins | Bidir Pins | IO LOGIC SERDES | IO DELAY | Input Termination | Output Termination | Suspend Mode | Clock (MHz) | Toggle Rate | Data Rate | Output Enable |  |  | VCCINT | VCCAUX | VCCO | VCCO (W) | Index | Fclk | Iccoq | Typ1 | Typ2 | Typ3 | Vtt | On-chip Vcco Active | On-chip Vcco Suspend | dci_bank_input_current | Static Output current | Static Input current | Output on-chip static power | Output Term current | Input term current | Output term on-chip static power | On-chip term power | SERDES | DEL_int | Iccaux | Iccauxq | Vcco | Type | Vcco33 | Vcco25 | Vcco18 | Vcco15 | Vcco12 | Vcco33 | Vcco25
 |  |  |  |  |  |  |  |  |  |  |  |  |  |  |  |  |  |  | 1,2V | 2,5V | all rails | all rails
 |  | LVCMOS 2.5V 12mA (Slow) |  |  | 0 | 0 | 0 | No | Off | None | None | 3state | 0.0 | 12.5% | SDR | 100.0% | 0 | 0.0 | 0.000 | 0.000 | 0.000 | 0.000 | 212 | 0 | 0 | 0 | 0 | 0 | 0 | 0 | 0 | 0 | 0 | 0 | 0 | 0 | 0 | 0 | 0 | 0 | 0 | 0 | 0 | 2.5 | 1 | 0 | 0 | 0 | 0 | 0 | 0 | 0
 |  | LVCMOS 2.5V 12mA (Slow) |  |  | 0 | 0 | 0 | No | Off | None | None | 3state | 0.0 | 12.5% | SDR | 100.0% | 0 | 0.0 | 0.000 | 0.000 | 0.000 | 0.000 | 212 | 0 | 0 | 0 | 0 | 0 | 0 | 0 | 0 | 0 | 0 | 0 | 0 | 0 | 0 | 0 | 0 | 0 | 0 | 0 | 0 | 2.5 | 1 | 0 | 0 | 0 | 0 | 0 | 0 | 0
 |  | LVCMOS 2.5V 12mA (Slow) |  |  | 0 | 0 | 0 | No | Off | None | None | 3state | 0.0 | 12.5% | SDR | 100.0% | 0 | 0.0 | 0.000 | 0.000 | 0.000 | 0.000 | 212 | 0 | 0 | 0 | 0 | 0 | 0 | 0 | 0 | 0 | 0 | 0 | 0 | 0 | 0 | 0 | 0 | 0 | 0 | 0 | 0 | 2.5 | 1 | 0 | 0 | 0 | 0 | 0 | 0 | 0
 |  | LVCMOS 2.5V 12mA (Slow) |  |  | 0 | 0 | 0 | No | Off | None | None | 3state | 0.0 | 12.5% | SDR | 100.0% | 0 | 0.0 | 0.000 | 0.000 | 0.000 | 0.000 | 212 | 0 | 0 | 0 | 0 | 0 | 0 | 0 | 0 | 0 | 0 | 0 | 0 | 0 | 0 | 0 | 0 | 0 | 0 | 0 | 0 | 2.5 | 1 | 0 | 0 | 0 | 0 | 0 | 0 | 0
 |  | LVCMOS 2.5V 12mA (Slow) |  |  | 0 | 0 | 0 | No | Off | None | None | 3state | 0.0 | 12.5% | SDR | 100.0% | 0 | 0.0 | 0.000 | 0.000 | 0.000 | 0.000 | 212 | 0 | 0 | 0 | 0 | 0 | 0 | 0 | 0 | 0 | 0 | 0 | 0 | 0 | 0 | 0 | 0 | 0 | 0 | 0 | 0 | 2.5 | 1 | 0 | 0 | 0 | 0 | 0 | 0 | 0
 |  | LVCMOS 2.5V 12mA (Slow) |  |  | 0 | 0 | 0 | No | Off | None | None | 3state | 0.0 | 12.5% | SDR | 100.0% | 0 | 0.0 | 0.000 | 0.000 | 0.000 | 0.000 | 212 | 0 | 0 | 0 | 0 | 0 | 0 | 0 | 0 | 0 | 0 | 0 | 0 | 0 | 0 | 0 | 0 | 0 | 0 | 0 | 0 | 2.5 | 1 | 0 | 0 | 0 | 0 | 0 | 0 | 0
 |  | LVCMOS 2.5V 12mA (Slow) |  |  | 0 | 0 | 0 | No | Off | None | None | 3state | 0.0 | 12.5% | SDR | 100.0% | 0 | 0.0 | 0.000 | 0.000 | 0.000 | 0.000 | 212 | 0 | 0 | 0 | 0 | 0 | 0 | 0 | 0 | 0 | 0 | 0 | 0 | 0 | 0 | 0 | 0 | 0 | 0 | 0 | 0 | 2.5 | 1 | 0 | 0 | 0 | 0 | 0 | 0 | 0
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
110 |  |  | Package Pins |  | 0 | 0 | 0 |  |  |  |  |  |  |  |  |  |  |  | 0.000 | 0.000 | 0.000
 |  |  |  |  |  |  |  |  |  |  |  |  |  |  |  |  |  |  |  |  |  |  |  | 0
 |  |  |  |  |  |  |  |  |  |  |  |  |  |  |  |  |  |  |  |  |  |  |  |  |  |  |  |  |  |  |  |  | Pins

Sheet: BRAM
Block RAM Power
Power |  |  |  |  | Utilization
VCCINT | 1.200V | 0.000W |  |  | RAMB9 |  | 0 | 0% | 0
0% of total on-chip power .W |  |  |  |  | RAMB18 |  | 0 | 0%
 |  | Active
 |  |  |  |  |  | Port A |  |  |  |  | Port B
Name |  |  | BRAMs | Mode | Toggle Rate | Clock (MHz) | Enable Rate | Bit Width | Write Mode | Write Rate | Clock (MHz) | Enable Rate | Bit Width | Write Mode | Write Rate | Signal Rate (Mtr/s) | Power (W) | Count | PortA Col | PortB Col | PortA | PortB | Routing | Toggle Factor
 |  |  | 0 | RAMB9 | 50.0% | 0.0 | 25.0% | 1 | WRITE_FIRST | 50.0% | 0.0 | 25.0% | 1 | WRITE_FIRST | 50.0% | 0.000 | 0.000 | 0 | 9 | 9 | 0 | 0 | 0 | 0.9525
 |  |  | 0 | RAMB9 | 50.0% | 0.0 | 25.0% | 1 | WRITE_FIRST | 50.0% | 0.0 | 25.0% | 1 | WRITE_FIRST | 50.0% | 0.000 | 0.000 | 0 | 9 | 9 | 0 | 0 | 0 | 0.9525
 |  |  | 0 | RAMB9 | 50.0% | 0.0 | 25.0% | 1 | WRITE_FIRST | 50.0% | 0.0 | 25.0% | 1 | WRITE_FIRST | 50.0% | 0.000 | 0.000 | 0 | 9 | 9 | 0 | 0 | 0 | 0.9525
 |  |  | 0 | RAMB9 | 50.0% | 0.0 | 25.0% | 1 | WRITE_FIRST | 50.0% | 0.0 | 25.0% | 1 | WRITE_FIRST | 50.0% | 0.000 | 0.000 | 0 | 9 | 9 | 0 | 0 | 0 | 0.9525
 |  |  | 0 | RAMB9 | 50.0% | 0.0 | 25.0% | 1 | WRITE_FIRST | 50.0% | 0.0 | 25.0% | 1 | WRITE_FIRST | 50.0% | 0.000 | 0.000 | 0 | 9 | 9 | 0 | 0 | 0 | 0.9525
 |  |  | 0 | RAMB9 | 50.0% | 0.0 | 25.0% | 1 | WRITE_FIRST | 50.0% | 0.0 | 25.0% | 1 | WRITE_FIRST | 50.0% | 0.000 | 0.000 | 0 | 9 | 9 | 0 | 0 | 0 | 0.9525
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
 |  |  |  |  |  |  |  |  |  |  |  |  |  |  | Modes
 |  |  |  |  |  |  |  |  |  |  |  |  |  |  | RAMB16
 |  |  |  |  |  |  |  |  |  |  |  |  |  |  | RAMB9
 |  |  |  |  |  |  |  |  |  |  |  |  |  |  | RAMB18

Sheet: DSP
DSP48A1 Power |  |  |  |  |  |  |  |  |  |  |  |  | 3 | Col Index
Power |  |  |  | Utilization
VCCINT | 1.200V | 0.000W |  | DSP48 | 0 | 0%
0% of total on-chip power .W
Name |  |  | DSP Slices | Clock (MHz) | Toggle Rate | MREG Used? | MULT Used? | Pre-Add Used? | Post-Add Used? | Signal Rate (Mtr/s) | Power (W) | S3A (mA) | S6 (mA)
 |  |  | 0 | 0.0 | 12.5% | Yes | Yes | No | Yes | 0.0 | 0.000 | 0 | 0
 |  |  | 0 | 0.0 | 12.5% | Yes | Yes | No | Yes | 0.0 | 0.000 | 0 | 0
 |  |  | 0 | 0.0 | 12.5% | Yes | Yes | No | Yes | 0.0 | 0.000 | 0 | 0
 |  |  | 0 | 0.0 | 12.5% | Yes | Yes | No | Yes | 0.0 | 0.000 | 0 | 0
 |  |  | 0 | 0.0 | 12.5% | Yes | Yes | No | Yes | 0.0 | 0.000 | 0 | 0
 |  |  | 0 | 0.0 | 12.5% | Yes | Yes | No | Yes | 0.0 | 0.000 | 0 | 0
 |  |  | 0 | 0.0 | 12.5% | Yes | Yes | No | Yes | 0.0 | 0.000 | 0 | 0
 |  |  | 0 | 0.0 | 12.5% | Yes | Yes | No | Yes | 0.0 | 0.000 | 0 | 0
 |  |  | 0 | 0.0 | 12.5% | Yes | Yes | No | Yes | 0.0 | 0.000 | 0 | 0
 |  |  | 0 | 0.0 | 12.5% | Yes | Yes | No | Yes | 0.0 | 0.000 | 0 | 0
 |  |  | 0 | 0.0 | 12.5% | Yes | Yes | No | Yes | 0.0 | 0.000 | 0 | 0
 |  |  | 0 | 0.0 | 12.5% | Yes | Yes | No | Yes | 0.0 | 0.000 | 0 | 0
 |  |  | 0 | 0.0 | 12.5% | Yes | Yes | No | Yes | 0.0 | 0.000 | 0 | 0
 |  |  | 0 | 0.0 | 12.5% | Yes | Yes | No | Yes | 0.0 | 0.000 | 0 | 0
 |  |  | 0 | 0.0 | 12.5% | Yes | Yes | No | Yes | 0.0 | 0.000 | 0 | 0
 |  |  | 0 | 0.0 | 12.5% | Yes | Yes | No | Yes | 0.0 | 0.000 | 0 | 0
 |  |  | 0 | 0.0 | 12.5% | Yes | Yes | No | Yes | 0.0 | 0.000 | 0 | 0
 |  |  | 0 | 0.0 | 12.5% | Yes | Yes | No | Yes | 0.0 | 0.000 | 0 | 0
 |  |  | 0 | 0.0 | 12.5% | Yes | Yes | No | Yes | 0.0 | 0.000 | 0 | 0
 |  |  | 0 | 0.0 | 12.5% | Yes | Yes | No | Yes | 0.0 | 0.000 | 0 | 0
 |  |  | 0 | 0.0 | 12.5% | Yes | Yes | No | Yes | 0.0 | 0.000 | 0 | 0
 |  |  | 0 | 0.0 | 12.5% | Yes | Yes | No | Yes | 0.0 | 0.000 | 0 | 0
 |  |  | 0 | 0.0 | 12.5% | Yes | Yes | No | Yes | 0.0 | 0.000 | 0 | 0
 |  |  | 0 | 0.0 | 12.5% | Yes | Yes | No | Yes | 0.0 | 0.000 | 0 | 0
 |  |  | 0 | 0.0 | 12.5% | Yes | Yes | No | Yes | 0.0 | 0.000 | 0 | 0
 |  |  | 0 | 0.0 | 12.5% | Yes | Yes | No | Yes | 0.0 | 0.000 | 0 | 0
 |  |  | 0 | 0.0 | 12.5% | Yes | Yes | No | Yes | 0.0 | 0.000 | 0 | 0
 |  |  | 0 | 0.0 | 12.5% | Yes | Yes | No | Yes | 0.0 | 0.000 | 0 | 0
 |  |  | 0 | 0.0 | 12.5% | Yes | Yes | No | Yes | 0.0 | 0.000 | 0 | 0
 |  |  | 0 | 0.0 | 12.5% | Yes | Yes | No | Yes | 0.0 | 0.000 | 0 | 0
 |  |  | 0 | 0.0 | 12.5% | Yes | Yes | No | Yes | 0.0 | 0.000 | 0 | 0
 |  |  | 0 | 0.0 | 12.5% | Yes | Yes | No | Yes | 0.0 | 0.000 | 0 | 0
 |  |  | 0 | 0.0 | 12.5% | Yes | Yes | No | Yes | 0.0 | 0.000 | 0 | 0
 |  |  | 0 | 0.0 | 12.5% | Yes | Yes | No | Yes | 0.0 | 0.000 | 0 | 0
 |  |  | 0 | 0.0 | 12.5% | Yes | Yes | No | Yes | 0.0 | 0.000 | 0 | 0
 |  |  | 0 | 0.0 | 12.5% | Yes | Yes | No | Yes | 0.0 | 0.000 | 0 | 0
 |  |  | 0 | 0.0 | 12.5% | Yes | Yes | No | Yes | 0.0 | 0.000 | 0 | 0
 |  |  | 0 | 0.0 | 12.5% | Yes | Yes | No | Yes | 0.0 | 0.000 | 0 | 0
 |  |  | 0 | 0.0 | 12.5% | Yes | Yes | No | Yes | 0.0 | 0.000 | 0 | 0
 |  |  | 0 | 0.0 | 12.5% | Yes | Yes | No | Yes | 0.0 | 0.000 | 0 | 0
 |  |  | 0 | 0.0 | 12.5% | Yes | Yes | No | Yes | 0.0 | 0.000 | 0 | 0
 |  |  | 0 | 0.0 | 12.5% | Yes | Yes | No | Yes | 0.0 | 0.000 | 0 | 0
 |  |  | 0 | 0.0 | 12.5% | Yes | Yes | No | Yes | 0.0 | 0.000 | 0 | 0

Sheet: DCM
DCM Power
Power
VCCINT | 1.200V | 0.002W |  |  | 1 | 8.333333333%
VCCAUX | 2.500V | 0.015W
Total |  | 0.017W | Active
5% of total on-chip power .W
Name |  |  | Clock (MHz) | Mode | VCCINT (W) | VCCAUX (W) | VCCAUXQ (W) | Row Offset | Iccintq | freq mode
dcm1 |  |  | 200.0 | DLL | 0.002 | 0.015 | 0.011 | 8 | 0 | High
 |  |  | 0.0 | DLL | 0.000 | 0.000 | 0.000 | 8 | 0 | Low
 |  |  | 0.0 | DLL | 0.000 | 0.000 | 0.000 | 8 | 0 | Low
 |  |  | 0.0 | DLL | 0.000 | 0.000 | 0.000 | 8 | 0 | Low
 |  |  | 0.0 | DLL | 0.000 | 0.000 | 0.000 | 8 | 0 | Low
 |  |  | 0.0 | DLL | 0.000 | 0.000 | 0.000 | 8 | 0 | Low
 |  |  | 0.0 | DLL | 0.000 | 0.000 | 0.000 | 8 | 0 | Low
 |  |  | 0.0 | DLL | 0.000 | 0.000 | 0.000 | 8 | 0 | Low
 |  |  | 0.0 | DLL | 0.000 | 0.000 | 0.000 | 8 | 0 | Low
 |  |  | 0.0 | DLL | 0.000 | 0.000 | 0.000 | 8 | 0 | Low
 |  |  | 0.0 | DLL | 0.000 | 0.000 | 0.000 | 8 | 0 | Low
 |  |  | 0.0 | DLL | 0.000 | 0.000 | 0.000 | 8 | 0 | Low
 |  |  | 0.0 | DLL | 0.000 | 0.000 | 0.000 | 8 | 0 | Low
 |  |  | 0.0 | DLL | 0.000 | 0.000 | 0.000 | 8 | 0 | Low
 |  |  | 0.0 | DLL | 0.000 | 0.000 | 0.000 | 8 | 0 | Low
 |  |  | 0.0 | DLL | 0.000 | 0.000 | 0.000 | 8 | 0 | Low
 |  |  | 0.0 | DLL | 0.000 | 0.000 | 0.000 | 8 | 0 | Low
 |  |  | 0.0 | DLL | 0.000 | 0.000 | 0.000 | 8 | 0 | Low
 |  |  | 0.0 | DLL | 0.000 | 0.000 | 0.000 | 8 | 0 | Low
 |  |  | 0.0 | DLL | 0.000 | 0.000 | 0.000 | 8 | 0 | Low
 |  |  | 0.0 | DLL | 0.000 | 0.000 | 0.000 | 8 | 0 | Low
 |  |  | 0.0 | DLL | 0.000 | 0.000 | 0.000 | 8 | 0 | Low
 |  |  | 0.0 | DLL | 0.000 | 0.000 | 0.000 | 8 | 0 | Low
 |  |  | 0.0 | DLL | 0.000 | 0.000 | 0.000 | 8 | 0 | Low
 |  |  |  |  | 0.002 | 0.015 | 0.011
 |  |  |  | DLL
 |  |  |  | DFS
 |  |  |  | DCM_CLKGEN

Sheet: PLL
PLL Power
Power |  |  |  | Utilization
VCCINT | 1.200V | 0.000W |  | PLL | 0 | 0%
VCCAUX | 2.500V | 0.000W
Total |  | 0.000W | Active
0% of total on-chip power .W
Name |  |  | Clock (MHz) | Divide Counter | Multiply Counter | Clock 0 Divide | Clock 1 Divide | Clock 2 Divide | Clock 3 Divide | Clock 4 Divide | Clock 5 Divide | VCCINT (W) | VCCAUX (W) | VCCAUXQ (W)
 |  |  |  | 1 | 1 | off | off | off | off | off | off | 0.000 | 0.000 | 0.000 |  | 0 | 0 | 0 | 0 | 0 | 0 | 0 | 0
 |  |  |  | 1 | 1 | off | off | off | off | off | off | 0.000 | 0.000 | 0.000 |  | 0 | 0 | 0 | 0 | 0 | 0 | 0 | 0
 |  |  |  | 1 | 1 | off | off | off | off | off | off | 0.000 | 0.000 | 0.000 |  | 0 | 0 | 0 | 0 | 0 | 0 | 0 | 0
 |  |  |  | 1 | 1 | off | off | off | off | off | off | 0.000 | 0.000 | 0.000 |  | 0 | 0 | 0 | 0 | 0 | 0 | 0 | 0
 |  |  |  | 1 | 1 | off | off | off | off | off | off | 0.000 | 0.000 | 0.000 |  | 0 | 0 | 0 | 0 | 0 | 0 | 0 | 0
 |  |  |  | 1 | 1 | off | off | off | off | off | off | 0.000 | 0.000 | 0.000 |  | 0 | 0 | 0 | 0 | 0 | 0 | 0 | 0
 |  |  |  |  |  |  |  |  |  |  |  | 0.000 | 0.000 | 0.000
 |  |  |  |  |  |  |  |  |  |  |  |  |  |  | off
 |  |  |  |  |  |  |  |  |  |  |  |  |  |  | 1
 |  |  |  |  |  |  |  |  |  |  |  |  |  |  | 2
 |  |  |  |  |  |  |  |  |  |  |  |  |  |  | 3
 |  |  |  |  |  |  |  |  |  |  |  |  |  |  | 4
 |  |  |  |  |  |  |  |  |  |  |  |  |  |  | 5
 |  |  |  |  |  |  |  |  |  |  |  |  |  |  | 6
 |  |  |  |  |  |  |  |  |  |  |  |  |  |  | 7
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
 |  |  |  |  |  |  |  |  |  |  |  |  |  |  | 123
 |  |  |  |  |  |  |  |  |  |  |  |  |  |  | 124
 |  |  |  |  |  |  |  |  |  |  |  |  |  |  | 125
 |  |  |  |  |  |  |  |  |  |  |  |  |  |  | 126
 |  |  |  |  |  |  |  |  |  |  |  |  |  |  | 127
 |  |  |  |  |  |  |  |  |  |  |  |  |  |  | 128

Sheet: MCB
MCB Power
Power |  |  |  | Utilization
VCCINT | 1.200V | 0.227W | Active | MCB | 1 | 25%
69% of total on-chip power .W
Name |  |  | System Clock (MHz) | Power (W)
 |  |  | 400.0 | 0.227
 |  |  | 0.0 | 0.000
 |  |  | 0.0 | 0.000
 |  |  | 0.0 | 0.000

Sheet: User
This sheet is intentionally blank and provided for the user to perform any calculations or add documentation.

Sheet: Graphs
On-Chip Power over Vccint - (Typical, 28C)
On-Chip Power over Temperature - (Typical, 1,2V)
On-Chip Power by Function - (Typical, 1,2V, 28C)

Sheet: Release
Xilinx Power Estimator (XPE) - 14,3
Date | Version | Notes
2012-10-16 | 14.3 | Spartan-6: "Production" (Added CSG484 package to the LX45 and LX75 XA devices)
 |  | CRs
2012-05-08 | 14.1 | Spartan-6: "Production"
 |  | CRs
2011-10-26 | 13.3 | Spartan-6: "Production"
 |  | Added XA6SLX100, production numbers for Q-Grade
2011-07-06 | 13.2 | Spartan-6: "Production", "Preliminary" for Automotive
 |  | Support for XQ parts
2011-03-01 | 13.1 | Spartan-6: "Production", "Preliminary" for -1L, "Advance" for Q-Grade
 |  | CR fixes
2010-12-21 | 12.4 | Spartan-6: "Production", "Advance" for -1L and Q-Grade
 |  | CR fixes
2010-11-17 | 12.3.1 | Spartan-6: "Production", "Advance" for -1L and Q-Grade
 |  | Process improvements
2010-09-08 | 12.3 | Spartan-6: "Production", "Advance" for -1L and Q-Grade
 |  | Extended Spartan-3A: All devices "Production"
 |  | CR fixes
2010-07-21 | 12.2 | Spartan-6: "Production" for XC6SLX16, XC6SLX45/T, "Advance" for all other members
 |  | Extended Spartan-3A: All devices "Production"
 |  | Added Spartan-6 Automotive parts, CR fixes
2010-05-28 | 12.1.1 | Spartan-6: "Production" for XC6SLX16, XC6SLX45/T, "Advance" for all other members
 |  | Extended Spartan-3A: All devices "Production"
 |  | CR fixes
2010-04-27 | 12.1 | Spartan-6: "Production" for XC6SLX16, XC6SLX45/T, XC6SLX75/T, XC6SLX150/T, "Advance" for all other members
 |  | Extended Spartan-3A: All devices "Production"
 |  | New GUI
2010-03-09 | 11.5 | Spartan-6: "Production" for XC6SLX16 and XC6SLX45, "Advance" for all other members
 |  | Extended Spartan-3A: All devices "Production"
2009-11-30 | 11.4 | Production for Spartan-3A, Advance for Spartan-6
 |  | - GTP characterization data, heatsink support, new packages, improved models, CR fixes
2009-09-14 | 11.3 | Production for Spartan-3A, Advance for Spartan-6
 |  | - Characterization data, improved models, CR fixes
2009-06-18 | 11.2 | Production for Spartan-3A, Advance for Spartan-6
 |  | - Early characterization data for Spartan-6, improved models, Lower Power parts, CR fixes
 |  | - Updated layout of summary sheet
2009-04-03 | 11.1 Beta-2 | Production
 |  | - Early clock characterization data for Spartan-6
2008-12-11 | 11.1 Beta-1 | Production
 |  | - Refined I/O model
 |  | - Included "DSP" parts, added "XC6S" parts
2008-06-12 | 10.1 | Production
 |  | - Refined clock, fabric, BRAM and I/O models from expanded characterization design suite
 |  | - Final Iccq and Iccauxq characterization from production silicon
2008-02-07 | 9.2.04 | Preliminary
 |  | - Added clock sheet and updated with latest char data
2007-05-22 | 9.1.03 | Preliminary
 |  | - Updated with latest Iccq data
 |  | - Fixed issues with I/O calculation and the various power modes
2007-03-28 | 9.1.02 | Preliminary
 |  | - Updated characterization data
 |  | - "AN" parts added
2007-01-05 | 8.2 | Advance
 |  | - Early characterization data
 |  | - Static current characterization for normal, standby and suspend modes
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
