Raesangur/UdeS_S7_APP1/.STEP/legros.-Body.step

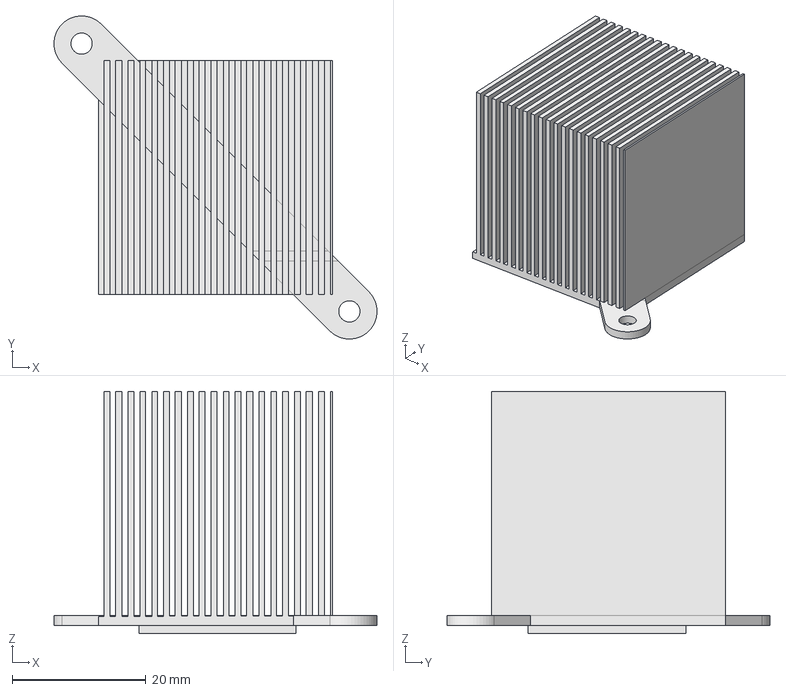
[picture p27: CAD file, 2024-03-12]
.STEP/legros.-Body.step
48.2 x 48.2 x 36.2 mm
