Raesangur/UdeS_S7_APP1/.STEP/leptit-Body.step

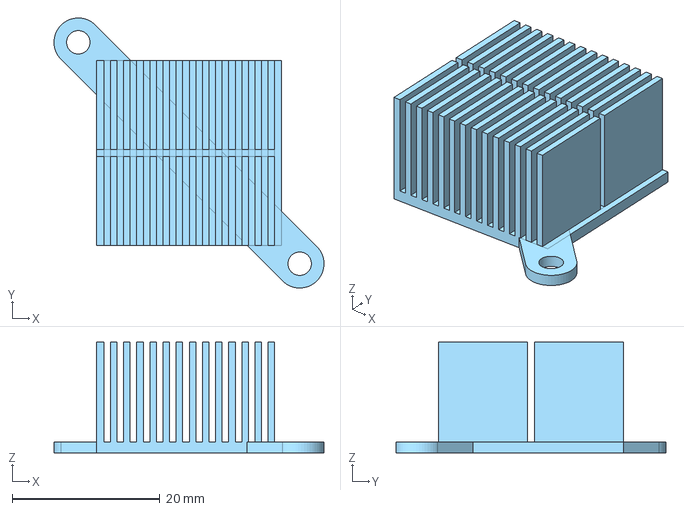
[picture p28: CAD file, 2024-01-29]
.STEP/leptit-Body.step
36.6 x 36.6 x 15.0 mm
