Raesangur/UdeS_S7_APP1/(list of files, cad)

Other CAD files:
.STEP/legros..FCStd
.STEP/leptit.FCStd
.STEP/legros.iges
.STEP/leptit-Body.iges
.STEP/leptit.iges
