Raesangur/UdeS_S7_APP1/Output/Assembly_Drawings.PDF

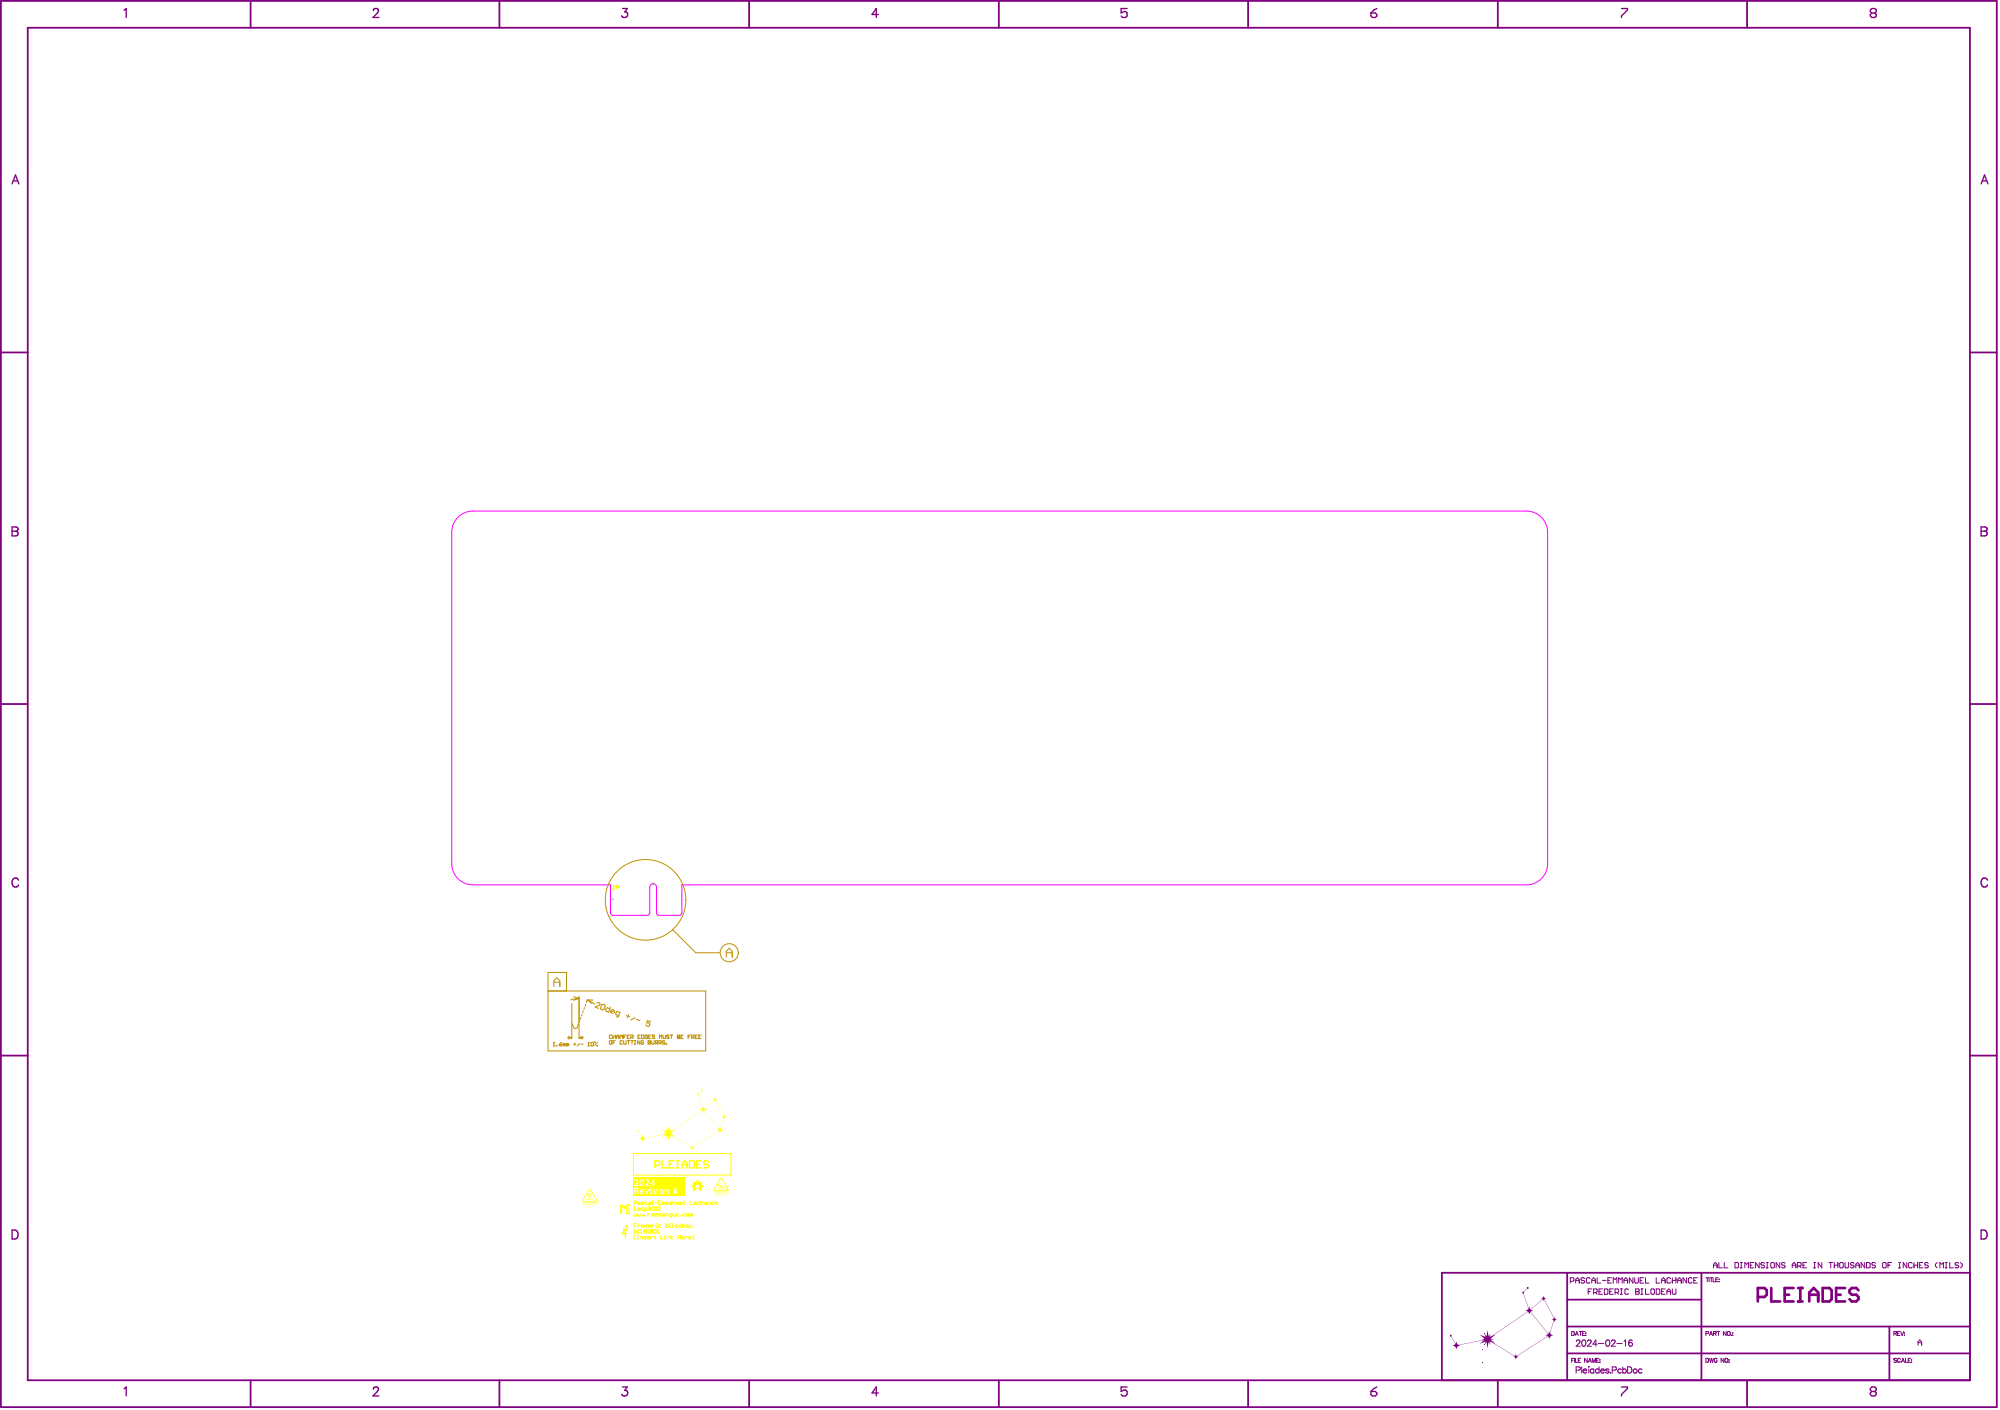
[picture p29: page 1]

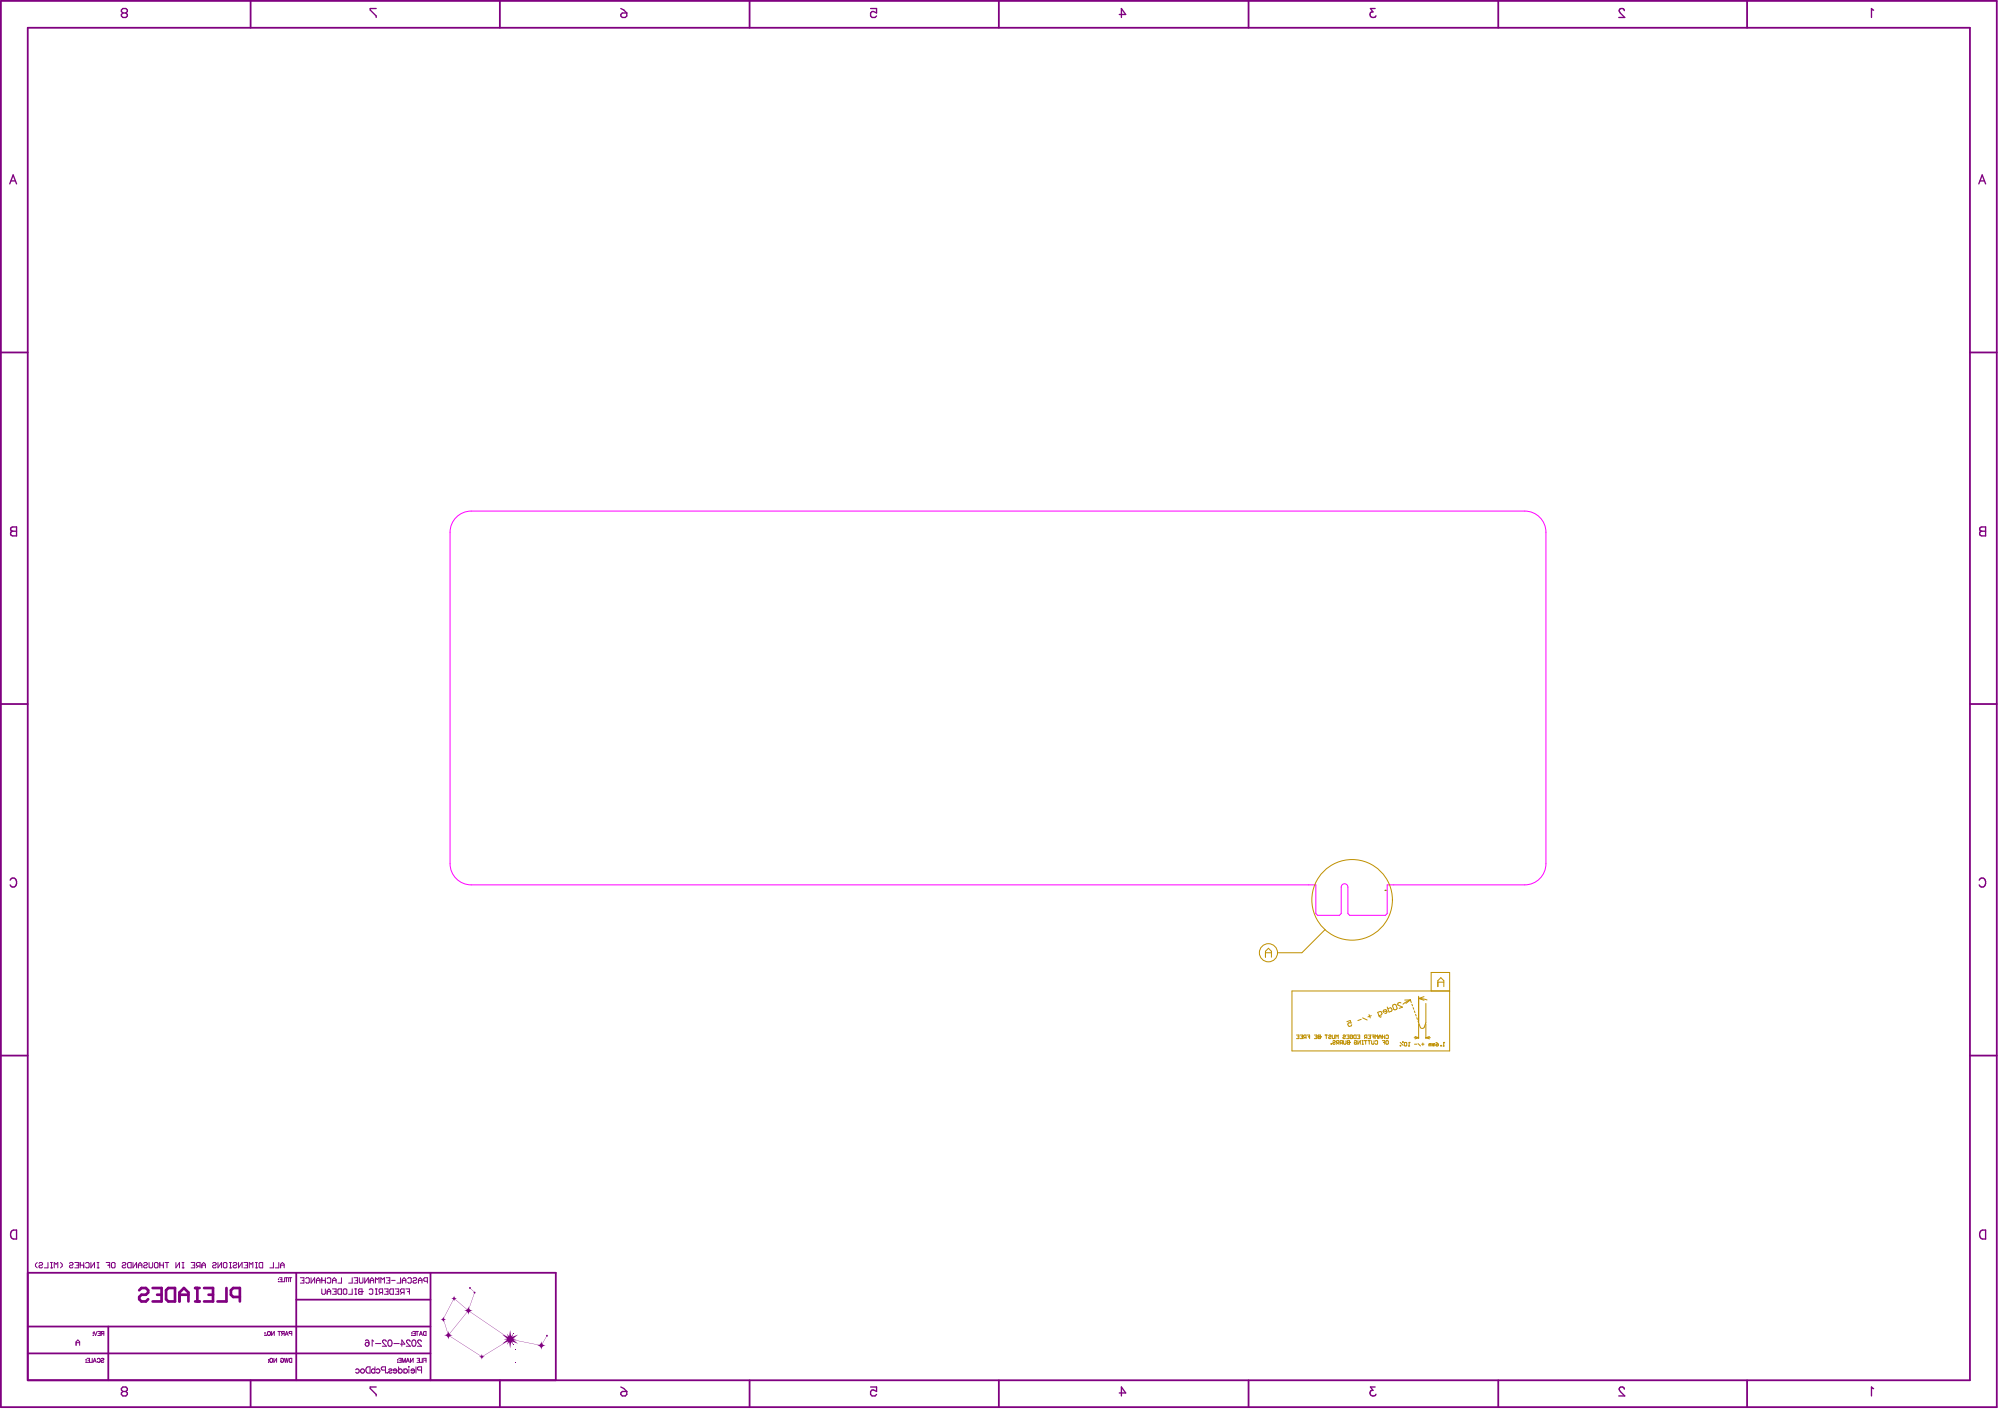
[picture p30: page 2]

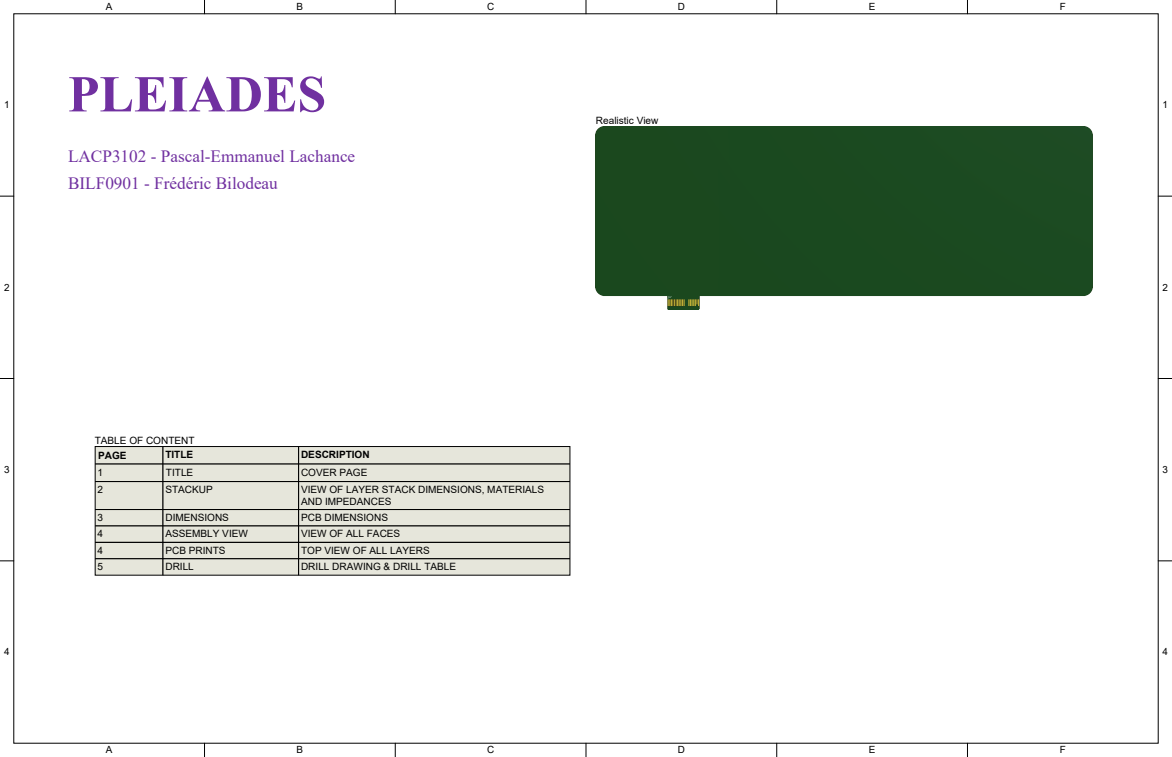
[picture p31: page 3]

PAGE | TITLE | DESCRIPTION
1 | TITLE | COVER PAGE
2 | STACKUP | VIEW OF LAYER STACK DIMENSIONS, MATERIALS AND IMPEDANCES

3 | DIMENSIONS | PCB DIMENSIONS
4 | ASSEMBLY VIEW | VIEW OF ALL FACES
4 | PCB PRINTS | TOP VIEW OF ALL LAYERS
5 | DRILL | DRILL DRAWING & DRILL TABLE

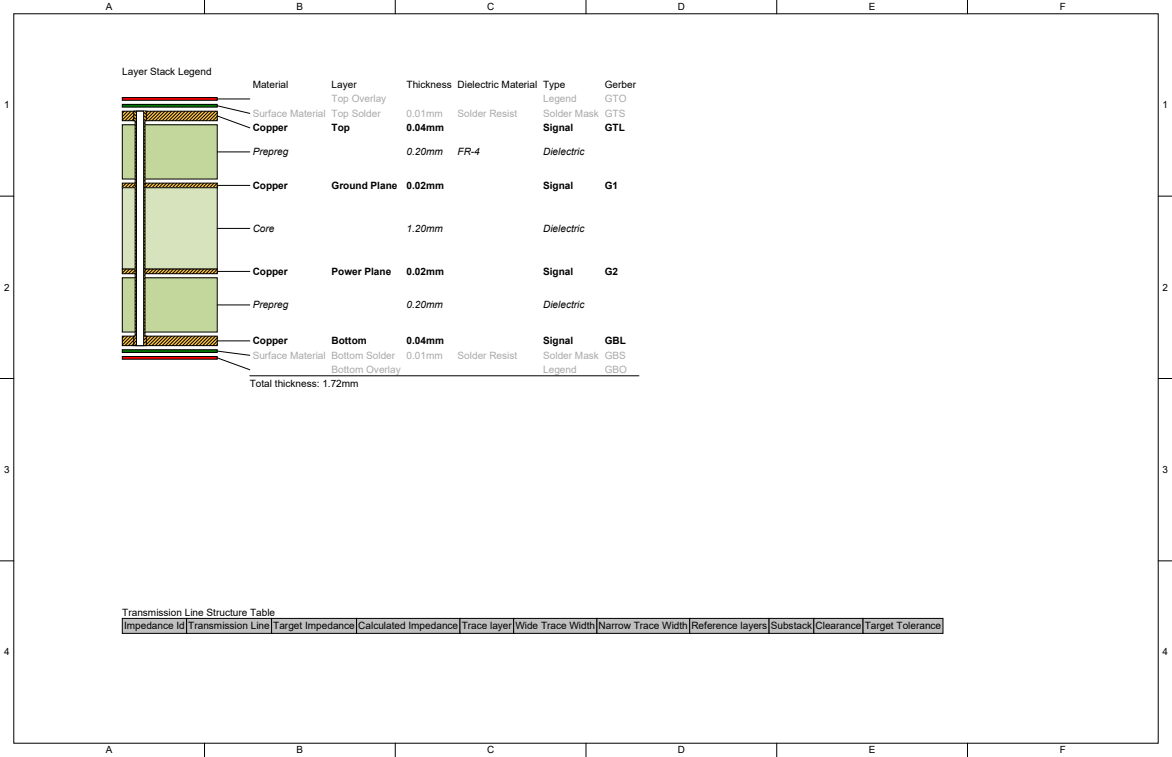
[picture p32: page 4]

Transmission Line Structure Table

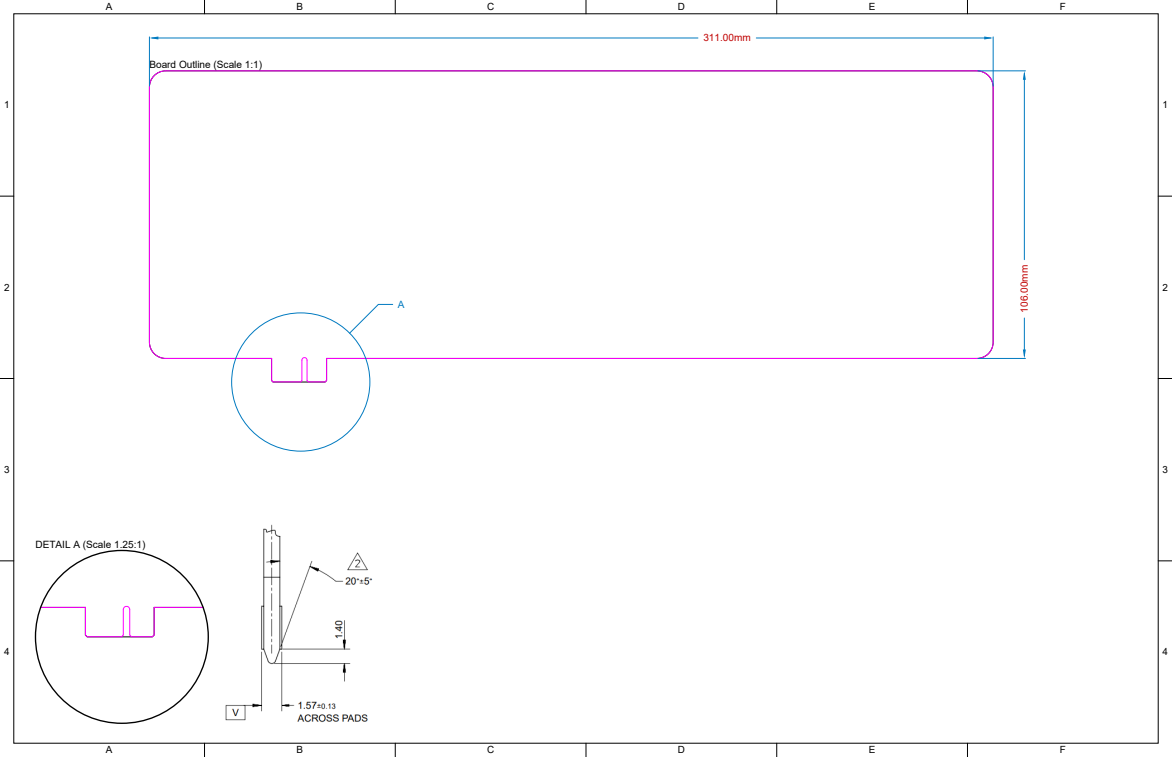
[picture p33: page 5]

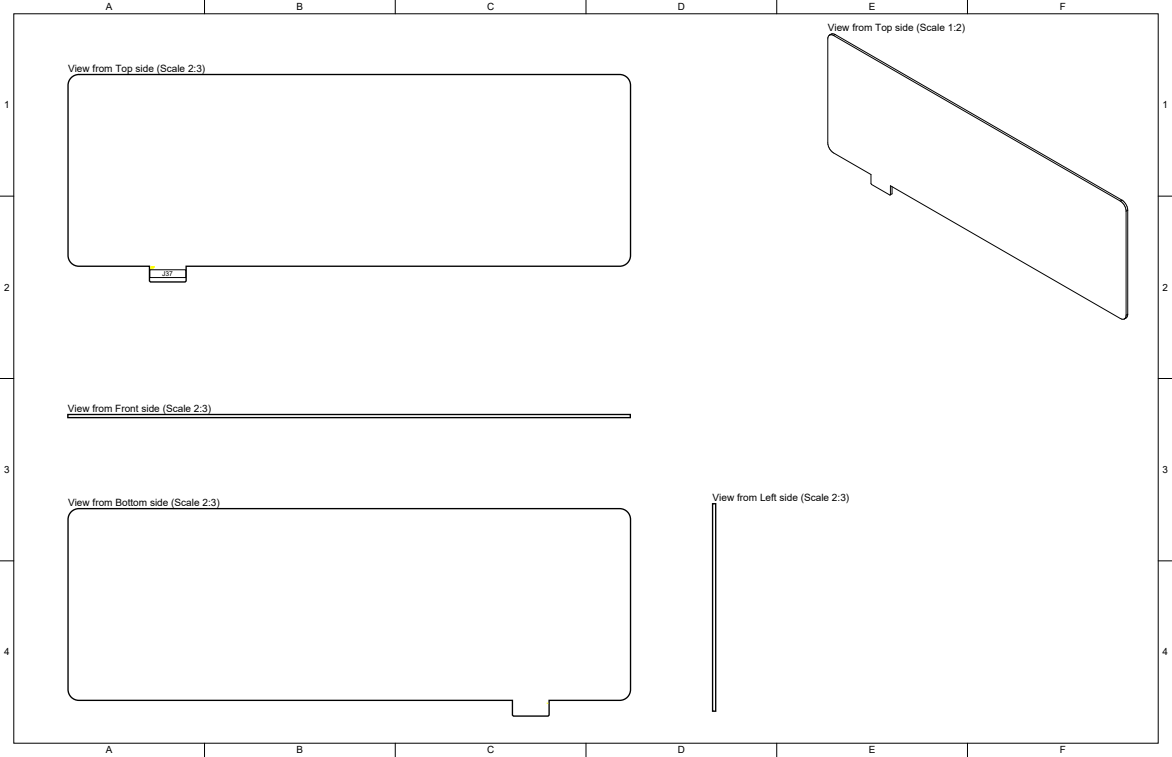
[picture p34: page 6]

View from Top side (Scale 1:2)

View from Top side (Scale 2:3)

View from Front side (Scale 2:3)

View from Left side (Scale 2:3)

View from Bottom side (Scale 2:3)

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
