Raesangur/UdeS_S7_APP1/Schematics/INFO.pdf

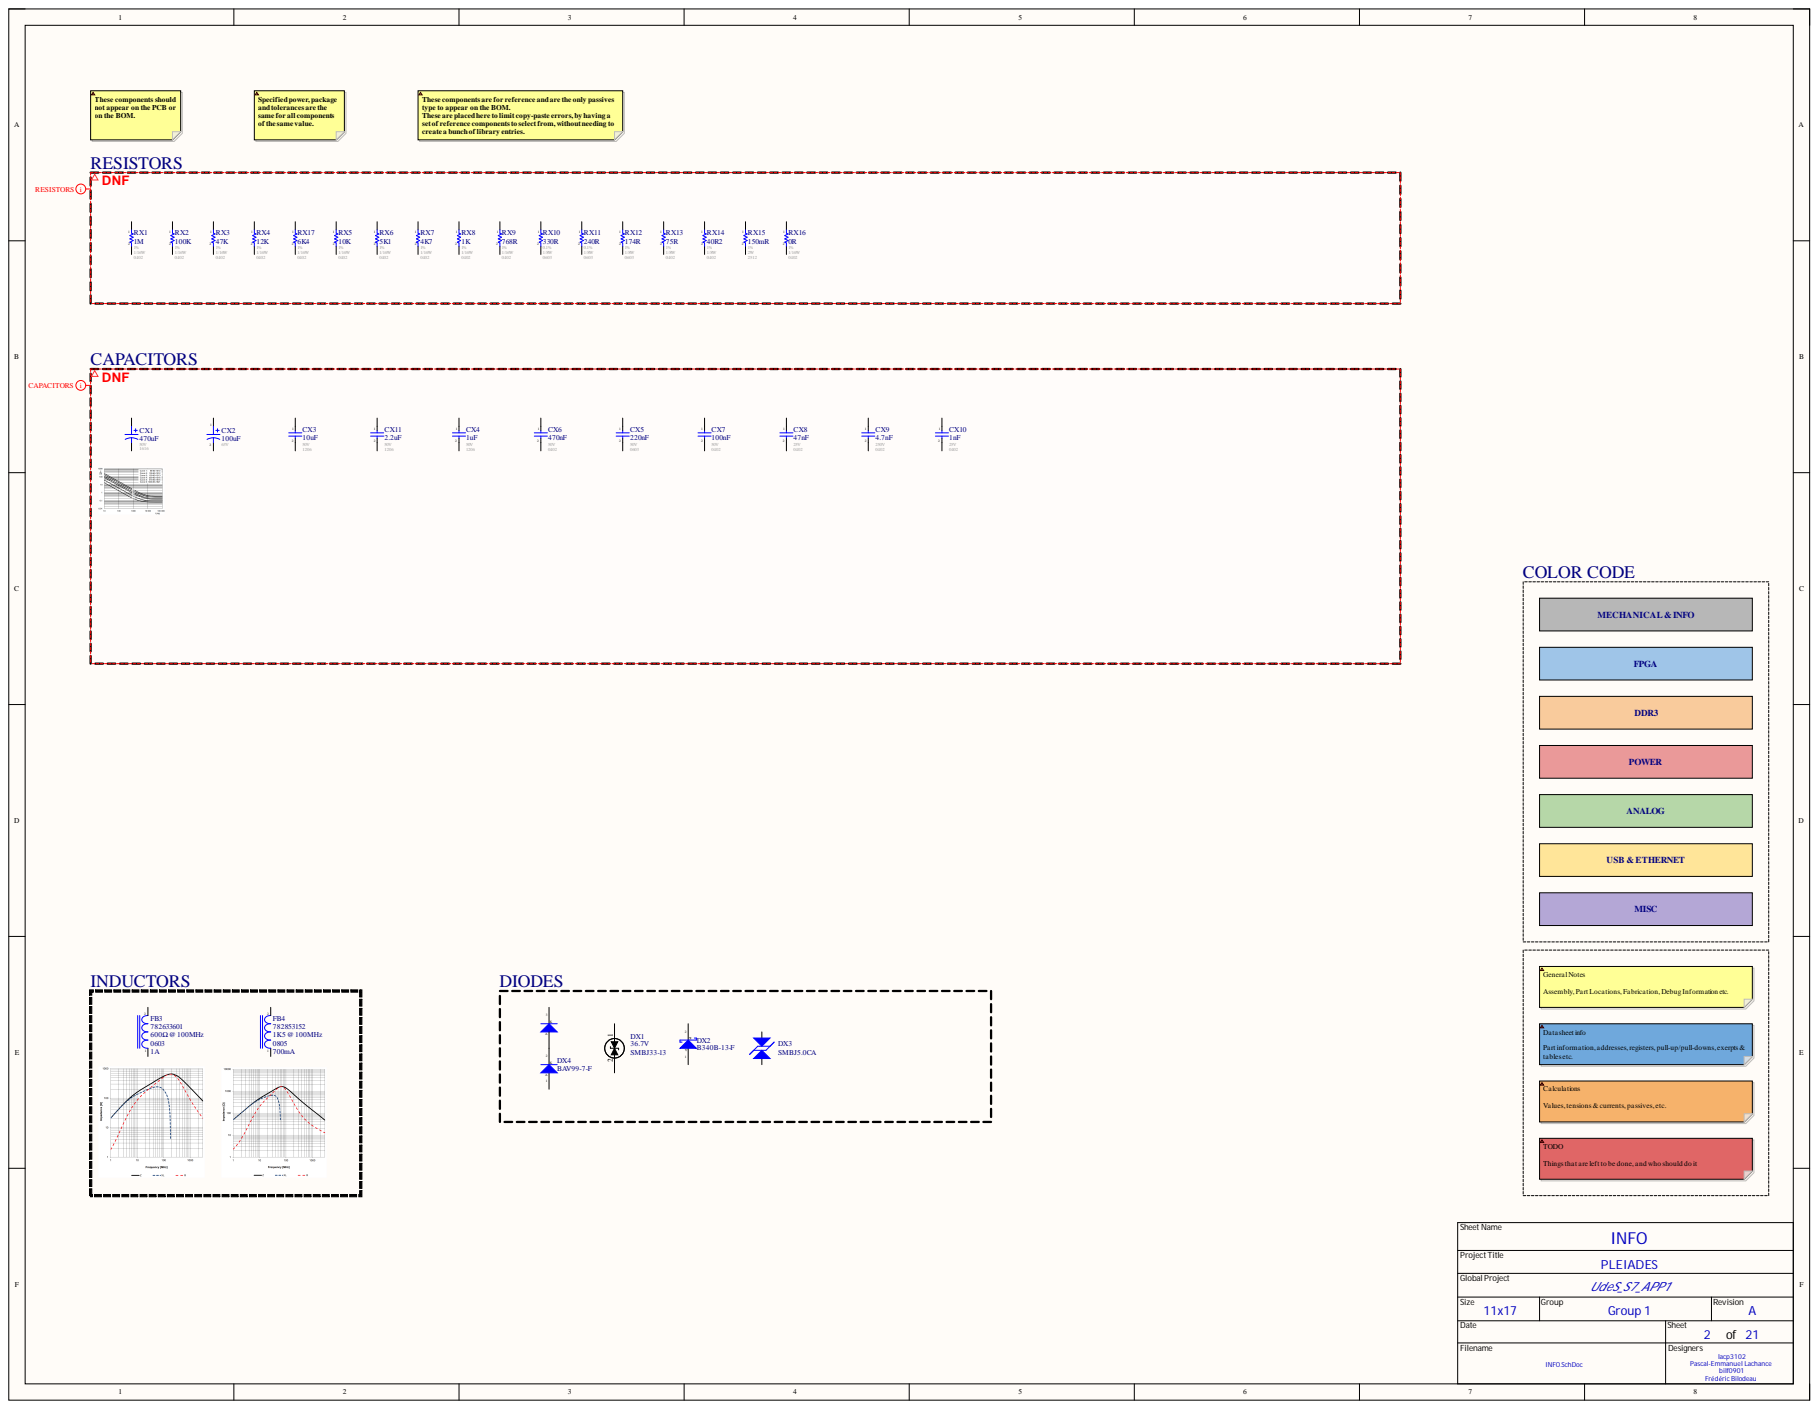
[picture p35: page 1]

These components should
not appear on the PCB or
on the BOM.

Specifiedpower,package
andtolerances are the
same for all components
of the same value.

These components are for reference andare the only passives
type to appear on the BOM.
These are placedhere to limit copy-paste errors, by having a
set of reference components to selectfrom,withoutneeding to
create a bunchof library entries.

Assembly,Part Locations, Fabrication,DebugInformation etc.

Part information, addresses,registers, pull-up/pull-downs, exerpts &
tables etc.

Values, tensions & currents, passives, etc.

Things that are left to be done, and who should do it

Size 11x17 | Group Group 1 | Revision A

Date | Sheet 2 of Designers 21

Filename INFO.SchDoc | lacp3102 Pascal-Emmanuel Lachance bilf0901 Frédéric Bilodeau

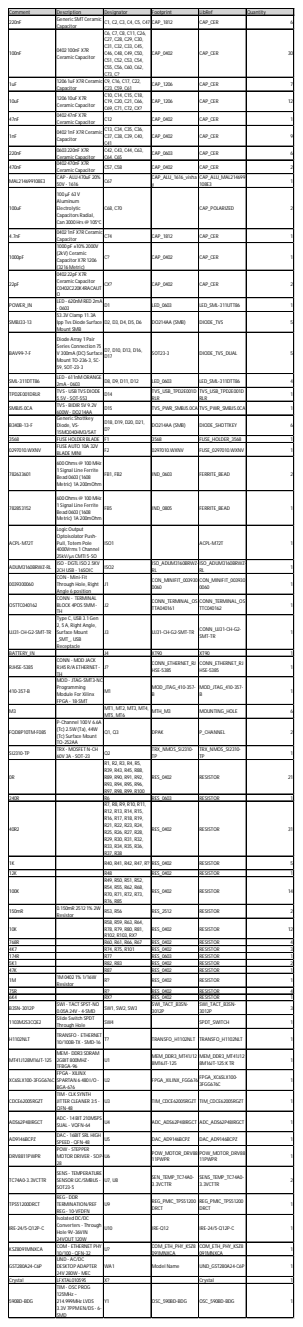
[picture p36: page 2]

220nF | Generic SMT Ceramic Capacitor | C1, C2, C3, C4, C5, C47 | CAP_1812 | CAP_CER | | 6

100nF | 0402 100nF X7R Ceramic Capacitor | C6, C7, C8, C11, C26, C27, C28, C29, C30, C31, C32, C33, C45, C46, C48, C49, C50, C51, C52, C53, C54, C55, C56, C60, C62, C73, C? | CAP_0402 | CAP_CER | 30

1uF | 1206 1uF X7R Ceramic Capacitor | C9, C16, C17, C22, C23, C59, C61 | CAP_1206 | CAP_CER | | 7

10uF | 1206 10uF X7R Ceramic Capacitor | C10, C14, C15, C18, C19, C20, C21, C66, C69, C71, C72, CX? | CAP_1206 | CAP_CER | 12

47nF | 0402 47nF X7R Ceramic Capacitor | C12 | CAP_0402 | CAP_CER | | 1

1nF | 0402 1nF X7R Ceramic Capacitor | C13, C34, C35, C36, C37, C38, C39, C40, C41 | CAP_0402 | CAP_CER | | 9

220nF | 0603 220nF X7R Ceramic Capacitor | C42, C43, C44, C63, C64, C65 | CAP_0603 | CAP_CER | | 6

470nF | 0402 470nF X7R Ceramic Capacitor | C57, C58 | CAP_0402 | CAP_CER | | 2

MAL214699108E3 | CAP - ALU470uF 20% 50V - 1616 | C67 | CAP_ALU_1616_visha y | CAP_ALU_MAL214699 108E3 | | 1

100uF | 100 µF 63 V Aluminum Electrolytic Capacitors Radial, Can 3000 Hrs @ 105°C | C68, C70 | | CAP_POLARIZED | | 2

4.7nF | 0402 1nF X7R Ceramic Capacitor | C74 | CAP_1812 | CAP_CER | | 1

1000pF | 1000 pF ±10% 2000V (2kV) Ceramic Capacitor X7R 1206 (3216 Metric) | C? | CAP_0402 | CAP_CER | | 1

22pF | 0402 22pF X7R Ceramic Capacitor C0402C220K4RACAUT O | CX? | CAP_0402 | CAP_CER | | 2

POWER_IN | LED - 620nM RED 2mA - 0603 | D1 | LED_0603 | LED_SML-311UTT86 | | 1

SMBJ33-13 | 53.3V Clamp 11.3A Ipp Tvs Diode Surface Mount SMB | D2, D3, D4, D5, D6 | DO214AA (SMB) | DIODE_TVS | | 5

BAV99-7-F | Diode Array 1 Pair Series Connection 75 V 300mA (DC) Surface Mount TO-236-3, SC-59, SOT-23-3 | D7, D10, D13, D16, D17 | SOT23-3 | DIODE_TVS_DUAL | | 5

SML-311DTT86 | LED - 611nM ORANGE 2mA - 0603 | D8, D9, D11, D12 | LED_0603 | LED_SML-311DTT86 | | 4

TPD2E001DRLR | TVS - USB TVS DIODE 5.5V - SOT-553 | D14 | TVS_USB_TPD2E001D RLR | TVS_USB_TPD2E001D RLR | | 1

SMBJ5.0CA | TVS - BIDIR 5V 9.2V 600W - DO214AA | D15 | TVS_PWR_SMBJ5.0CA | TVS_PWR_SMBJ5.0CA | | 1

B340B-13-F | Generic Shottkey Diode, VS-15MQ040HM3/5AT | D18, D19, D20, D21, D? | DO214AA (SMB) | DIODE_SHOTTKEY | | 6

3568 0297010.WXNV | FUSE HOLDER BLADE FUSE AUTO 10A 32V BLADE MINI | F1 F2 | 3568 0297010.WXNV | FUSE_HOLDER_3568 FUSE_0297010.WXNV | | 1 1

782633601 | 600Ohms @ 100 MHz 1 Signal Line Ferrite Bead 0603 (1608 Metric) 1A 200mOhm | FB1, FB2 | IND_0603 | FERRITE_BEAD | | 2

782853152 | 600Ohms @ 100 MHz 1 Signal Line Ferrite Bead 0603 (1608 Metric) 1A 200mOhm | FB5 | IND_0805 | FERRITE_BEAD | | 1

ACPL-M72T | Logic Output Optoisolator Push-Pull, Totem Pole 4000Vrms 1 Channel 25kV/µs CMTI 5-SO | ISO1 | | ACPL-M72T | | 1

ADUM3160BRWZ-RL | ISO - DGTL ISO 2.5KV 2CH USB - 16SOIC | ISO2 | ISO_ADUM3160BRWZ-RL | ISO_ADUM3160BRWZ-RL | | 1

0039300060 | CON - Mini-Fit Through Hole, Right Angle 6 position | J1 | CON_MINIFIT_003930 0060 | CON_MINIFIT_003930 0060 | | 1

OSTTC040162 | CONN - TERMINAL BLOCK 4POS 5MM -TH | J2 | CONN_TERMINAL_OS TTA040161 | CONN_TERMINAL_OS TTC040162 | | 1

UJ31-CH-G2-SMT-TR | Type C, USB 3.1 Gen 2, 5 A, Right Angle, Surface Mount _SMT_, USB Receptacle | J3 | UJ31-CH-G2-SMT-TR | CONN_UJ31-CH-G2-SMT-TR | | 1

BATTERY_IN | | J4 | XT90 | XT90 | | 1
RJHSE-5385 | CONN - MOD JACK RJ45 R/A ETHERNET -TH | J? | CONN_ETHERNET_RJ HSE-5385 | CONN_ETHERNET_RJ HSE-5385 | | 1

410-357-B | MOD - JTAG-SMT3-NC Programming Module For Xilinx FPGA - 18-SMT | M1 | MOD_JTAG_410-357-B | MOD_JTAG_410-357-B | | 1

M3 | | MT1, MT2, MT3, MT4, MT5, MT6 | MTH_M3 | MOUNTING_HOLE | | 6

FQD8P10TM-F085 | P-Channel 100 V 6.6A (Tc) 2.5W (Ta), 44W (Tc) Surface Mount TO-252AA | Q1, Q3 | DPAK | P_CHANNEL | | 2

SI2310-TP | TRX - MOSFET N-CH 60V 3A - SOT-23 | Q2 | TRX_NMOS_SI2310-TP | TRX_NMOS_SI2310-TP | | 1

0R | | R1, R2, R3, R4, R5, R39, R43, R45, R88, R89, R90, R91, R92, R93, R94, R95, R96, R97, R98, R99, R100 | RES_0402 | RESISTOR | 21

240R | | R6 | RES_0603 | RESISTOR | | 1
40R2 | | R7, R8, R9, R10, R11, R12, R13, R14, R15, R16, R17, R18, R19, R21, R22, R23, R24, R25, R26, R27, R28, R29, R30, R31, R32, R33, R34, R35, R36, R37, R38 | RES_0402 | RESISTOR | 31

1K | | R40, R41, R42, R47, R? | RES_0402 | RESISTOR | | 5

12K | | R48 | RES_0402 | RESISTOR | | 1
100K | | R49, R50, R51, R52, R54, R55, R62, R68, R70, R71, R72, R73, R76, R85 | RES_0402 | RESISTOR | 14

150mR | 0.150mR 2512 1% 2W Resistor | R53, R56 | RES_2512 | RESISTOR | | 2

10K | | R58, R59, R63, R64, R78, R79, R80, R81, R102, R103, RX? | RES_0402 | RESISTOR | 12

768R | | R60, R61, R66, R67 | RES_0402 | RESISTOR | | 4
4K7 | | R74, R75, R101 | RES_0402 | RESISTOR | | 3
174R | | R77 | RES_0603 | RESISTOR | | 1
5K1 | | R82, R83 | RES_0402 | RESISTOR | | 2
47K | | R87 | RES_0402 | RESISTOR | | 1
1M | 1M 0402 1% 1/16W Resistor | R? | RES_0402 | RESISTOR | | 1

75R 6K4 | | R? RX? | RES_0402 | RESISTOR | | 4 1

B3SN-3012P | SWI - TACT SPST-NO 0.05A 24V - 4-SMD | SW1, SW2, SW3 | SWI_TACT_B3SN-3012P | SWI_TACT_B3SN-3012P | | 3

1103M2S3CQE2 | Slide Switch SPDT Through Hole | SW4 | | SPDT_SWITCH | | 1

H1102NLT | TRANSFO - ETHERNET 10/100B-TX - SMD-16 | T? | TRANSFO_H1102NLT | TRANSFO_H1102NLT | | 1

MT41J128M16JT-125 | MEM - DDR3 SDRAM 2GBIT 800MHZ -TFBGA-96 | U1 | MEM_DDR3_MT41J12 8M16JT-125 | MEM_DDR3_MT41J12 8M16JT-125:K TR | | 1

XC6SLX100-3FGG676C | FPGA - XILINX SPARTAN 6 480 I/O -BGA-676 | U2 | FPGA_XILINX_FGG676 FPGA_XC6SLX100- | 3FGG676C | | 1

CDCE62005RGZT | TIM - CLK SYNTH JITTER CLEANER 3:5 -QFN-48 | U3 | TIM_CDCE62005RGZT | TIM_CDCE62005RGZT | | 1

ADS62P48IRGCT | ADC - 14 BIT 210MSPS SUAL - VQFN-64 | U4 | ADC_ADS62P48IRGCT | ADC_ADS62P48IRGCT | | 1

AD9146BCPZ | DAC - 16BIT SRL HIGH SPEED - QFN-48 | U5 | DAC_AD9146BCPZ | DAC_AD9146BCPZ | | 1

DRV8811PWPR | POW - STEPPER MOTOR DRIVER - SOP-28 | U6 | POW_MOTOR_DRV88 11PWPR | POW_MOTOR_DRV88 11PWPR | | 1

TC74A0-3.3VCTTR | SENS - TEMPERATURE SENSOR I2C/SMBUS -SOT23-5 | U7, U8 | SEN_TEMP_TC74A0-3.3VCTTR | SENS_TEMP_TC74A0-3.3VCTTR | | 2

TPS51200DRCT | REG - DDR TERMINATION/REF REG - 10-VFDFN | U9 | REG_PMIC_TPS51200 DRCT | REG_PMIC_TPS51200 DRCT | | 1

IRE-24/5-Q12P-C | Isolated DC/DC Converters - Through Hole 9V-36VIN 24VOUT 120W | U10 | IRE-Q12 | IRE-24/5-Q12P-C | | 1

KSZ8091MNXCA | COM - ETHERNET PHY 10/100 - QFN-32 | U? | COM_ETH_PHY_KSZ8 091MNXCA | COM_ETH_PHY_KSZ8 091MNXCA | | 1

GST280A24-C6P | UND - AC/DC DESKTOP ADAPTER 24V 280W - MEC | WA1 | Model Name | UND_GST280A24-C6P | | 1

Crystal | LFXTAL010595 | X? | | Crystal | | 1
590BD-BDG | TIM - OSC PROG 125MHz ~ 214.999MHz LVDS 3.3V 7PPM EN/DS - 6-SMD | Y1 | OSC_590BD-BDG | OSC_590BD-BDG | | 1
