Raesangur/UdeS_S7_APP1/Simulations/Reverse Protection - Switch - Inrush Current Protection.asc

C1: cap; 500µ
C2: cap; 10µF
CURRENT_MOS: res; 0.001
D1: zener; BZX84B10VL
LOAD: res; 10
M1: pmos; AO6407
M2: pmos; IRFP9240
R2: res; 10K
R3: res; 1Meg
S1: sw; MYSWITCH
V1: voltage; 24
V2: voltage; PULSE(0 5 2m 1u 1u 2 4 2)
Named nets: 0, LOAD
.tran 100m
.model MYSWITCH SW (Ron=1 Roff=100MEG Vt=1 Vh=0.5)
