Raesangur/UdeS_S7_APP1/(list of files, drawings)

Other design files:
Layout/Pleiades.PcbDoc
Librairies/CryptLib/CryptLib.SchLib
Librairies/S7CAS_LIB2023.SchLib
Pleiades_P01.PrjPcb
Schematics/ADC.SchDoc
Schematics/CLOCK.SchDoc
Schematics/DAC.SchDoc
Schematics/DDR3.SchDoc
Schematics/ETHERNET.SchDoc
Schematics/FPGA_IO.SchDoc
Schematics/FPGA_MISC.SchDoc
Schematics/INFO.SchDoc
Schematics/JTAG.SchDoc
Schematics/MECHANICAL.SchDoc
Schematics/MOTOR_CONTROL.SchDoc
Schematics/OVERVIEW.SchDoc
Schematics/PCI.SchDoc
Schematics/POWER.SchDoc
Schematics/POWER_ANALOG.SchDoc
Schematics/POWER_DDR3.SchDoc
Schematics/POWER_FPGA.SchDoc
Schematics/POWER_INPUT.SchDoc
Schematics/POWER_MOTORS.SchDoc
Schematics/POWER_SENSING.SchDoc
Schematics/PROM.SchDoc
Schematics/SENSORS.SchDoc
Schematics/TITLE.SchDoc
Schematics/USB.SchDoc
Schematics/USER_IO.SchDoc
