Raesangur/UdeS_S7_APP1/(commit log)

2024-01-05 pdfs & lectures
    [Spartan3A_Spartan6_XPE_14_3.xlsx, ddr3_ddr3l_power_calc.xlsm]
2024-01-11 initial project setup - copied from CryptUS
    [CryptLib.SchLib, MECHANICAL.SchDoc, OVERVIEW.SchDoc, PCB.PrjPcb, TITLE.SchDoc]
2024-01-12 added library
    [Altium_Librairie_PCB_Default.PcbLib, Altium_Schematic_Default.SchDoc, DDR3.SchDoc, PCB.PrjPcb]
2024-01-12 DDR3 and FPGA placed in schematic
    [Altium_Librairie_PCB_Default.PcbLib, Altium_Schematic_Default.SchDoc, DDR3.SchDoc, FPGA.SchDoc, FPGA_IO_0_1_2.SchDoc, FPGA_IO_3_4_5.SchDoc, OVERVIEW.SchDoc, PCB.PrjPcb]
2024-01-12 adding pages for PROM, ADC & DAC
    [ADC.SchDoc, DAC.SchDoc, FPGA.SchDoc, FPGA_MISC.SchDoc, OVERVIEW.SchDoc, POWER_INPUT.SchDoc, PROM.SchDoc, TITLE.SchDoc]
2024-01-12 DDR3 to harness
    [DDR3.SchDoc, MECHANICAL.SchDoc, PCB.PrjPcb]
2024-01-16 added 22x17 schematic sheet
    [FPGA_IO_0_1_2.SchDoc]
2024-01-16 updated schematic templates
    [ADC.SchDoc, DAC.SchDoc, DDR3.SchDoc, FPGA.SchDoc, FPGA_IO.SchDoc, FPGA_IO_0_1_2.SchDoc, FPGA_IO_3_4_5.SchDoc, FPGA_MISC.SchDoc]
2024-01-16 harnessing DDR3
    [DDR3.SchDoc, INFO.SchDoc, OVERVIEW.SchDoc, S7CAS_LIB2023.SchLib, TITLE.SchDoc]
2024-01-16 Fred: avancements MOTORS CONTROL, Pascal: DDR3 (Discord as a git)
    [DDR3.SchDoc, INFO.SchDoc, MOTOR_CONTROL-1.SchDoc, MOTOR_CONTROL.SchDoc, OVERVIEW.SchDoc, PCB.PrjPcb, POWER_INPUT.SchDoc, S7CAS_LIB2023.SchLib]
2024-01-16 Fred: ajout ESD sur les sorties moteurs
    [MOTOR_CONTROL.SchDoc]
2024-01-16 Fred: avancements sur le USER_IO & POWER_INPUT
    [INFO.SchDoc, MOTOR_CONTROL.SchDoc, OVERVIEW.SchDoc, PCB.PrjPcb, POWER_INPUT.SchDoc, S7CAS_LIB2023.SchLib, USER_IO.SchDoc]
2024-01-16 designators annotated
    [DDR3.SchDoc, FPGA_IO.SchDoc, INFO.SchDoc, MOTOR_CONTROL.SchDoc, USER_IO.SchDoc]
2024-01-16 Fred: avancements DDR3 sur le FPGA, etc. footprint 100uf et misc
    [FPGA_IO.SchDoc, FPGA_MISC.SchDoc, MOTOR_CONTROL.SchDoc, OVERVIEW.SchDoc, PCB.PrjPcb, S7CAS_LIB2023.SchLib]
2024-01-16 DDR3 power calculations
    [DDR3.SchDoc, INFO.SchDoc, Spartan3A_Spartan6_XPE_14_3.xlsx]
2024-01-17 Fred: fin de soiree
    [INFO.SchDoc, MOTOR_CONTROL.SchDoc]
2024-01-17 setup clock
    [CLOCK.SchDoc, DDR3.SchDoc, INFO.SchDoc, OVERVIEW.SchDoc, S7CAS_LIB2023.SchLib, ddr3_ddr3l_power_calc.xlsm]
2024-01-20 clock and IO
    [ADC.SchDoc, CLOCK.SchDoc, DAC.SchDoc, DDR3.SchDoc, FPGA_IO.SchDoc, FPGA_MISC.SchDoc, INFO.SchDoc, MOTOR_CONTROL.SchDoc]
2024-01-20 POWER pages
    [CLOCK.SchDoc, DDR3.SchDoc, INFO.SchDoc, MOTOR_CONTROL-1.SchDoc, MOTOR_CONTROL.SchDoc, OVERVIEW.SchDoc, POWER.SchDoc, POWER_ANALOG.SchDoc]
2024-01-20 more powerÉ
    [PCB.PrjPcb]
2024-01-21 un peu de travail sur l'arbre d'alimentation
    [MOTOR_CONTROL.SchDoc, PCB.PrjPcb, POWER.SchDoc, POWER_ANALOG.SchDoc, POWER_DDR3.SchDoc, POWER_FPGA.SchDoc, POWER_INPUT.SchDoc, POWER_MOTORS.SchDoc]
2024-01-22 ddr3 and more
    [ADC.SchDoc, CLOCK.SchDoc, DAC.SchDoc, DDR3.SchDoc, FPGA_IO.SchDoc, FPGA_MISC.SchDoc, INFO.SchDoc, MOTOR_CONTROL.SchDoc]
2024-01-23 edited all capacitors - work on USB, work on clock, ESD for motors
    [CLOCK.SchDoc, DDR3.SchDoc, FPGA_IO.SchDoc, INFO.SchDoc, MECHANICAL.SchDoc, MOTOR_CONTROL.SchDoc, POWER_DDR3.SchDoc, POWER_INPUT.SchDoc]
2024-01-23 ah fuck
    [INFO.SchDoc, MOTOR_CONTROL.SchDoc, PCB.PrjPcb, POWER_INPUT.SchDoc, USB.SchDoc]
2024-01-23 power input control switch and inrush current protection
    [INFO.SchDoc, MECHANICAL.SchDoc, MOTOR_CONTROL.SchDoc, PCB.PrjPcb, POWER_INPUT.SchDoc, USB.SchDoc]
2024-01-24 clenaup cx and rx numbers
    [INFO.SchDoc]
2024-01-24 USB finished
    [USB.SchDoc]
2024-01-24 fred ethernet part 1
    [ETHERNET.SchDoc]
2024-01-24 POWER INPUT
    [INFO.SchDoc, MOTOR_CONTROL.SchDoc, PCB.PrjPcb, POWER.SchDoc, POWER_INPUT.SchDoc, USB.SchDoc]
2024-01-24 info page, added inductors and diodes, added 2.2uF
    [INFO.SchDoc, MECHANICAL.SchDoc]
2024-01-24 fred avancement ethernet part 2
    [ETHERNET.SchDoc]
2024-01-25 fin du refactor de la page d'info, avec les informations d'impédance et modèles de condensateurs
    [CLOCK.SchDoc, ETHERNET.SchDoc, INFO.SchDoc, USB.SchDoc, USER_IO.SchDoc]
2024-01-25 fin du power
    [ADC.SchDoc, DAC.SchDoc, ETHERNET.SchDoc, INFO.SchDoc, MECHANICAL.SchDoc, MOTOR_CONTROL.SchDoc, POWER.SchDoc, POWER_DDR3.SchDoc]
2024-01-26 DDR3 power work
    [MECHANICAL.SchDoc, PCB.PrjPcb, POWER_DDR3.SchDoc, POWER_INPUT.SchDoc, S7CAS_LIB2023.SchLib, regulators.xlsx]
2024-01-26 fred ethernet
    [ETHERNET.SchDoc]
2024-01-26 Oscillator, edited ETH PHY symbol to fit on grid
    [ETHERNET.SchDoc]
2024-01-26 fred ethernet fini sans le footprint du crystal
    [ETHERNET.SchDoc]
2024-01-26 fred started DAC
    [DAC.SchDoc]
2024-01-26 ETHERNET design review and todo ; force annotate
    [ETHERNET.SchDoc, INFO.SchDoc, MOTOR_CONTROL.SchDoc, POWER_DDR3.SchDoc, POWER_INPUT.SchDoc, POWER_MOTORS.SchDoc, USB.SchDoc, USER_IO.SchDoc]
2024-01-26 fred dod ethernet + dac a lil bit
    [ETHERNET.SchDoc]
2024-01-26 DDR3 power completed
    [INFO.SchDoc, PCB.PrjPcb, POWER.SchDoc, POWER_DDR3.SchDoc, POWER_SENSING.SchDoc]
2024-01-26 current and voltage sensing
    [DAC.SchDoc, ETHERNET.SchDoc, INFO.SchDoc, MOTOR_CONTROL.SchDoc, POWER.SchDoc, POWER_DDR3.SchDoc, POWER_MOTORS.SchDoc, POWER_SENSING.SchDoc]
2024-01-26 info on title page
    [PCB.PrjPcb, POWER_DDR3.SchDoc, POWER_SENSING.SchDoc, TITLE.SchDoc]
2024-01-26 fred apres le dejeuner
    [DAC.SchDoc, ETHERNET.SchDoc]
2024-01-26 adc work
    [ADC.SchDoc, FPGA_MISC.SchDoc, MOTOR_CONTROL.SchDoc, POWER.SchDoc, POWER_ANALOG.SchDoc, POWER_SENSING.SchDoc, PROM.SchDoc, USB.SchDoc]
2024-01-26 added 330pF and 100nH
    [ADC.SchDoc, INFO.SchDoc, OVERVIEW.SchDoc, PCB.PrjPcb, POWER_DDR3.SchDoc, RCL Filter.xlsx, S7CAS_LIB2023.SchLib]
2024-01-26 fred: avancement dac
    [DAC.SchDoc]
2024-01-26 changing power TP
    [ADC.SchDoc, CLOCK.SchDoc, POWER_MOTORS.SchDoc, USB.SchDoc]
2024-01-26 fred: avant de me faire battree par kelly
    [DAC.SchDoc, ETHERNET.SchDoc, INFO.SchDoc, MOTOR_CONTROL.SchDoc, OVERVIEW.SchDoc, PCB.PrjPcb]
2024-01-26 todo graph
    [ADC.SchDoc, CLOCK.SchDoc, DAC.SchDoc, DDR3.SchDoc, ETHERNET.SchDoc, FPGA_IO.SchDoc, FPGA_MISC.SchDoc, INFO.SchDoc]
2024-01-26 fred: fin ethernet (ajout du graph de decouplage)
    [ETHERNET.SchDoc]
2024-01-26 fred fin de cours
    [DAC.SchDoc]
2024-01-27 input gain calculation for ADC
    [ADC.SchDoc, RCL Filter.xlsx, S7CAS_LIB2023.SchLib, USER_IO.SchDoc, regulators.xlsx]
2024-01-27 fred: modifs
    [DAC.SchDoc, INFO.SchDoc, OVERVIEW.SchDoc]
2024-01-27 annotate ; adc filtering done ; ethernet TVS
    [ADC.SchDoc, CLOCK.SchDoc, DAC.SchDoc, ETHERNET.SchDoc, INFO.SchDoc, MOTOR_CONTROL.SchDoc, PCB.PrjPcb, POWER_DDR3.SchDoc]
2024-01-27 finishing ADC connections
    [ADC.SchDoc, INFO.SchDoc, S7CAS_LIB2023.SchLib]
2024-01-27 fred: fini dac
    [DAC.SchDoc]
2024-01-27 progress checkup
    [ADC.SchDoc, CLOCK.SchDoc, ETHERNET.SchDoc, INFO.SchDoc, OVERVIEW.SchDoc, PCB.PrjPcb, PROM.SchDoc, S7CAS_LIB2023.SchLib]
2024-01-27 ADC Decoupling
    [ADC.SchDoc, INFO.SchDoc]
2024-01-27 refactoring pages
    [CLOCK.SchDoc, DDR3.SchDoc, RCL Filter.xlsx]
2024-01-27 Analog power bilan, refactoring
    [ADC.SchDoc, CLOCK.SchDoc, DAC.SchDoc, DDR3.SchDoc, ETHERNET.SchDoc, INFO.SchDoc, MECHANICAL.SchDoc, MOTOR_CONTROL.SchDoc]
2024-01-28 starting analog power
    [INFO.SchDoc, POWER_ANALOG.SchDoc, POWER_DDR3.SchDoc]
2024-01-28 fred: fin PROM
    [PROM.SchDoc]
2024-01-28 negative -5VA
    [INFO.SchDoc, POWER_ANALOG.SchDoc]
2024-01-28 fred: add 4.7uF to info and start cap for fpga
    [FPGA_MISC.SchDoc, INFO.SchDoc, OVERVIEW.SchDoc]
2024-01-28 analog LDO
    [ADC.SchDoc, INFO.SchDoc, PCB.PrjPcb, POWER.SchDoc, POWER_ANALOG.SchDoc]
2024-01-28 fred: decoupling fgpa done
    [FPGA_MISC.SchDoc]
2024-01-28 Power page layout for Analog
    [POWER.SchDoc, POWER_ANALOG.SchDoc, POWER_SENSING.SchDoc]
2024-01-28 Analog Power Done
    [DAC.SchDoc, POWER.SchDoc, POWER_ANALOG.SchDoc]
2024-01-28 pascal signing off for tonight
    [PCB.PrjPcb]
2024-01-28 sync fred pascal
    [ADC.SchDoc, CLOCK.SchDoc, DAC.SchDoc, ETHERNET.SchDoc, FPGA_MISC.SchDoc, INFO.SchDoc, MOTOR_CONTROL.SchDoc, POWER_ANALOG.SchDoc]
2024-01-28 fred: sync motor
    [MOTOR_CONTROL.SchDoc, PCB.PrjPcb]
2024-01-28 new DDR3
    [ADC.SchDoc, CLOCK.SchDoc, CryptLib.SchLib, DAC.SchDoc, DDR3.SchDoc, ETHERNET.SchDoc, FPGA_IO.SchDoc, FPGA_MISC.SchDoc]
2024-01-28 DDR3 decoupling
    [DDR3.SchDoc, INFO.SchDoc, PCB.PrjPcb, POWER_DDR3.SchDoc, POWER_INPUT.SchDoc]
2024-01-28 fred: fin moteur sur la page motor control
    [MOTOR_CONTROL.SchDoc]
2024-01-28 fred: power final done
    [MOTOR_CONTROL.SchDoc, POWER.SchDoc, POWER_MOTORS.SchDoc]
2024-01-28 DDR3 thermal management
    [DDR3.SchDoc, ETHERNET.SchDoc, INFO.SchDoc, OVERVIEW.SchDoc, USB.SchDoc]
2024-01-28 fred: thermal ldo
    [POWER_MOTORS.SchDoc]
2024-01-28 heatsinks, mass Annotate
    [ADC.SchDoc, CLOCK.SchDoc, DAC.SchDoc, DDR3.SchDoc, ETHERNET.SchDoc, FPGA_IO.SchDoc, FPGA_MISC.SchDoc, INFO.SchDoc]
2024-01-29 fred: Added step files of the heatsink
    [legros..FCStd, legros.iges, leptit.FCStd, leptit.iges]
2024-01-29 checkup après design review
    [ADC.SchDoc, CLOCK.SchDoc, DAC.SchDoc, DDR3.SchDoc, ETHERNET.SchDoc, FPGA_IO.SchDoc, FPGA_MISC.SchDoc, INFO.SchDoc]
2024-01-29 fred: added screws on mecanical page
    [MECHANICAL.SchDoc]
2024-01-29 fred: Added M3 screw to mechanical
    [MECHANICAL.SchDoc]
2024-01-29 Analog on 5VA Opamps
    [ADC.SchDoc, DAC.SchDoc, INFO.SchDoc, POWER_ANALOG.SchDoc]
2024-01-29 fred: screw ddr footprint heatsink
    [DDR3.SchDoc, legros.-Body.step, legros..FCStd, leptit-Body.iges, leptit-Body.step]
2024-01-29 ADC clock input impedance matching
    [ADC.SchDoc, DDR3.SchDoc, MECHANICAL.SchDoc, PCB.PrjPcb, S7CAS_LIB2023.SchLib]
2024-01-29 ADC terminaitions
    [ADC.SchDoc]
2024-01-29 fred: dac
    [DAC.SchDoc]
2024-01-29 good adc termination
    [ADC.SchDoc, OVERVIEW.SchDoc]
2024-01-29 fred: dac done
    [DAC.SchDoc]
2024-01-29 power cleanup -> passage à 12V
    [POWER.SchDoc, POWER_ANALOG.SchDoc, POWER_DDR3.SchDoc, POWER_INPUT.SchDoc, POWER_MOTORS.SchDoc]
2024-01-29 fred: power fgpa pre review
    [POWER_FPGA.SchDoc]
2024-01-29 oscillator optimization
    [CLOCK.SchDoc]
2024-01-29 fred : ye tard
    [ADC.SchDoc, DDR3.SchDoc, MECHANICAL.SchDoc, MOTOR_CONTROL.SchDoc, OVERVIEW.SchDoc]
2024-01-29 PLL Decoupling
    [CLOCK.SchDoc]
2024-01-29 fred drc passes 1
    [CLOCK.SchDoc, DAC.SchDoc, ETHERNET.SchDoc, POWER_INPUT.SchDoc]
2024-01-29 VTT decoupling
    [DDR3.SchDoc]
2024-01-29 FPGA power refactoring, FPGA decoupling connected
    [FPGA_MISC.SchDoc, MECHANICAL.SchDoc, POWER_FPGA.SchDoc]
2024-01-29 fred batch 2
    [DAC.SchDoc, DDR3.SchDoc, FPGA_IO.SchDoc, MOTOR_CONTROL.SchDoc, OVERVIEW.SchDoc, POWER_ANALOG.SchDoc, POWER_SENSING.SchDoc]
2024-01-29 heatsink footprints
    [DDR3.SchDoc, FPGA_MISC.SchDoc]
2024-01-29 FPGA configuration
    [DDR3.SchDoc, FPGA_MISC.SchDoc, INFO.SchDoc, MECHANICAL.SchDoc]
2024-01-29 fred: dodo
    [ADC.SchDoc, FPGA_IO.SchDoc, OVERVIEW.SchDoc, PROM.SchDoc]
2024-01-29 fred: dump 2
    [ADC.SchDoc, FPGA_IO.SchDoc]
2024-01-29 TAG CONNECT, signing off
    [ADC.SchDoc, CLOCK.SchDoc, DAC.SchDoc, DDR3.SchDoc, ETHERNET.SchDoc, FPGA_MISC.SchDoc, INFO.SchDoc, MOTOR_CONTROL.SchDoc]
2024-01-30 some power
    [FPGA_MISC.SchDoc, POWER_DDR3.SchDoc, POWER_FPGA.SchDoc]
2024-01-30 FPGA IO page format
    [FPGA_IO.SchDoc]
2024-01-30 fred: prom done
    [FPGA_IO.SchDoc, FPGA_MISC.SchDoc, PROM.SchDoc]
2024-01-30 mechanical refactoring
    [MECHANICAL.SchDoc, OVERVIEW.SchDoc, PCB.PrjPcb, POWER.SchDoc, POWER_FPGA.SchDoc]
2024-01-30 fred: ethernet clean
    [ETHERNET.SchDoc, FPGA_IO.SchDoc, FPGA_MISC.SchDoc, PCB.PrjPcb]
2024-01-30 power notes
    [POWER_FPGA.SchDoc, POWER_SENSING.SchDoc]
2024-01-30 symbol phy
    [ETHERNET.SchDoc, PCB.PrjPcb, S7CAS_LIB2023.SchLib]
2024-01-30 current state of 'Net with no driving source'
    [FPGA_IO.SchDoc, POWER.SchDoc, POWER_FPGA.SchDoc, POWER_MOTORS.SchDoc]
2024-01-30 fpga footprint changed
    [FPGA_IO.SchDoc, FPGA_MISC.SchDoc, S7CAS_LIB2023.SchLib]
2024-01-30 Nets with no Driving Source
    [FPGA_MISC.SchDoc, INFO.SchDoc, OVERVIEW.SchDoc, PCB.PrjPcb, POWER_SENSING.SchDoc]
2024-01-30 sync 2
    [ETHERNET.SchDoc, FPGA_IO.SchDoc, POWER_MOTORS.SchDoc]
2024-01-30 input filtering
    [FPGA_MISC.SchDoc, POWER_INPUT.SchDoc, PROM.SchDoc]
2024-01-30 fred sync 3
    [DAC.SchDoc, ETHERNET.SchDoc, FPGA_IO.SchDoc, OVERVIEW.SchDoc, PROM.SchDoc]
2024-01-30 fred: sync 5 fgpa io
    [FPGA_IO.SchDoc, FPGA_MISC.SchDoc, OVERVIEW.SchDoc]
2024-01-30 sync 21h30
    [ADC.SchDoc, DAC.SchDoc, ETHERNET.SchDoc, FPGA_IO.SchDoc, FPGA_MISC.SchDoc, MOTOR_CONTROL.SchDoc, POWER_ANALOG.SchDoc, POWER_DDR3.SchDoc]
2024-01-30 current sensing refactor
    [ADC.SchDoc, OVERVIEW.SchDoc, POWER_FPGA.SchDoc, POWER_INPUT.SchDoc, POWER_SENSING.SchDoc]
2024-01-30 fred terminaisons ethernet RX
    [ETHERNET.SchDoc]
2024-01-30 adc term
    [ADC.SchDoc, MOTOR_CONTROL.SchDoc, POWER_INPUT.SchDoc, POWER_SENSING.SchDoc]
2024-01-30 PHY Terms
    [ETHERNET.SchDoc]
2024-01-30 sensing refactoring
    [PCB.PrjPcb, POWER_SENSING.SchDoc, Power.xlsx]
2024-01-30 fred ethernet cleanup layout
    [ETHERNET.SchDoc]
2024-01-30 fred: ethernet datasheet infos
    [ETHERNET.SchDoc]
2024-01-30 screw names
    [ADC.SchDoc, DDR3.SchDoc, ETHERNET.SchDoc, INFO.SchDoc, MOTOR_CONTROL.SchDoc, POWER.SchDoc, POWER_ANALOG.SchDoc, POWER_DDR3.SchDoc]
2024-01-30 fred power enable added
    [FPGA_IO.SchDoc, OVERVIEW.SchDoc, POWER.SchDoc]
2024-01-30 motor control thermal start
    [MOTOR_CONTROL.SchDoc, POWER.SchDoc, POWER_SENSING.SchDoc, Power.xlsx]
2024-01-30 motor drive thermal
    [MOTOR_CONTROL.SchDoc]
2024-01-30 getting on the DRC
    [DDR3.SchDoc, ETHERNET.SchDoc, MOTOR_CONTROL.SchDoc, POWER_MOTORS.SchDoc, POWER_SENSING.SchDoc, Power.xlsx]
2024-01-30 changing project topology
    [CLOCK.SchDoc, DAC.SchDoc, FPGA_IO.SchDoc, TITLE.SchDoc, USB.SchDoc]
2024-01-30 fixing variants, some prom
    [CLOCK.SchDoc, PCB.PrjPcb, POWER_SENSING.SchDoc, PROM.SchDoc, USB.SchDoc]
2024-01-30 io pin friends of everyone
    [FPGA_IO.SchDoc, PCB.PrjPcb]
2024-01-30 fred: netlist with multiple name
    [PCB.PrjPcb]
2024-01-30 fixing some DRC
    [CryptLib.SchLib, DDR3.SchDoc, MECHANICAL.SchDoc]
2024-01-30 fred: pg swap input for an output
    [POWER.SchDoc]
2024-01-30 IO refactoring
    [FPGA_IO.SchDoc, OVERVIEW.SchDoc, PCB.PrjPcb, POWER.SchDoc, Power.xlsx, USER_IO.SchDoc]
2024-01-30 only power sensing errors
    [DAC.SchDoc, DDR3.SchDoc, FPGA_IO.SchDoc, FPGA_MISC.SchDoc, MECHANICAL.SchDoc, MOTOR_CONTROL.SchDoc, OVERVIEW.SchDoc, PCB.PrjPcb]
2024-01-30 fixing some last errors
    [POWER_MOTORS.SchDoc, USER_IO.SchDoc]
2024-01-30 refactoring current sense
    [POWER_SENSING.SchDoc]
2024-01-30 final design review
    [ADC.SchDoc, CLOCK.SchDoc, DAC.SchDoc, DDR3.SchDoc, ETHERNET.SchDoc, FPGA_IO.SchDoc, FPGA_MISC.SchDoc, INFO.SchDoc]
2024-01-30 starting shunting
    [ETHERNET.SchDoc, OVERVIEW.SchDoc, POWER_ANALOG.SchDoc, POWER_DDR3.SchDoc, POWER_FPGA.SchDoc, POWER_MOTORS.SchDoc, POWER_SENSING.SchDoc, USB.SchDoc]
2024-01-30 shunting done
    [INFO.SchDoc, POWER_DDR3.SchDoc, POWER_FPGA.SchDoc, POWER_INPUT.SchDoc, USB.SchDoc]
2024-01-30 fred: excel
    [POWER.SchDoc]
2024-01-30 fred: power sensing done
    [POWER.SchDoc, POWER_SENSING.SchDoc]
2024-01-30 current sense motors
    [PCB.PrjPcb, POWER_INPUT.SchDoc, POWER_MOTORS.SchDoc]
2024-01-30 fred final final done done
    [POWER.SchDoc]
2024-01-30 current measurement motors
    [POWER_MOTORS.SchDoc]
2024-01-30 dernier commit APP1. Bonne nuit
    [ETHERNET.SchDoc, FPGA_IO.SchDoc, OVERVIEW.SchDoc, PCB.PrjPcb, POWER.SchDoc, POWER_MOTORS.SchDoc, POWER_SENSING.SchDoc, TITLE.SchDoc]
2024-01-30 ready for validation
    [ADC.SchDoc, CLOCK.SchDoc, DAC.SchDoc, ETHERNET.SchDoc, FPGA_IO.SchDoc, FPGA_MISC.SchDoc, INFO.SchDoc, MOTOR_CONTROL.SchDoc]
2024-01-30 M0 & M1
    [ADC.SchDoc, CLOCK.SchDoc, DAC.SchDoc, ETHERNET.SchDoc, FPGA_IO.SchDoc, MOTOR_CONTROL.SchDoc, PCB.PrjPcb, POWER_ANALOG.SchDoc]
2024-01-31 ajustements selon les commentaires de Florent et Charles
    [ETHERNET.SchDoc, FPGA_IO.SchDoc, POWER_SENSING.SchDoc]
2024-01-31 starting PCB, setup
    [PCB.PcbDoc, PCB.PrjPcb]
2024-02-01 starting OUTJOB
    [Bill of Materials-PCB(PCB_S7).xlsx]
2024-02-01 renaming project, removing it from CryptUS group, changing FPGA_IO page to template instead of ANSI D
    [FPGA_IO.SchDoc, PCB.PcbDoc, PCB.PrjPcb, Pleiades.PcbDoc, Pleiades_P01.PrjPcb]
2024-02-01 fixing some schematic errors
    [ADC.SchDoc, CLOCK.SchDoc, DAC.SchDoc, DDR3.SchDoc, ETHERNET.SchDoc, FPGA_MISC.SchDoc, MOTOR_CONTROL.SchDoc, POWER_ANALOG.SchDoc]
2024-02-01 adding SD card, fixing variants, starting to fix shunts
    [CLOCK.SchDoc, DDR3.SchDoc, ETHERNET.SchDoc, FPGA_IO.SchDoc, FPGA_MISC.SchDoc, INFO.SchDoc, MECHANICAL.SchDoc, OVERVIEW.SchDoc]
2024-02-01 fixing last errors, schematic now compiles without any warning or error messages
    [ETHERNET.SchDoc, INFO.SchDoc, MOTOR_CONTROL.SchDoc, POWER_ANALOG.SchDoc, POWER_DDR3.SchDoc, POWER_FPGA.SchDoc, POWER_INPUT.SchDoc, POWER_MOTORS.SchDoc]
2024-02-01 added screws to BOM
    [FPGA_MISC.SchDoc, MOTOR_CONTROL.SchDoc]
2024-02-02 SERIAL NUMBER IC
    [ETHERNET.SchDoc, FPGA_IO.SchDoc, FPGA_MISC.SchDoc, OVERVIEW.SchDoc, POWER_ANALOG.SchDoc, POWER_DDR3.SchDoc, POWER_FPGA.SchDoc, POWER_MOTORS.SchDoc]
2024-02-02 added TestPoint class, added IO header
    [ADC.SchDoc, CLOCK.SchDoc, DAC.SchDoc, ETHERNET.SchDoc, FPGA_IO.SchDoc, FPGA_MISC.SchDoc, INFO.SchDoc, MECHANICAL.SchDoc]
2024-02-03 fixing last ECO errors
    [MOTOR_CONTROL.SchDoc, POWER_INPUT.SchDoc, POWER_SENSING.SchDoc, Pleiades.PcbDoc, Pleiades_P01.PrjPcb, S7CAS_LIB2023.SchLib, USB.SchDoc, USER_IO.SchDoc]
2024-02-03 importing components for layout
    [POWER_INPUT.SchDoc, POWER_SENSING.SchDoc, Pleiades_P01.PrjPcb, USER_IO.SchDoc]
2024-02-11 yeah I accidentally did some PCIe, sorry
    [ADC.SchDoc, CLOCK.SchDoc, DAC.SchDoc, DDR3.SchDoc, ETHERNET.SchDoc, FPGA_IO.SchDoc, FPGA_MISC.SchDoc, INFO.SchDoc]
2024-02-13 DDR3 terminations with more caps, watchdog timer
    [ADC.SchDoc, CLOCK.SchDoc, DAC.SchDoc, DDR3.SchDoc, ETHERNET.SchDoc, FPGA_IO.SchDoc, FPGA_MISC.SchDoc, MOTOR_CONTROL.SchDoc]
2024-02-13 changed all testpoint symbols
    [ADC.SchDoc, CLOCK.SchDoc, DAC.SchDoc, ETHERNET.SchDoc, FPGA_IO.SchDoc, FPGA_MISC.SchDoc, INFO.SchDoc, MECHANICAL.SchDoc]
2024-02-13 PCIe isolation; IO card
    [ADC.SchDoc, CLOCK.SchDoc, DAC.SchDoc, ETHERNET.SchDoc, FPGA_IO.SchDoc, INFO.SchDoc, MOTOR_CONTROL.SchDoc, OVERVIEW.SchDoc]
2024-02-13 Board Dimensions (PCI card)
2024-02-16 keepout border; input differential-mode filter
    [ADC.SchDoc, DAC.SchDoc, ETHERNET.SchDoc, INFO.SchDoc, MOTOR_CONTROL.SchDoc, PCI.SchDoc, POWER_ANALOG.SchDoc, POWER_DDR3.SchDoc]
2024-02-16 added fan
    [ADC.SchDoc, CLOCK.SchDoc, DAC.SchDoc, ETHERNET.SchDoc, FPGA_IO.SchDoc, FPGA_MISC.SchDoc, INFO.SchDoc, MOTOR_CONTROL.SchDoc]
2024-02-16 making sure there are no errors ; adding 2 screw holes
    [ADC.SchDoc, CLOCK.SchDoc, DAC.SchDoc, DDR3.SchDoc, ETHERNET.SchDoc, FPGA_IO.SchDoc, FPGA_MISC.SchDoc, MECHANICAL.SchDoc]
2024-02-16 configuring outjob
    [Bill of Materials-PCB(PCB_S7).xlsx, POWER_INPUT.SchDoc, Pleiades.PcbDoc, Pleiades.step, Pleiades_P01.PrjPcb]
2024-02-16 last checkup before starting APP2
    [CLOCK.SchDoc, ETHERNET.SchDoc, FPGA_IO.SchDoc, OVERVIEW.SchDoc, PCI.SchDoc, POWER_SENSING.SchDoc, Pleiades.PcbDoc, Pleiades.step]
2024-02-16 starting APP2
    [POWER_INPUT.SchDoc, Pleiades.PcbDoc, Pleiades_P01.PrjPcb]
2024-02-17 chocolat blanc et stackup done
    [Pleiades.PcbDoc]
2024-02-17 vias done
    [Pleiades.PcbDoc, Pleiades_P01.PrjPcb]
2024-02-17 vias library format
    [Pleiades.PcbDoc]
2024-02-17 fred: fin des design rules
    [ADC.SchDoc, DAC.SchDoc, DDR3.SchDoc, FPGA_MISC.SchDoc]
2024-02-17 mounting holes and fiducials
2024-02-17 testpoints and touches
    [DDR3.SchDoc, FPGA_MISC.SchDoc, MECHANICAL.SchDoc, MOTOR_CONTROL.SchDoc, Pleiades_P01.PrjPcb, S7CAS_LIB2023.SchLib]
2024-02-18 placement SMA
    [ADC.SchDoc, Pleiades_P01.PrjPcb]
2024-02-20 fred: started placement power input
2024-02-20 changing heatsink, DDR data groups
    [CryptLib.SchLib, DDR3.SchDoc, FPGA_MISC.SchDoc]
2024-02-20 splitting into PCBs
    [Pleiades_P01.PrjPcb]
2024-02-21 pin swapping, changed DDR footprint, PP: DQL
    [DDR3.SchDoc, FPGA_MISC.SchDoc]
2024-02-21 isolated motor & can GNDs
    [MOTOR_CONTROL.SchDoc]
2024-02-21 PP: Initial FPGA fanout
    [Pleiades_P01.PrjPcb]
2024-02-21 PP: DDR Squiguellis done
    [DDR3.SchDoc]
2024-02-22 fin des squiguellis
2024-02-22 PP: terminaisons DDR
    [DDR3.SchDoc, FPGA_MISC.SchDoc]
2024-02-23 PP: VTT
    [POWER_DDR3.SchDoc]
2024-02-23 PP: DDR3 Power Done
    [INFO.SchDoc, MOTOR_CONTROL.SchDoc, POWER_ANALOG.SchDoc, POWER_DDR3.SchDoc, POWER_FPGA.SchDoc, POWER_INPUT.SchDoc, POWER_MOTORS.SchDoc]
2024-02-25 PP: motor control
    [MECHANICAL.SchDoc, MOTOR_CONTROL.SchDoc]
2024-02-25 PP: PCI
    [PCI.SchDoc, POWER_DDR3.SchDoc, Pleiades_P01.PrjPcb]
2024-02-25 PP: USB
    [USB.SchDoc]
2024-02-25 PP: Motor power sensing
    [POWER_MOTORS.SchDoc, USB.SchDoc]
2024-02-27 Changing 470nF from 0805 to 0603
    [ADC.SchDoc, DDR3.SchDoc, ETHERNET.SchDoc, FPGA_MISC.SchDoc, INFO.SchDoc, POWER_ANALOG.SchDoc, POWER_DDR3.SchDoc, POWER_FPGA.SchDoc]
2024-02-28 Net Ties for DDR ACC
    [DDR3.SchDoc, INFO.SchDoc, POWER_ANALOG.SchDoc, POWER_DDR3.SchDoc, POWER_FPGA.SchDoc, POWER_INPUT.SchDoc, POWER_MOTORS.SchDoc]
2024-02-28 PP: DDR Terminations
    [DDR3.SchDoc]
2024-02-28 PP: Analog Power
    [POWER_ANALOG.SchDoc]
2024-02-28 PP: Fan
    [PROM.SchDoc]
2024-02-28 On retire les condensateurs vers VDDR de VTT
    [DDR3.SchDoc]
2024-02-29 PP: Re-term'd
    [DDR3.SchDoc]
2024-02-29 ADC input
    [ADC.SchDoc, DDR3.SchDoc]
2024-03-01 PP: DAC Output
    [ADC.SchDoc, DAC.SchDoc]
2024-03-03 PP: DAC
    [ADC.SchDoc, DAC.SchDoc, INFO.SchDoc]
2024-03-03 PP: Réparation squigguelis ACC avec heatsink qui coupais (merci Flo)
2024-03-04 PP: USB, JTAG, SD, IO
    [FPGA_MISC.SchDoc, S7CAS_LIB2023.SchLib, USER_IO.SchDoc]
2024-03-04 PP: IO, 5V
2024-03-04 PP: Fixing TAG-CONNECT (Fred pull Raeslib et update le footprint du Tag-Connect ya pas de soldermask
2024-03-04 PP: Connecting mounting holes
    [MECHANICAL.SchDoc]
2024-03-04 fred: switch laptop -> tour
2024-03-04 fred: started to place capacitors for ddr3
2024-03-05 PP: analog current sensing
    [POWER_SENSING.SchDoc]
2024-03-05 PP: Osc, Clock Decoupling
    [CLOCK.SchDoc]
2024-03-06 updating footprints pour frouf
2024-03-08 PP: Deplacement PROM, fin fanout, fix SD
    [FPGA_MISC.SchDoc, OVERVIEW.SchDoc, USER_IO.SchDoc]
2024-03-09 PP: Cap 470nF now 0402 (from 0603
    [ADC.SchDoc, DDR3.SchDoc, FPGA_MISC.SchDoc, INFO.SchDoc, POWER_ANALOG.SchDoc, POWER_DDR3.SchDoc, POWER_FPGA.SchDoc, POWER_INPUT.SchDoc]
2024-03-09 debug adc
2024-03-09 PP: FPGA decoupling
    [DDR3.SchDoc, FPGA_IO.SchDoc, FPGA_MISC.SchDoc, INFO.SchDoc, Pleiades_P01.PrjPcb]
2024-03-09 PP: FPGA Power
    [FPGA_MISC.SchDoc, POWER_FPGA.SchDoc]
2024-03-09 PP: Power sensing
    [POWER_SENSING.SchDoc]
2024-03-09 PP: Placement fini
    [CLOCK.SchDoc, DAC.SchDoc, FPGA_IO.SchDoc, FPGA_MISC.SchDoc, MOTOR_CONTROL.SchDoc, PCI.SchDoc, POWER_ANALOG.SchDoc, POWER_MOTORS.SchDoc]
2024-03-09 PP: GND
2024-03-09 PP: Mounting holes, fiducials, clearances
2024-03-09 PP: Motor routing
    [MOTOR_CONTROL.SchDoc]
2024-03-09 fred adc
2024-03-09 fred: adc placements
2024-03-09 PP: Power sensing Kelvin classes, motor finished
    [INFO.SchDoc, POWER_MOTORS.SchDoc, POWER_SENSING.SchDoc]
2024-03-09 PP: Power Input
2024-03-09 SD, FAN, IO, Some Power, LEDs
2024-03-09 fixing warnings in Power Sensing and Clock
    [CLOCK.SchDoc, POWER_SENSING.SchDoc]
2024-03-09 progress a little bit of everywhere, currently working on ADC
2024-03-10 fred: adc & dac avancements
2024-03-10 PP: Working on ADC
    [ADC.SchDoc, S7CAS_LIB2023.SchLib]
2024-03-10 working on PCI
    [PCI.SchDoc, S7CAS_LIB2023.SchLib]
2024-03-10 adjusting impedances LVDS100 for Frouf's board
2024-03-10 Lots of decoupling, PCI completed
    [PCI.SchDoc]
2024-03-10 fred resotre power sensing not to be diff pairs
2024-03-10 fred: power ddr done | started motor
2024-03-10 PP: Power Done
2024-03-11 Sensing Diff Pairs
    [ADC.SchDoc, DAC.SchDoc, FPGA_IO.SchDoc, POWER.SchDoc, POWER_ANALOG.SchDoc, POWER_DDR3.SchDoc, POWER_FPGA.SchDoc, POWER_INPUT.SchDoc]
2024-03-11 PP: PROM Squigguelled
    [FPGA_IO.SchDoc, PROM.SchDoc]
2024-03-11 PP: IO
    [FPGA_IO.SchDoc, POWER_FPGA.SchDoc]
2024-03-11 Ready for DAC squigguellis
    [DAC.SchDoc, FPGA_IO.SchDoc]
2024-03-11 DAC Squiguellis
    [FPGA_IO.SchDoc]
2024-03-11 ADC 50%
    [FPGA_IO.SchDoc]
2024-03-11 ADC routed
    [FPGA_IO.SchDoc]
2024-03-11 fred: power presque done
2024-03-11 ADC Squiggellis
    [ADC.SchDoc]
2024-03-11 Debug IO
    [FPGA_IO.SchDoc]
2024-03-11 a little bit of power sensing
2024-03-12 power sensing, working on MII
    [ETHERNET.SchDoc, FPGA_IO.SchDoc]
2024-03-12 fred: free cad done
    [legros.-Body.step, legros..FCStd]
2024-03-12 SD Card and FAN
    [FPGA_IO.SchDoc, OVERVIEW.SchDoc, Pleiades_P01.PrjPcb, USER_IO.SchDoc]
2024-03-12 fred: updated heatsink
    [legros.-Body.step, legros..FCStd]
2024-03-12 MII Lenght Matching, CANBUS
2024-03-12 PLL, EN
    [FPGA_IO.SchDoc]
2024-03-12 Done with all major traces
    [FPGA_IO.SchDoc]
2024-03-12 Bon matin
    [BOM.xlsx, Pleiades_P01.PrjPcb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]
2024-04-04 ICM20948 IMU; Opto-isolation on IO
    [FPGA_IO.SchDoc, OVERVIEW.SchDoc, POWER_SENSING.SchDoc, Pleiades_P01.PrjPcb, SENSORS.SchDoc, USER_IO.SchDoc]
2024-04-09 switching to revision B
    [ETHERNET.SchDoc, FPGA_MISC.SchDoc, INFO.SchDoc, Pleiades_P01.PrjPcb, SENSORS.SchDoc]
2024-04-10 new JTAG Selection with buffers and switches instead of jumpers
    [ETHERNET.SchDoc, FPGA_MISC.SchDoc, INFO.SchDoc, JTAG.SchDoc, OVERVIEW.SchDoc, PROM.SchDoc, Pleiades_P01.PrjPcb]
2024-04-15 Annotate ; Layout Import ; RTC Layout ; Power Imput Compression
    [ADC.SchDoc, CLOCK.SchDoc, DAC.SchDoc, ETHERNET.SchDoc, FPGA_IO.SchDoc, FPGA_MISC.SchDoc, INFO.SchDoc, JTAG.SchDoc]
2024-04-17 compressing POWER and MOTORS
    [INFO.SchDoc, POWER_INPUT.SchDoc, POWER_MOTORS.SchDoc]
2024-04-17 compressing CANBUS
2024-04-24 CAN Power compression, Some motor wiring
    [MOTOR_CONTROL.SchDoc, OVERVIEW.SchDoc]
